Fabien-Chouteau/Wee-Noise-Maker/README.md

The [PGB-1 Firmware is now hosted on a different repo](https://github.com/wee-noise-makers/WNM-PGB1-firmware).
