Fabien-Chouteau/Wee-Noise-Maker/docs/media/pictures/discovery/discovery_rev_A_2.JPG

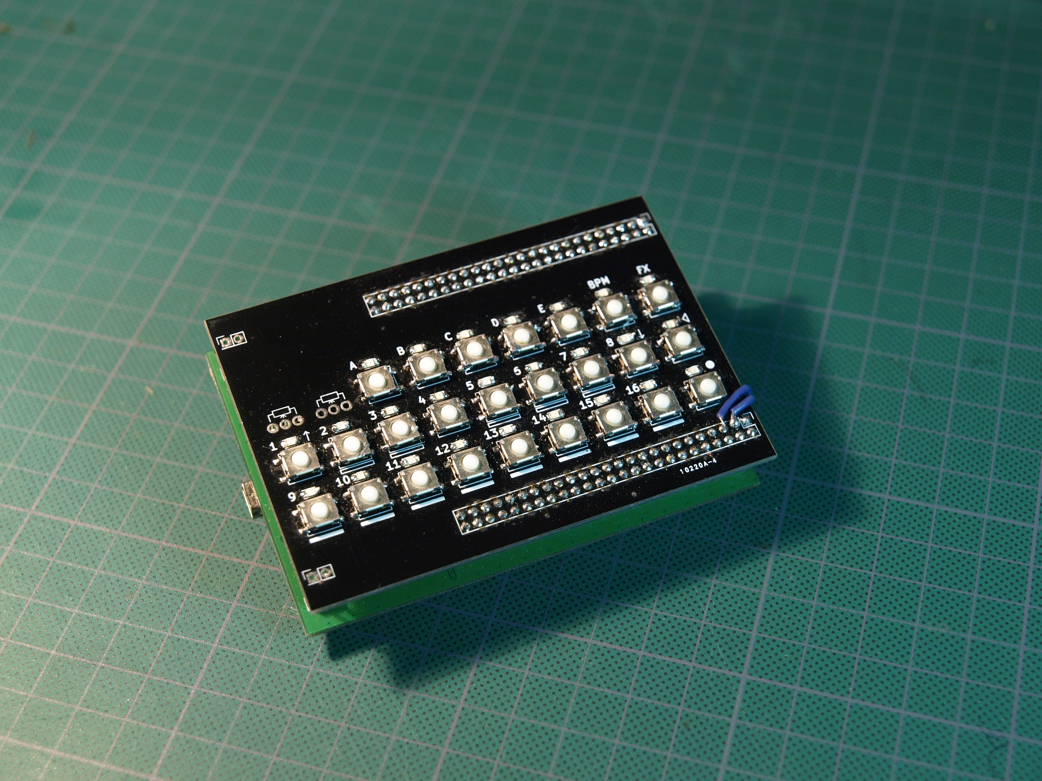
docs/media/pictures/discovery/discovery_rev_A_2.JPG
