Fabien-Chouteau/Wee-Noise-Maker/docs/media/pictures/discovery/discovery_rev_A_3.JPG

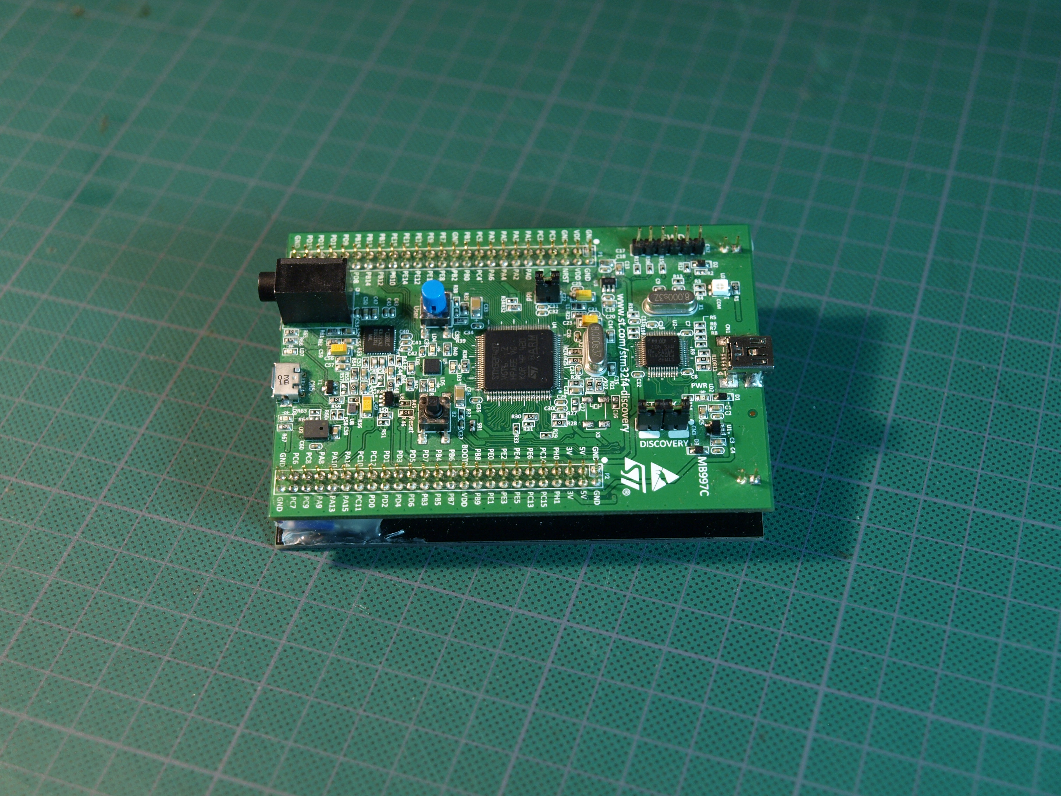
docs/media/pictures/discovery/discovery_rev_A_3.JPG
