Fabien-Chouteau/Wee-Noise-Maker/docs/media/pictures/discovery/discovery_rev_B_BB_1.JPG

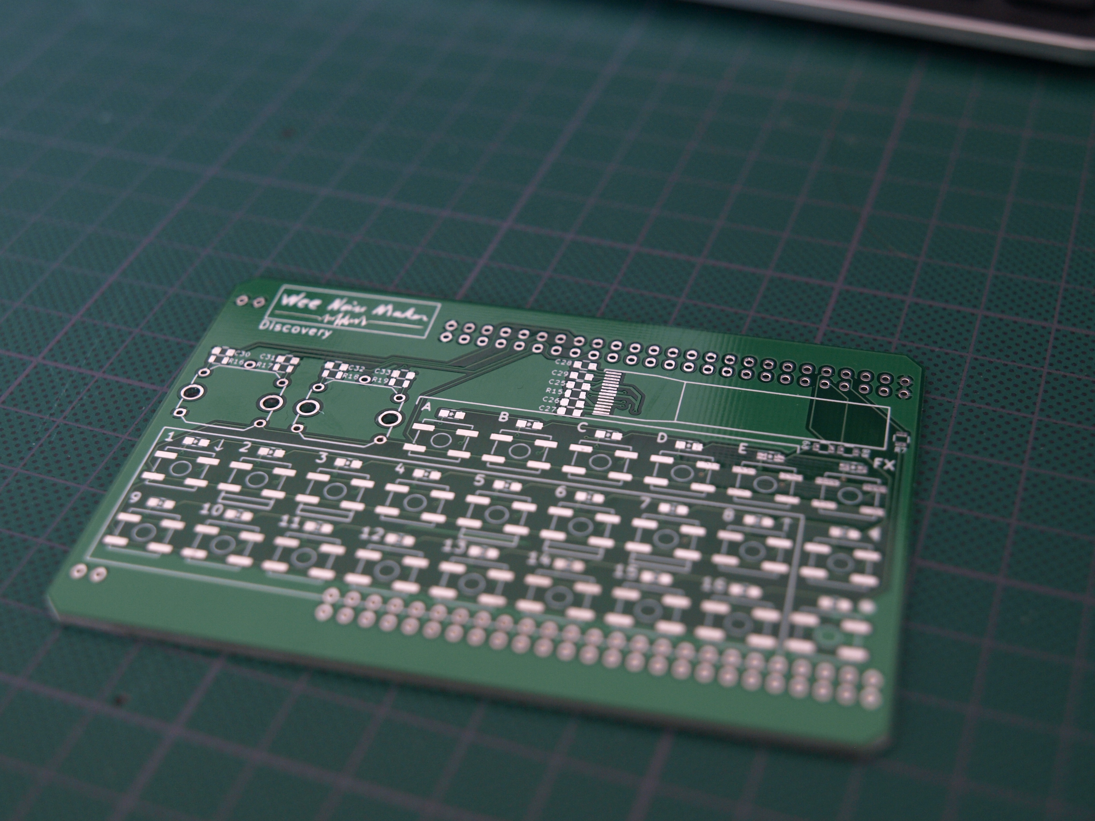
docs/media/pictures/discovery/discovery_rev_B_BB_1.JPG
