Fabien-Chouteau/Wee-Noise-Maker/docs/media/pictures/discovery/discovery_rev_B_BB_3.JPG

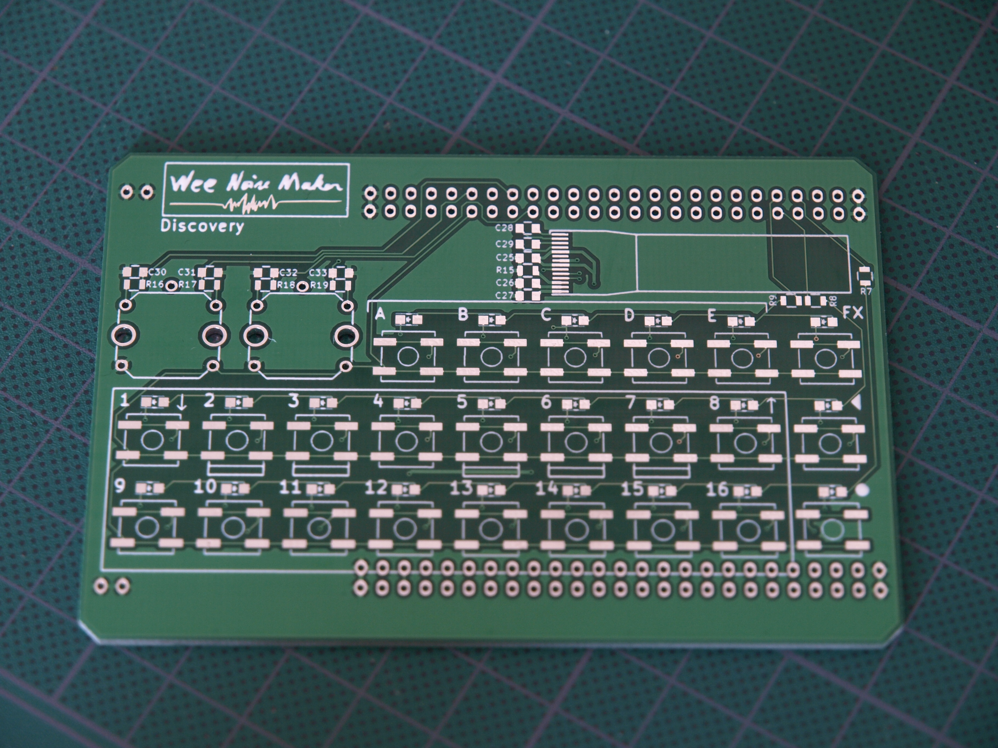
docs/media/pictures/discovery/discovery_rev_B_BB_3.JPG
