Fabien-Chouteau/Wee-Noise-Maker/docs/media/pictures/Mk-I/Mk-I_rev_B_BB_1.JPG

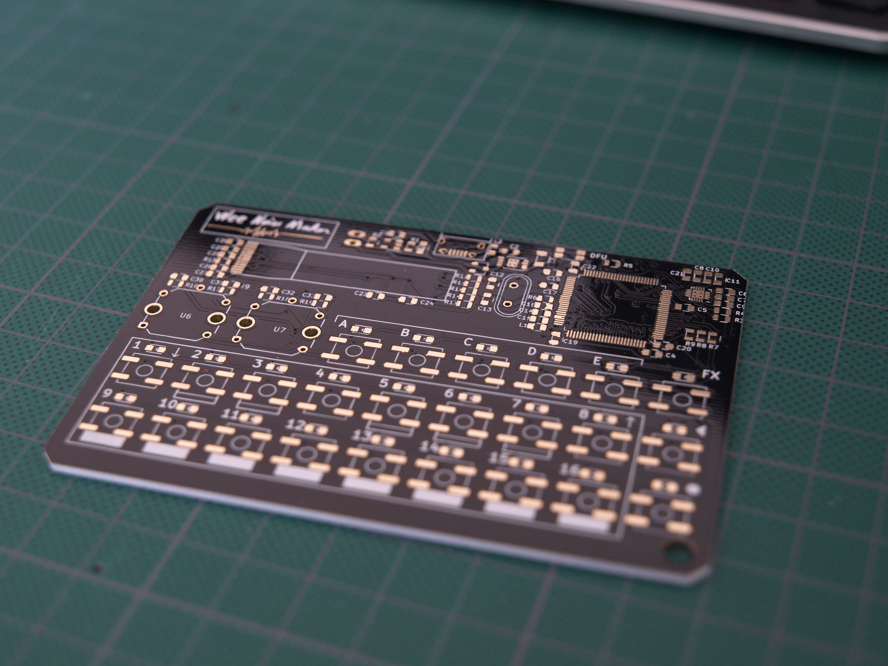
docs/media/pictures/Mk-I/Mk-I_rev_B_BB_1.JPG
