Fabien-Chouteau/Wee-Noise-Maker/docs/media/pictures/Mk-I/Mk-I_rev_B_BB_2.JPG

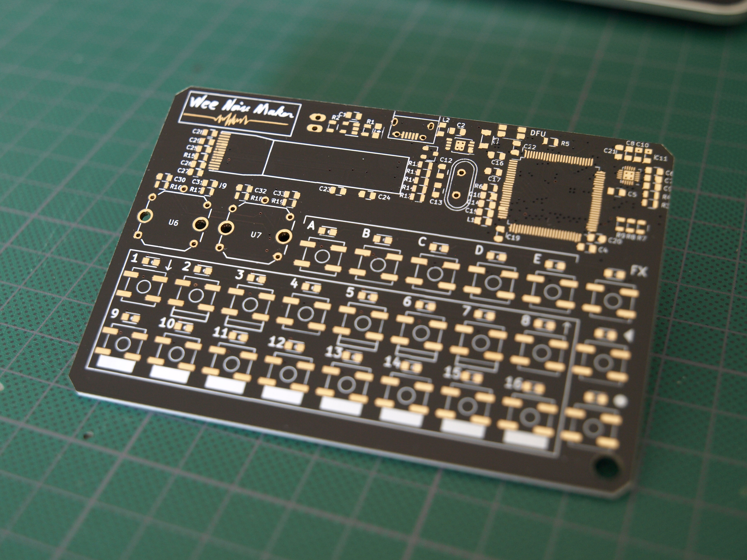
docs/media/pictures/Mk-I/Mk-I_rev_B_BB_2.JPG
