Fabien-Chouteau/Wee-Noise-Maker/docs/media/pictures/Mk-I/Mk-I_rev_C_4.JPG

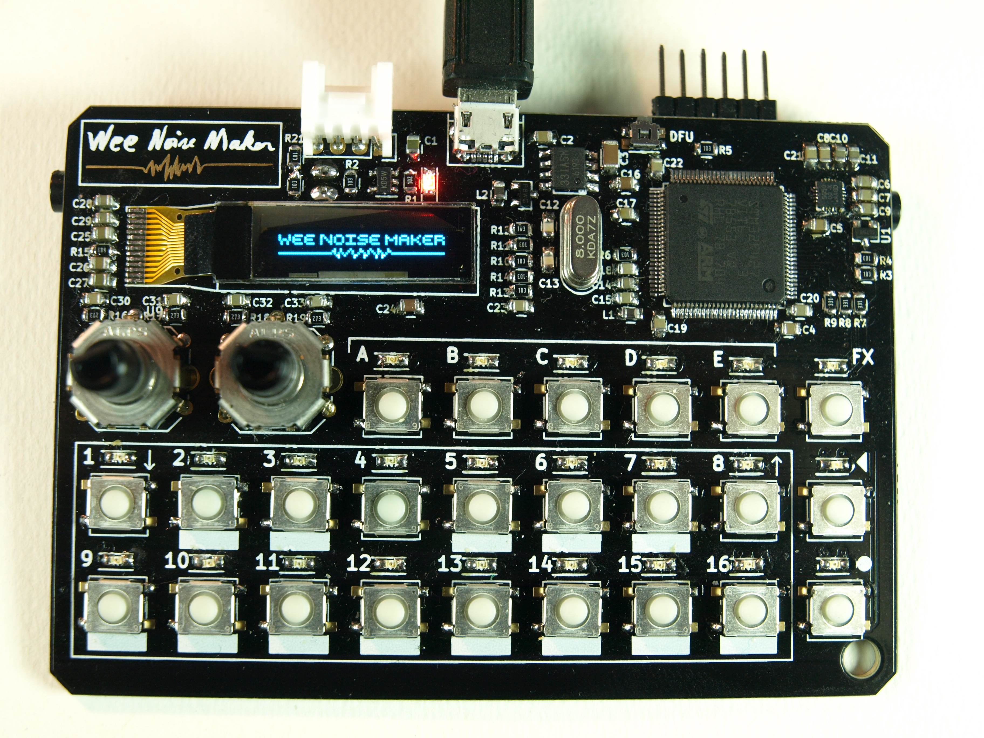
docs/media/pictures/Mk-I/Mk-I_rev_C_4.JPG
