Fabien-Chouteau/Wee-Noise-Maker/docs/media/pictures/Mk-I/Mk-I_rev_C_5.JPG

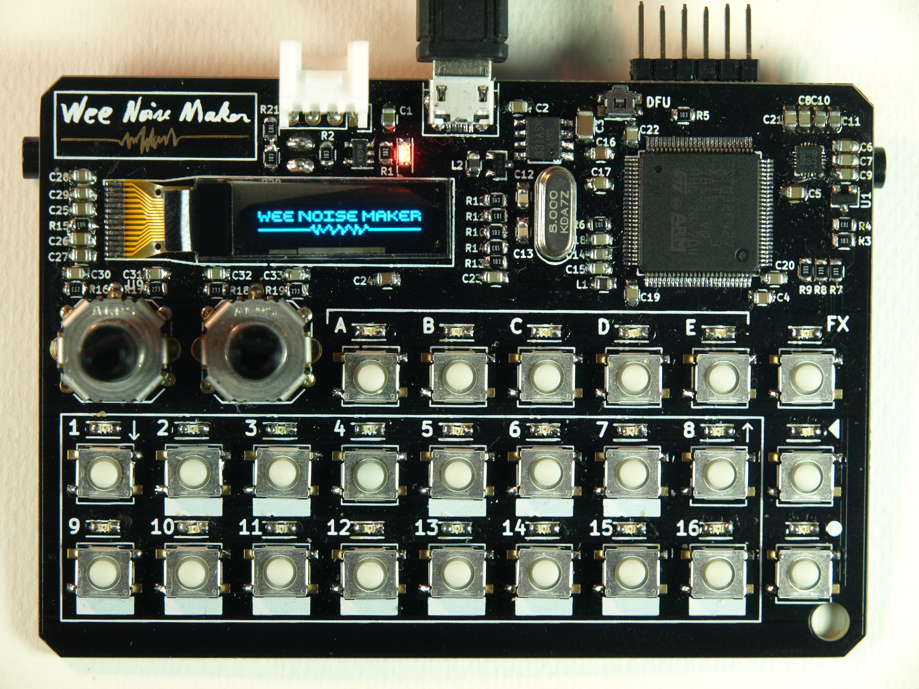
docs/media/pictures/Mk-I/Mk-I_rev_C_5.JPG
