Fabien-Chouteau/Wee-Noise-Maker/hardware/3D_models/for_print/crank.stl

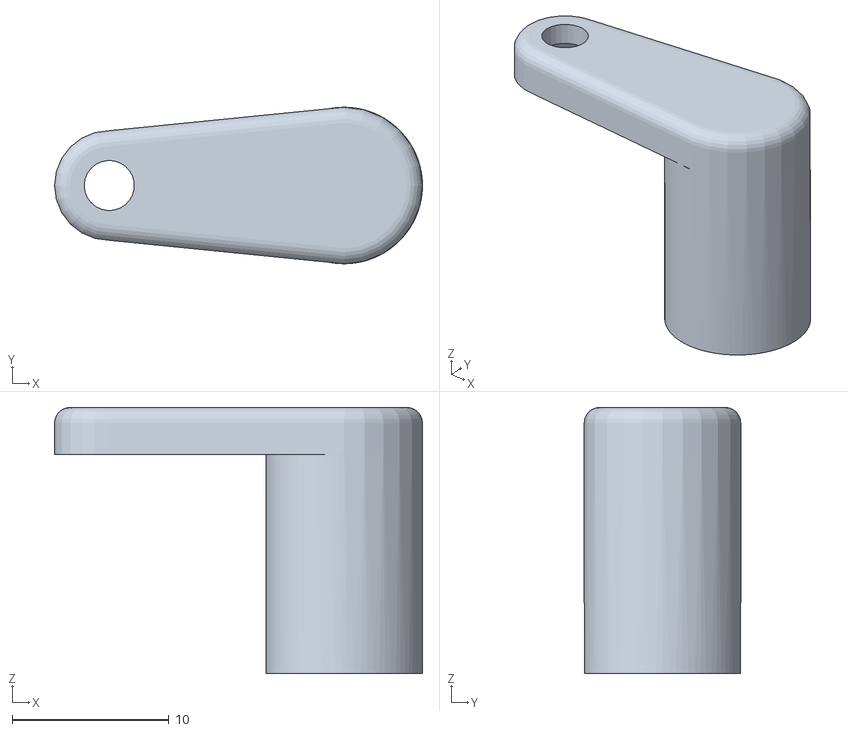
[picture p18: CAD file, 2017-01-17]
hardware/3D_models/for_print/crank.stl
23.5 x 10.0 x 17.0
