Fabien-Chouteau/Wee-Noise-Maker/hardware/3D_models/SJ_352X_SMT.fcstd

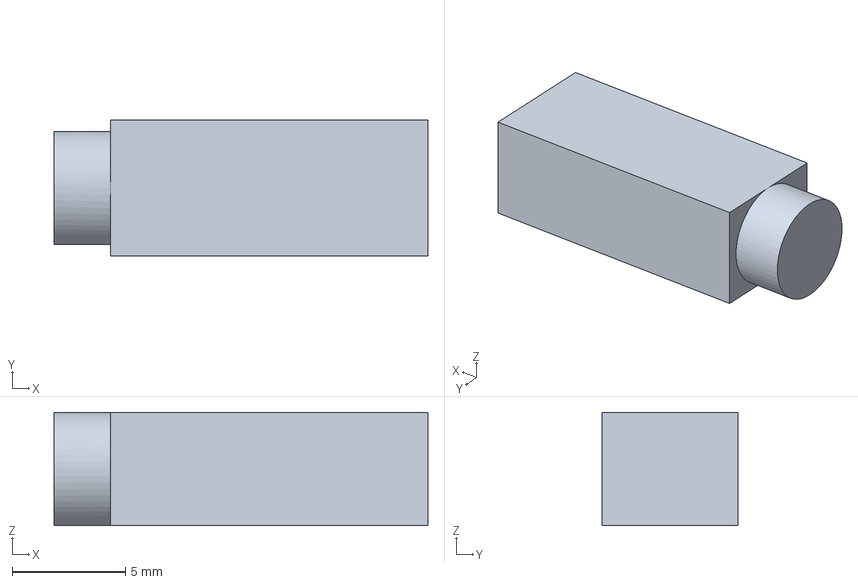
[picture p19: CAD file, 2017-10-22]
hardware/3D_models/SJ_352X_SMT.fcstd
16.5 x 6.00 x 5.00 mm
