Fabien-Chouteau/Wee-Noise-Maker/hardware/3D_models/EC12D_knob.FCStd

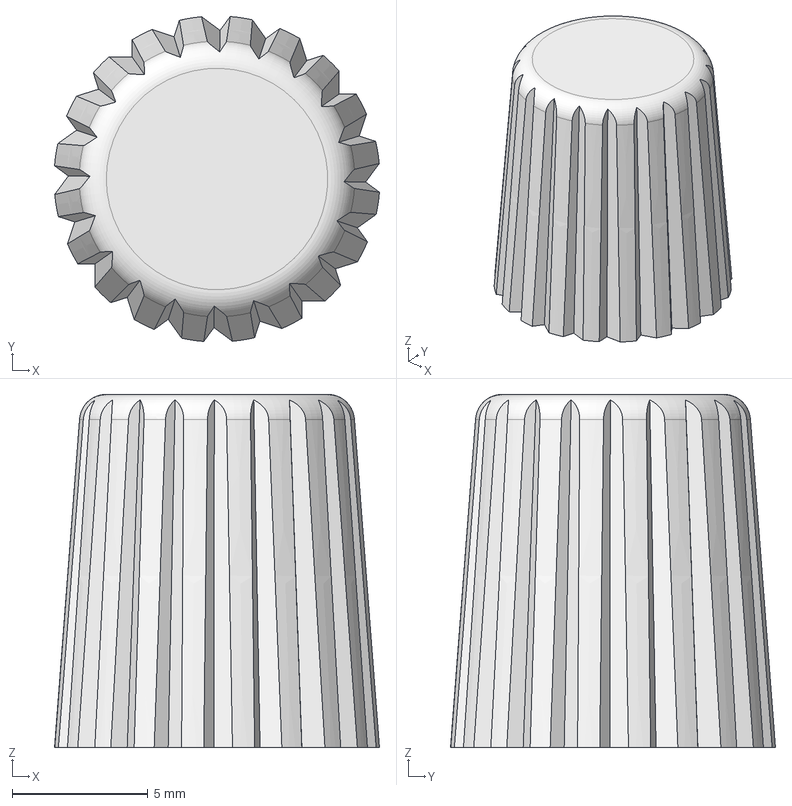
[picture p20: CAD file, 2017-01-17]
hardware/3D_models/EC12D_knob.FCStd
12.0 x 12.0 x 13.0 mm
