Fabien-Chouteau/Wee-Noise-Maker/hardware/3D_models/EC12D_crank.FCStd

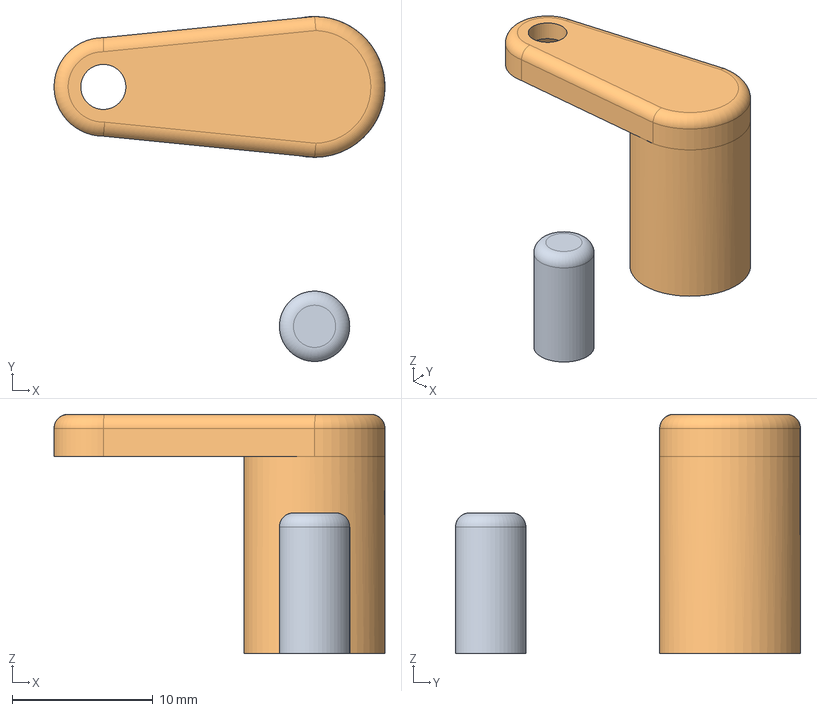
[picture p21: CAD file, 2017-01-17]
hardware/3D_models/EC12D_crank.FCStd
23.5 x 24.5 x 17.0 mm
