Fabien-Chouteau/Wee-Noise-Maker/hardware/3D_models/for_print/crank_knob.stl

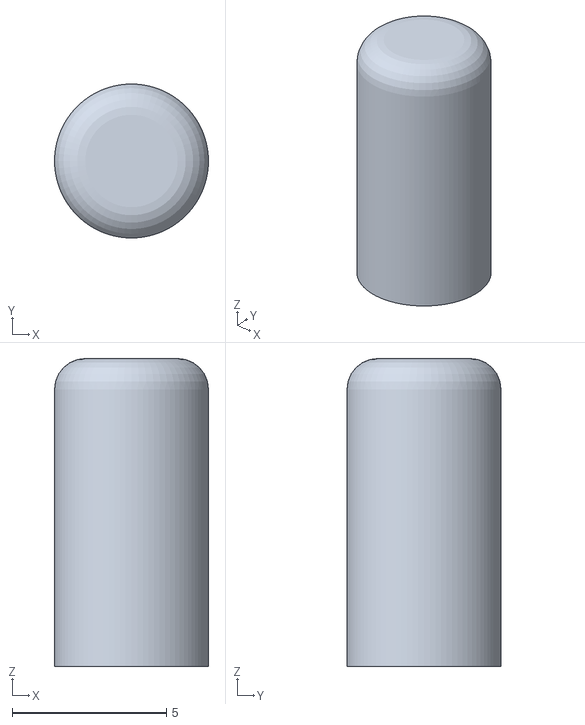
[picture p22: CAD file, 2017-01-17]
hardware/3D_models/for_print/crank_knob.stl
5.00 x 5.00 x 10.0
