Fabien-Chouteau/Wee-Noise-Maker/hardware/3D_models/EC12D.FCStd

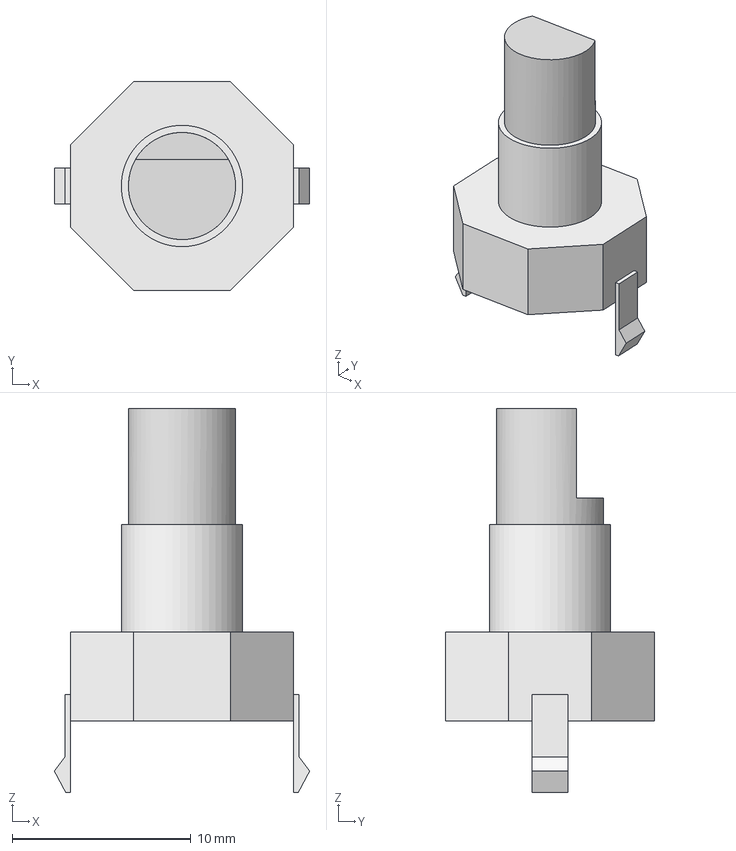
[picture p23: CAD file, 2017-01-05]
hardware/3D_models/EC12D.FCStd
14.3 x 11.7 x 21.5 mm
Mirror of Pocket002
