Fabien-Chouteau/Wee-Noise-Maker/(list of files, cad)

Other CAD files:
hardware/3D_models/for_print/knob.stl
