Fabien-Chouteau/Wee-Noise-Maker/hardware/discovery/Rev_B/wnm_discovery_Rev_B_schematics.pdf

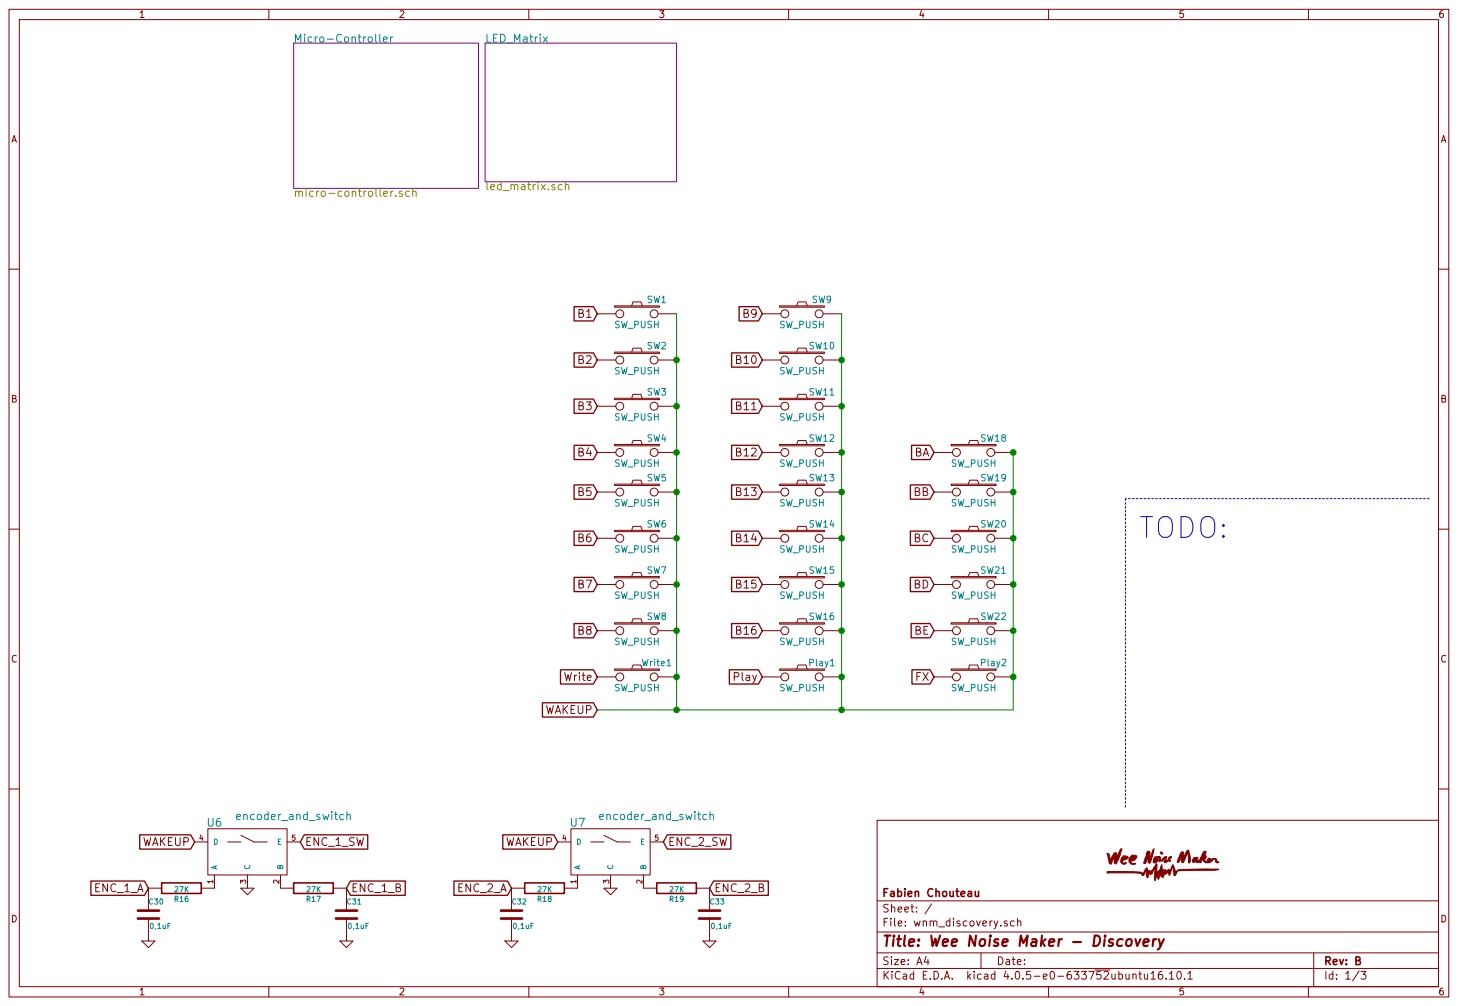
[picture p24: page 1]

File: wnm_discovery.sch Sheet: / Fabien Chouteau

Id: 1/3 Title: Wee Noise Maker - Discovery

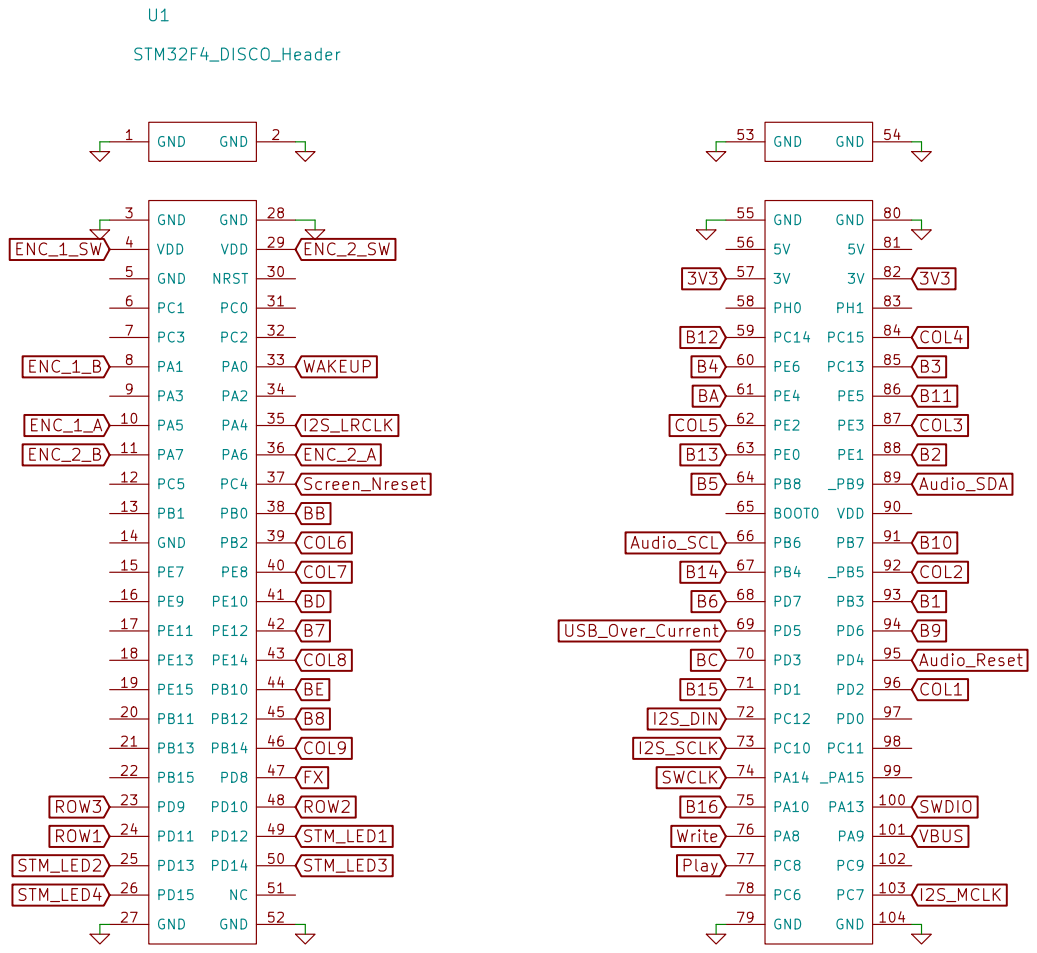
[picture p25: page 2]

File: micro-controller.sch Sheet: /Micro-Controller/ Fabien Chouteau

Id: 2/3 Title: Wee Noise Maker - Discovery

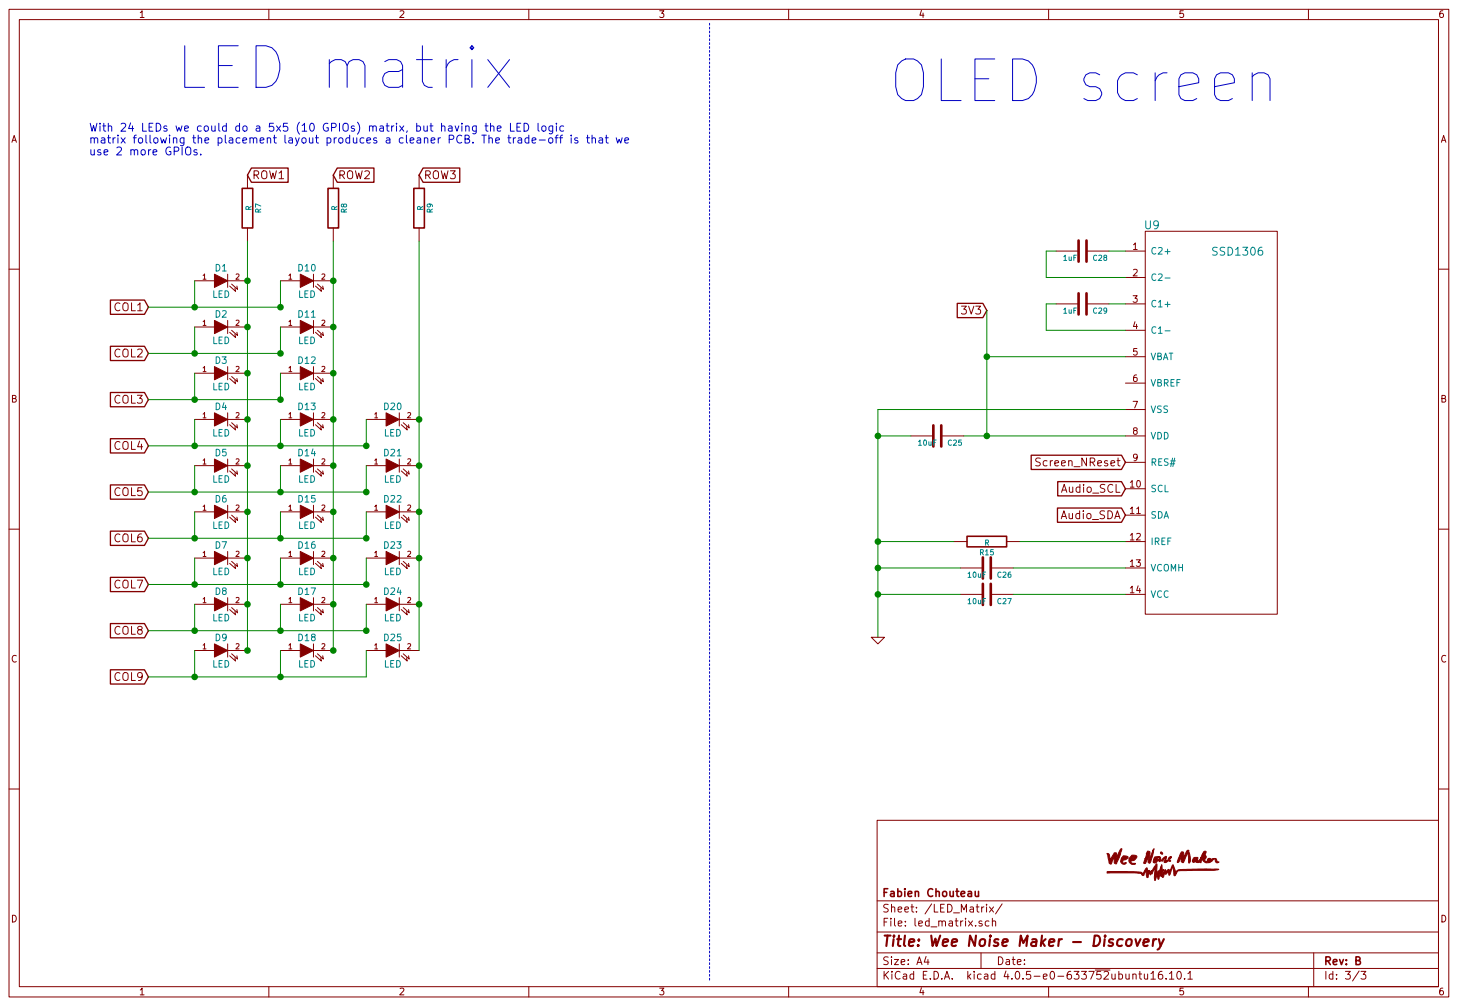
[picture p26: page 3]

With 24 LEDs we could do a 5x5 (10 GPIOs) matrix, but having the LED logic
matrix following the placement layout produces a cleaner PCB. The trade-off is that we

File: led_matrix.sch
Id: 3/3 Title: Wee Noise Maker - Discovery
