Fabien-Chouteau/Wee-Noise-Maker/hardware/Mk-I/Rev_D/wnm_mk_1_rev_D_layout.pdf

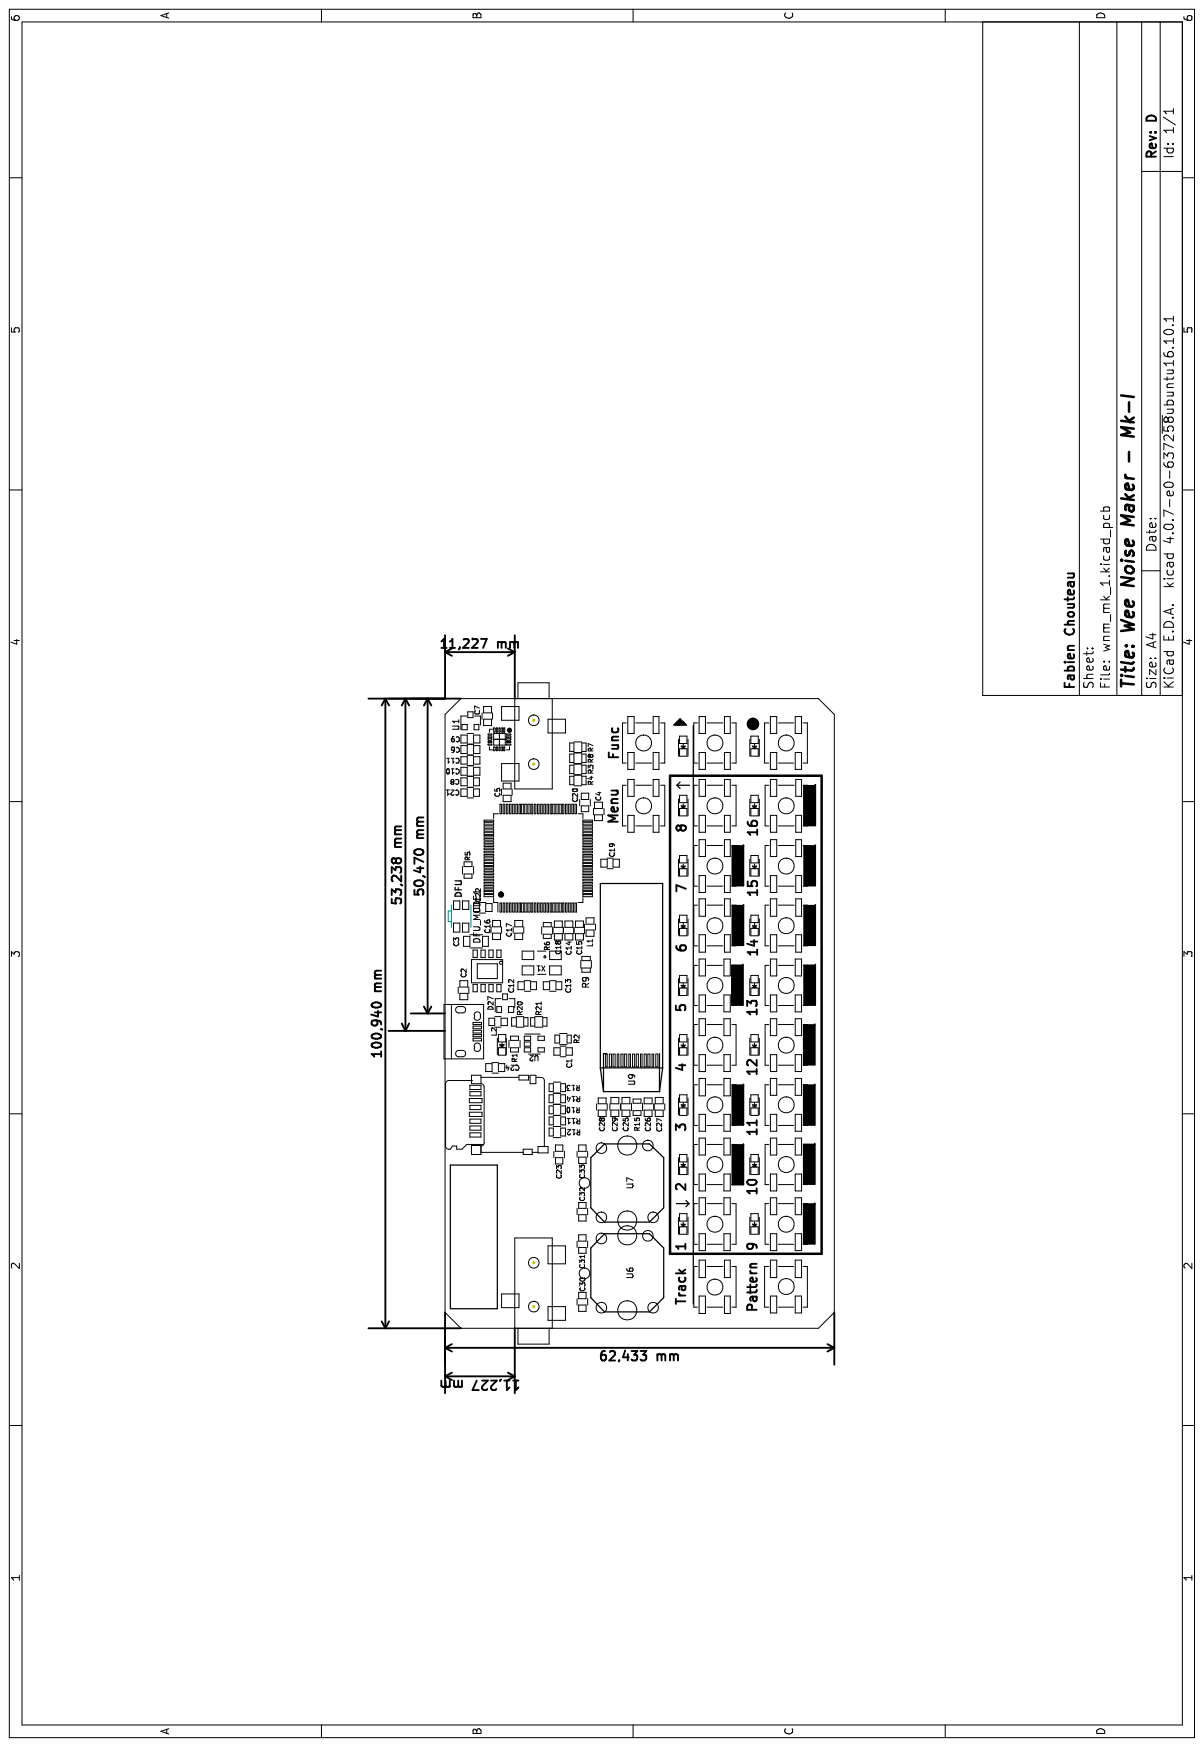
[picture p27: page 1]
