Fabien-Chouteau/Wee-Noise-Maker/hardware/Mk-I/Rev_C/wnm_mk_1_rev_C_schematics.pdf

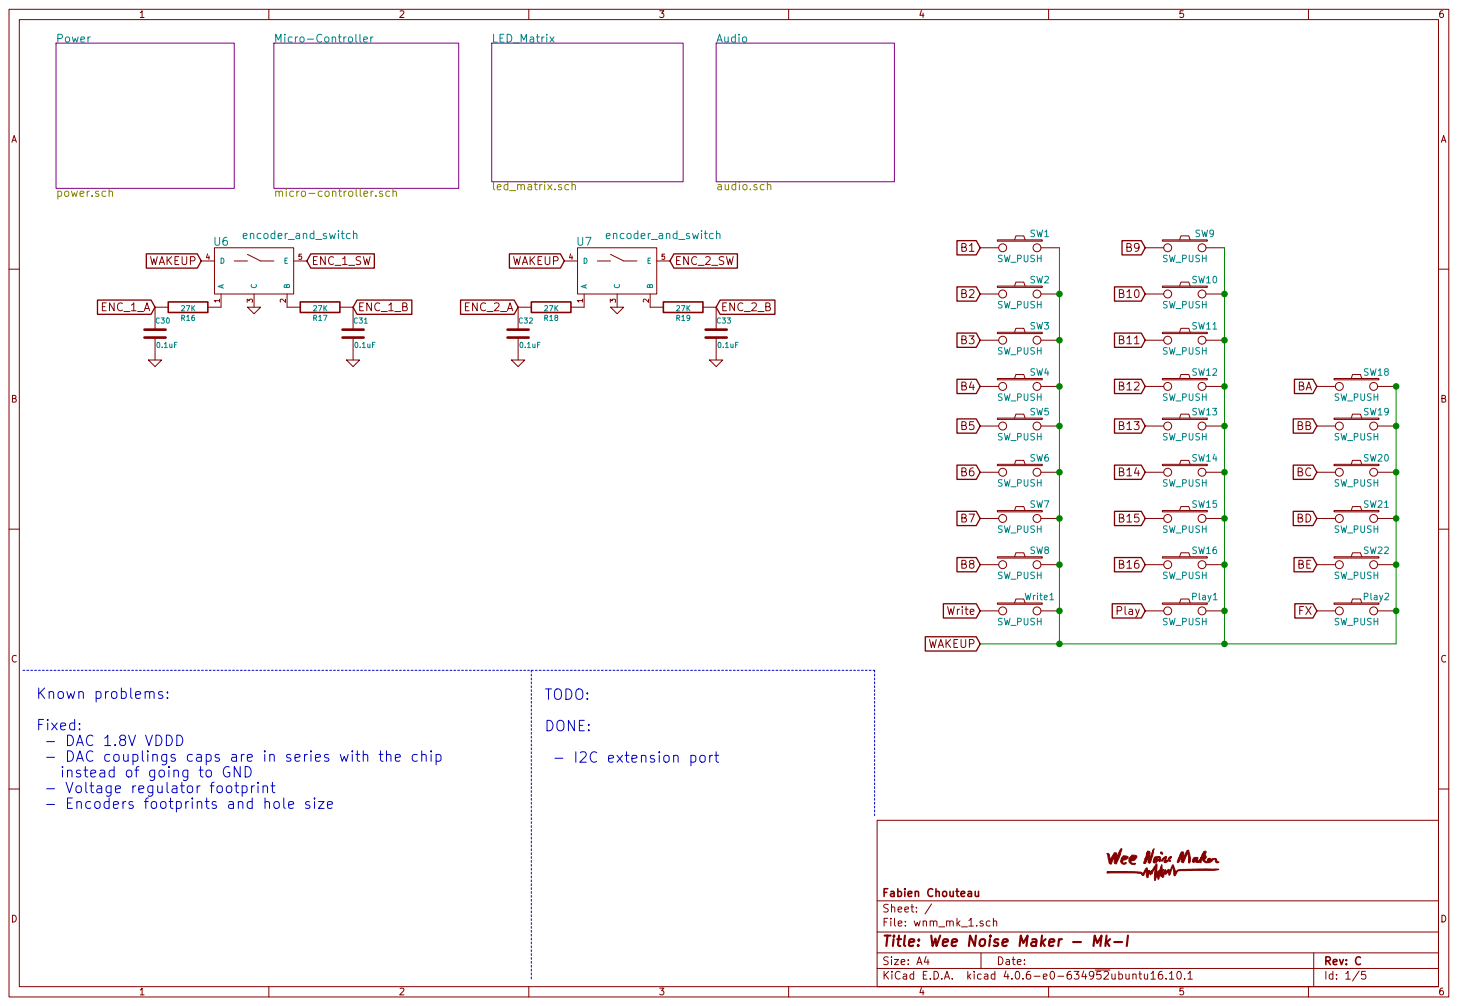
[picture p34: page 1]

Micro-Controller micro-controller.sch

Known problems:
Fixed:
- DAC 1.8V VDDD
- DAC couplings caps are in series with the chip
instead of going to GND
- Voltage regulator footprint
- Encoders footprints and hole size

File: wnm_mk_1.sch Sheet: / Fabien Chouteau

Id: 1/5 Title: Wee Noise Maker - Mk-I

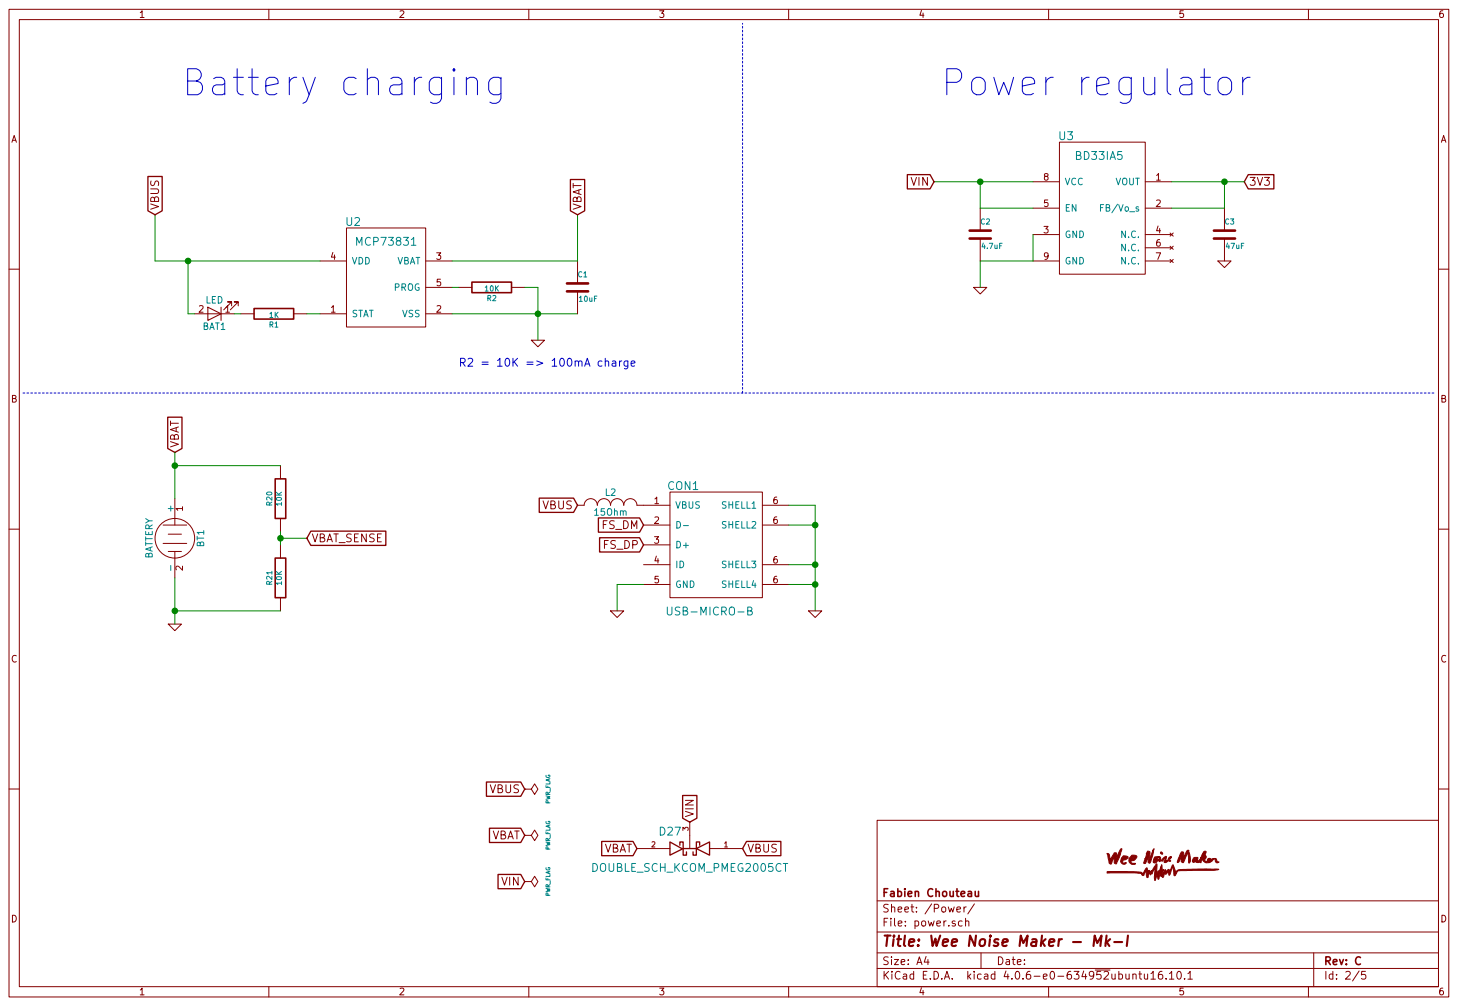
[picture p35: page 2]

File: power.sch Sheet: /Power/ Fabien Chouteau

Id: 2/5 Title: Wee Noise Maker - Mk-I

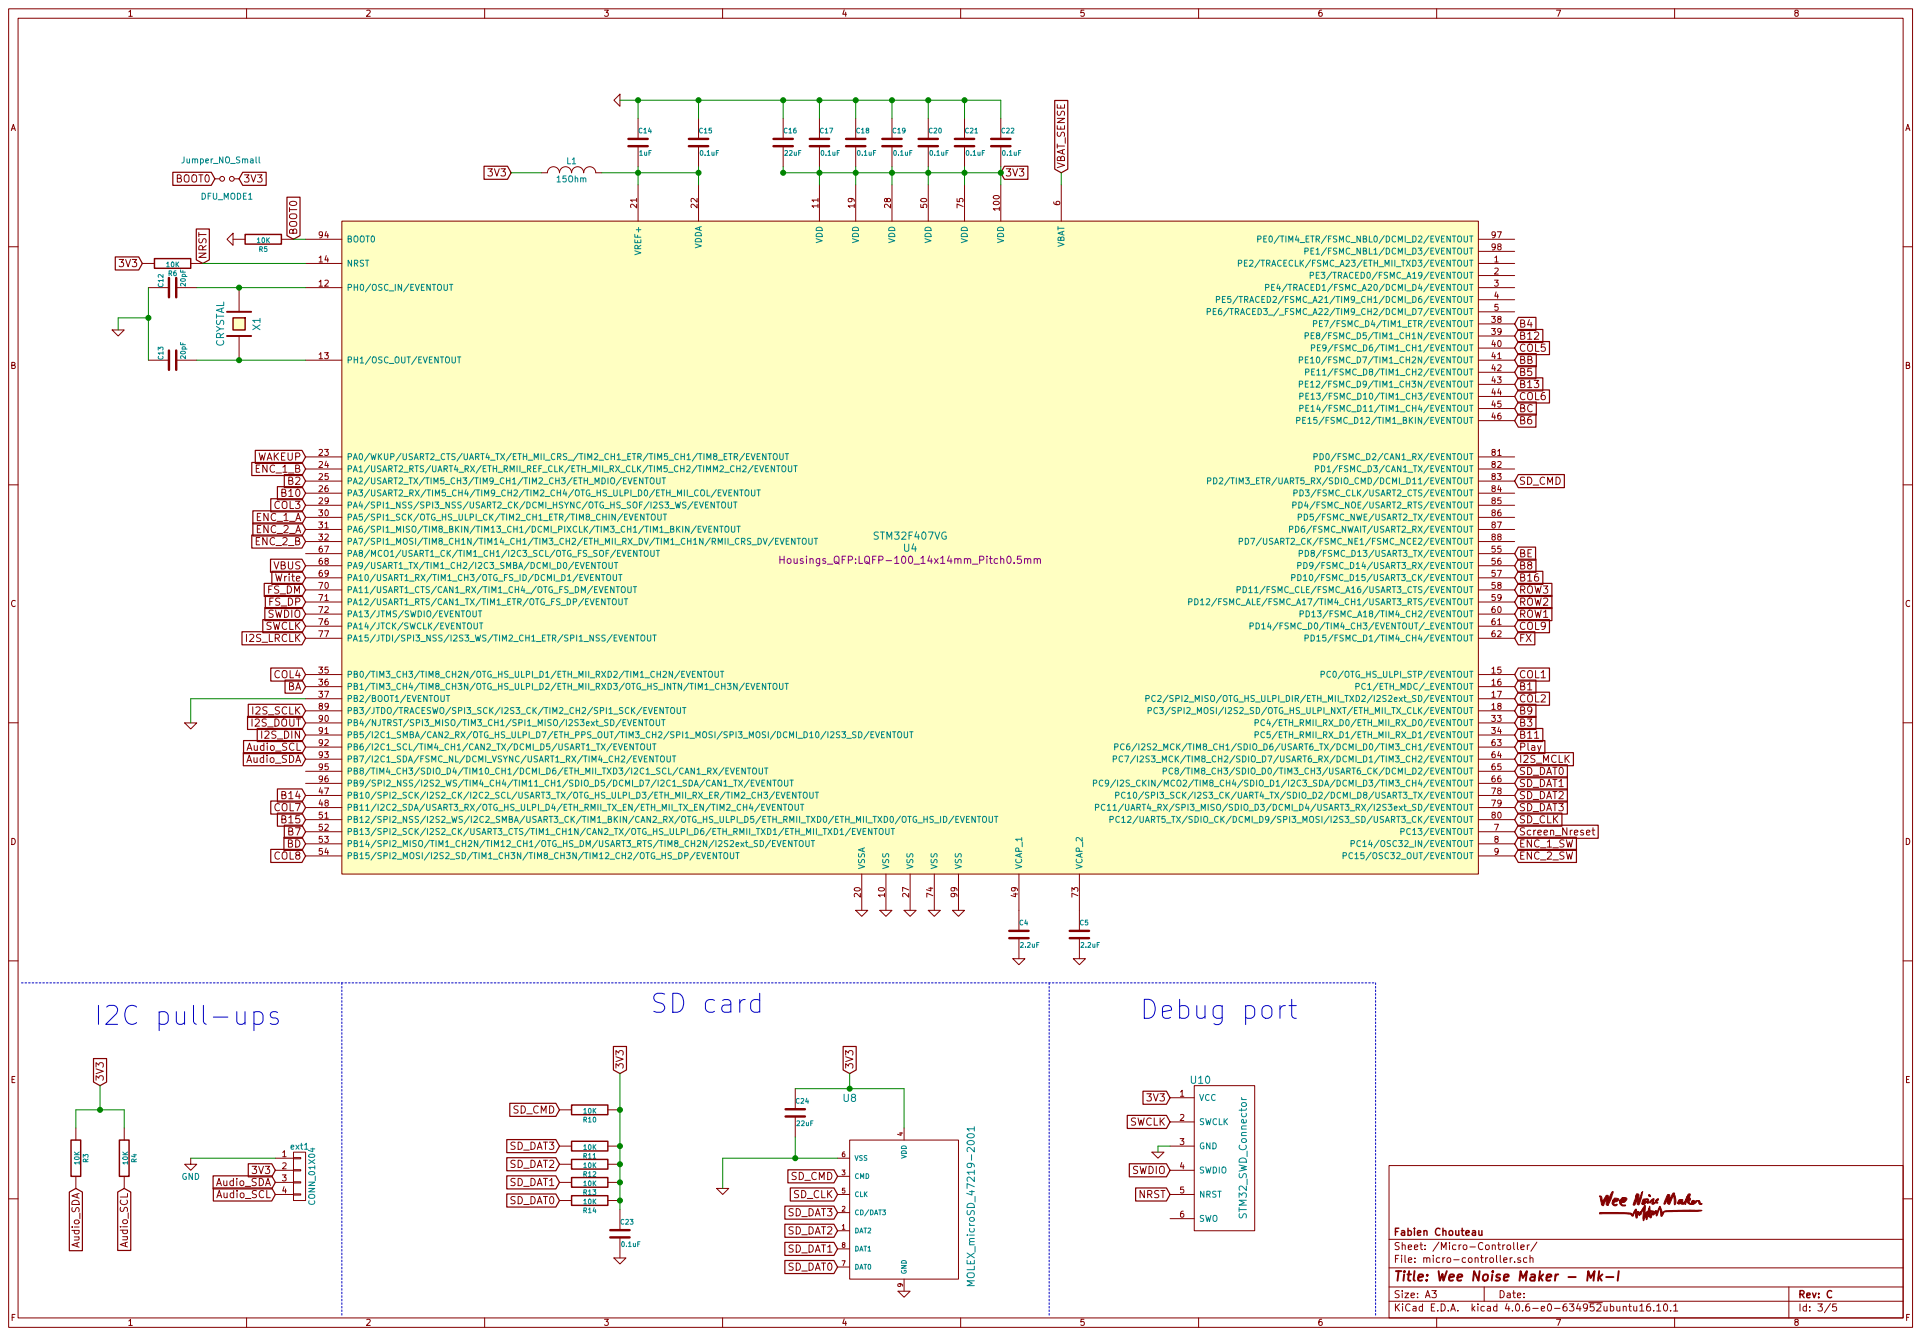
[picture p36: page 3]

6 PC13/EVENTOUT 7 PC14/OSC32_IN/EVENTOUT 8 PC15/OSC32_OUT/EVENTOUT 9 VSS 10 VSSA 20

Id: 3/5 Title: Wee Noise Maker - Mk-I File: micro-controller.sch Sheet: /Micro-Controller/ Fabien Chouteau

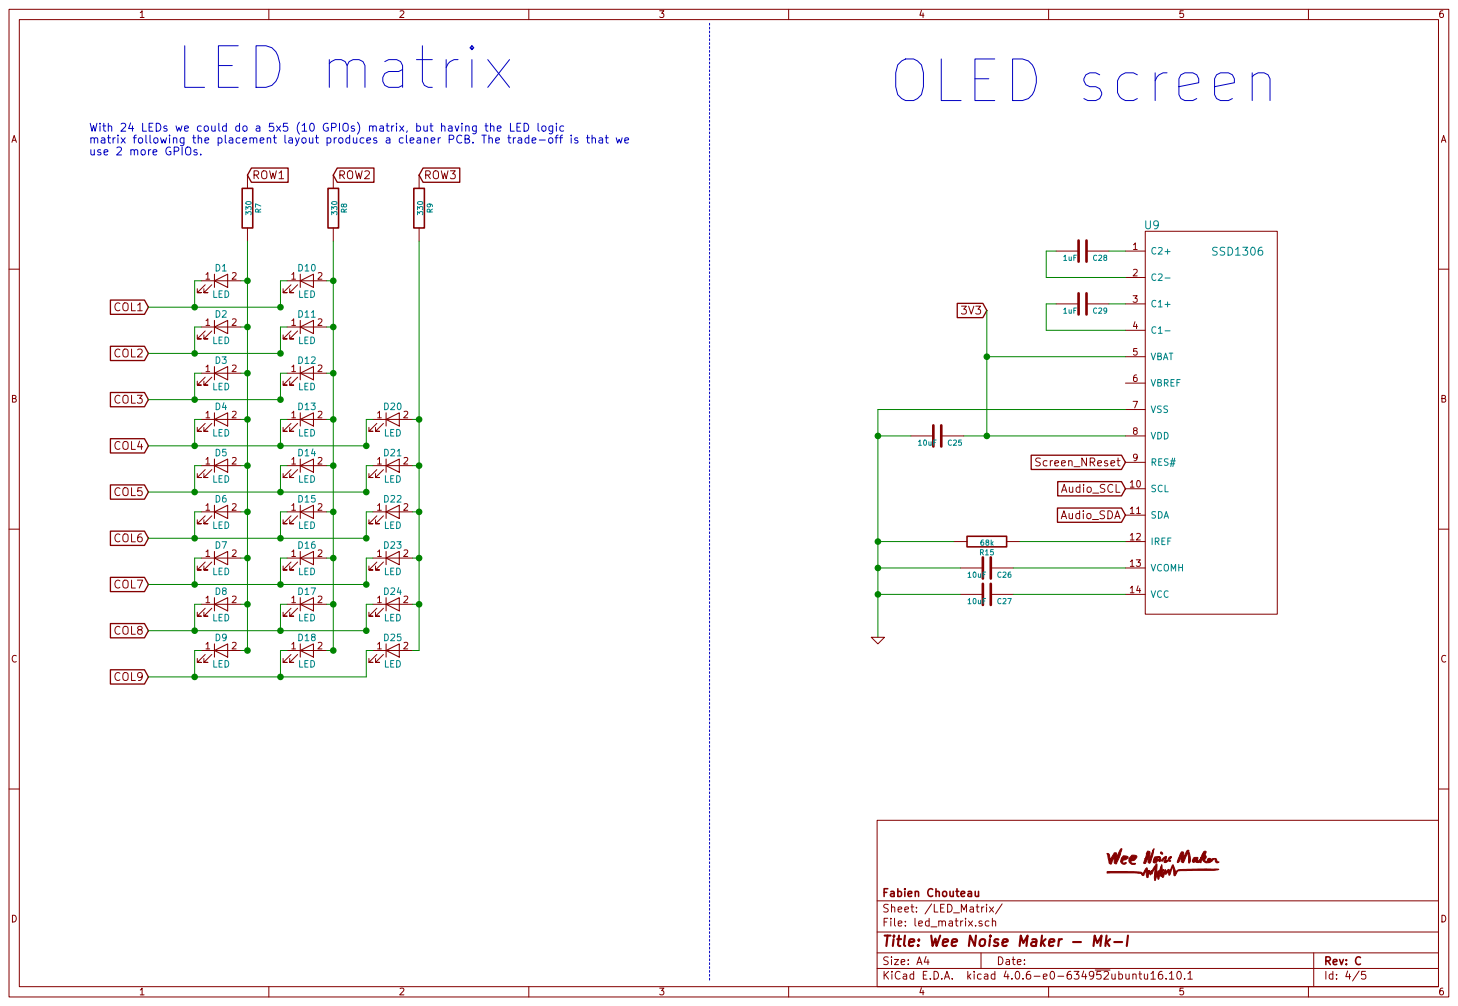
[picture p37: page 4]

With 24 LEDs we could do a 5x5 (10 GPIOs) matrix, but having the LED logic
matrix following the placement layout produces a cleaner PCB. The trade-off is that we

10uF C25 R15 Audio_SDA

File: led_matrix.sch
Id: 4/5 Title: Wee Noise Maker - Mk-I

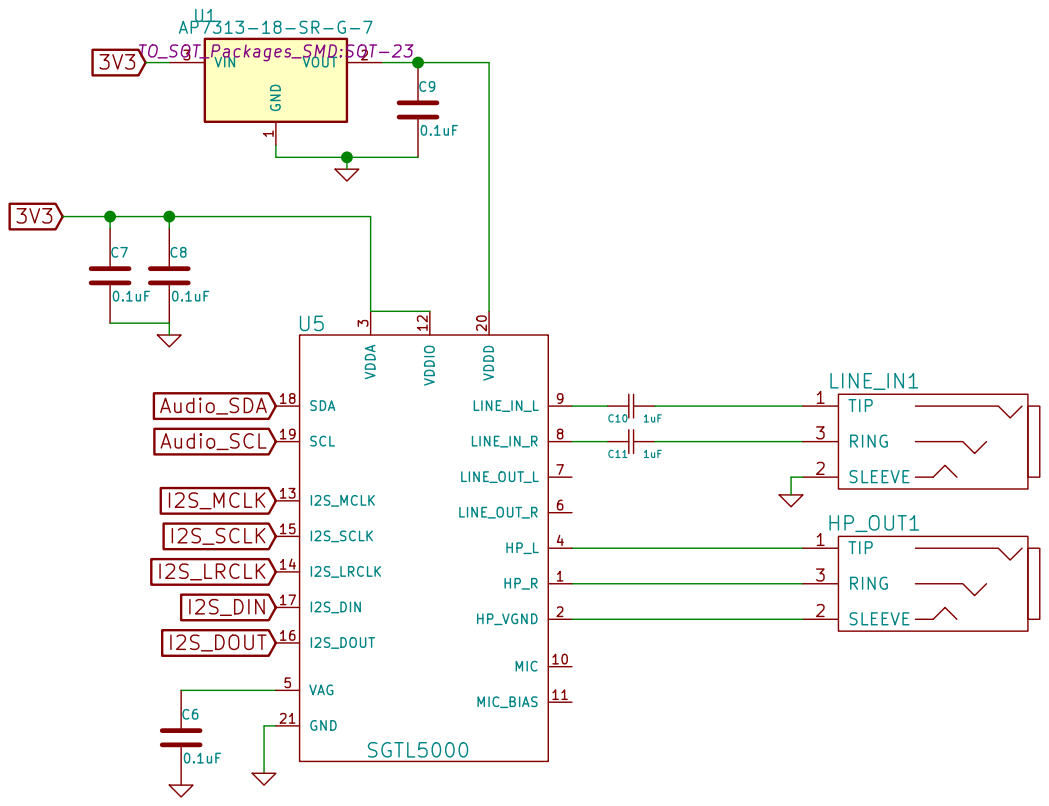
[picture p38: page 5]

1 VOUT 2 VIN 3 U1AP7313-18-SR-G-7 TO_SOT_Packages_SMD:SOT-23 3V3

Id: 5/5 Title: Wee Noise Maker - Mk-I File: audio.sch Sheet: /Audio/ Fabien Chouteau Audio_SDA
Audio_SCL
