Fabien-Chouteau/Wee-Noise-Maker/hardware/Mk-I/Rev_A/wnm_mk_1_rev_A_schematics.pdf

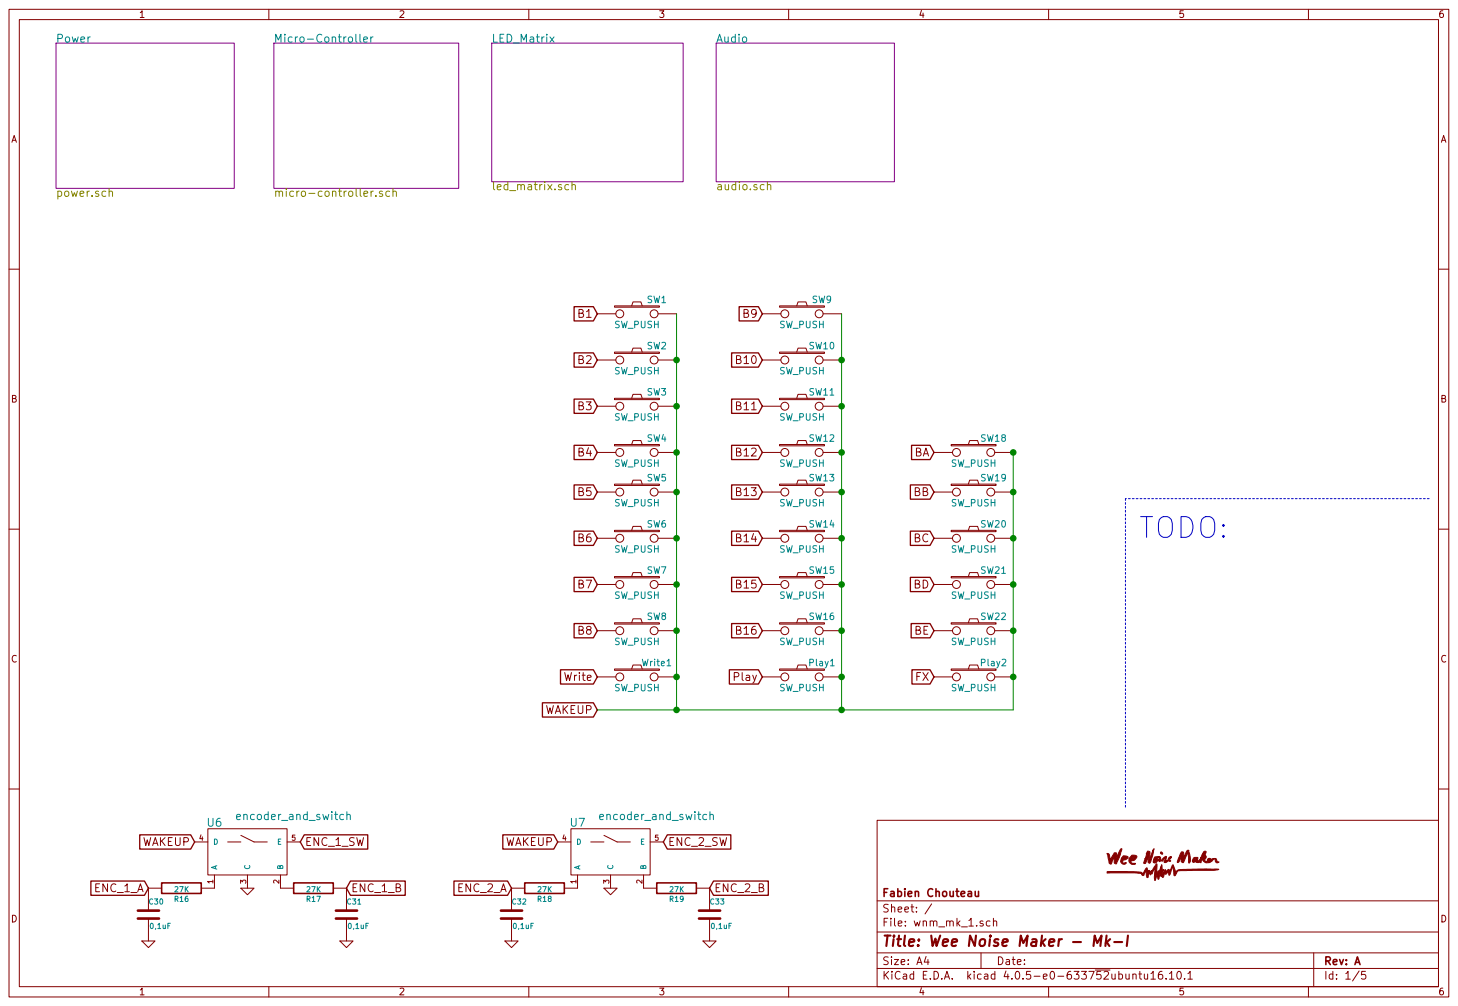
[picture p44: page 1]

Micro-Controller micro-controller.sch

File: wnm_mk_1.sch Sheet: / Fabien Chouteau

Id: 1/5 Title: Wee Noise Maker - Mk-I

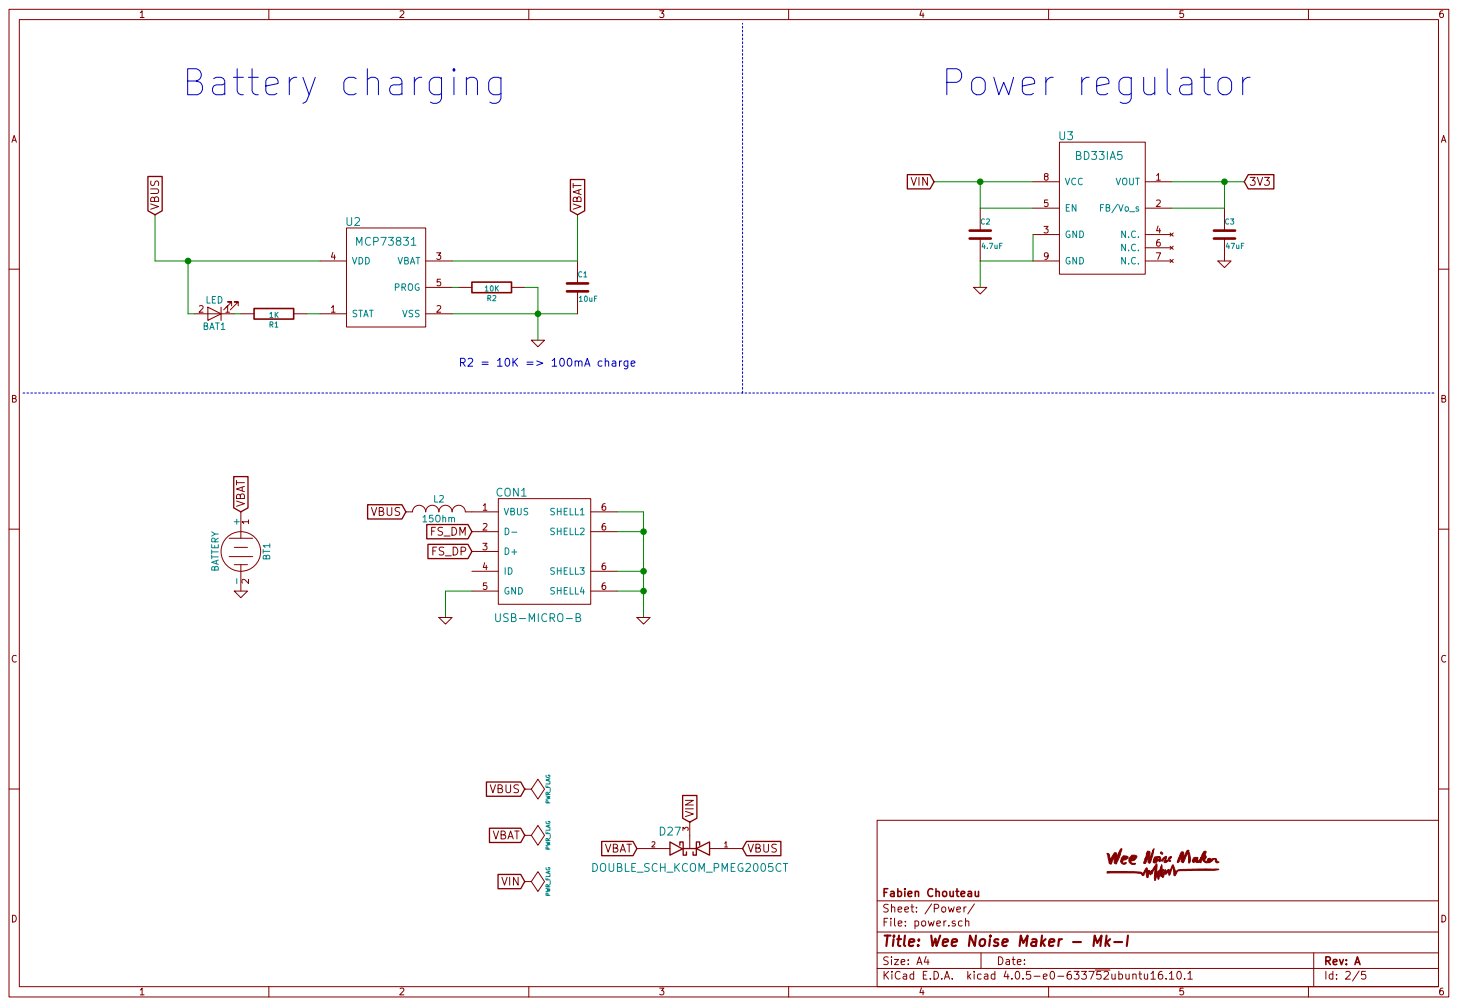
[picture p45: page 2]

File: power.sch Sheet: /Power/ Fabien Chouteau

Id: 2/5 Title: Wee Noise Maker - Mk-I

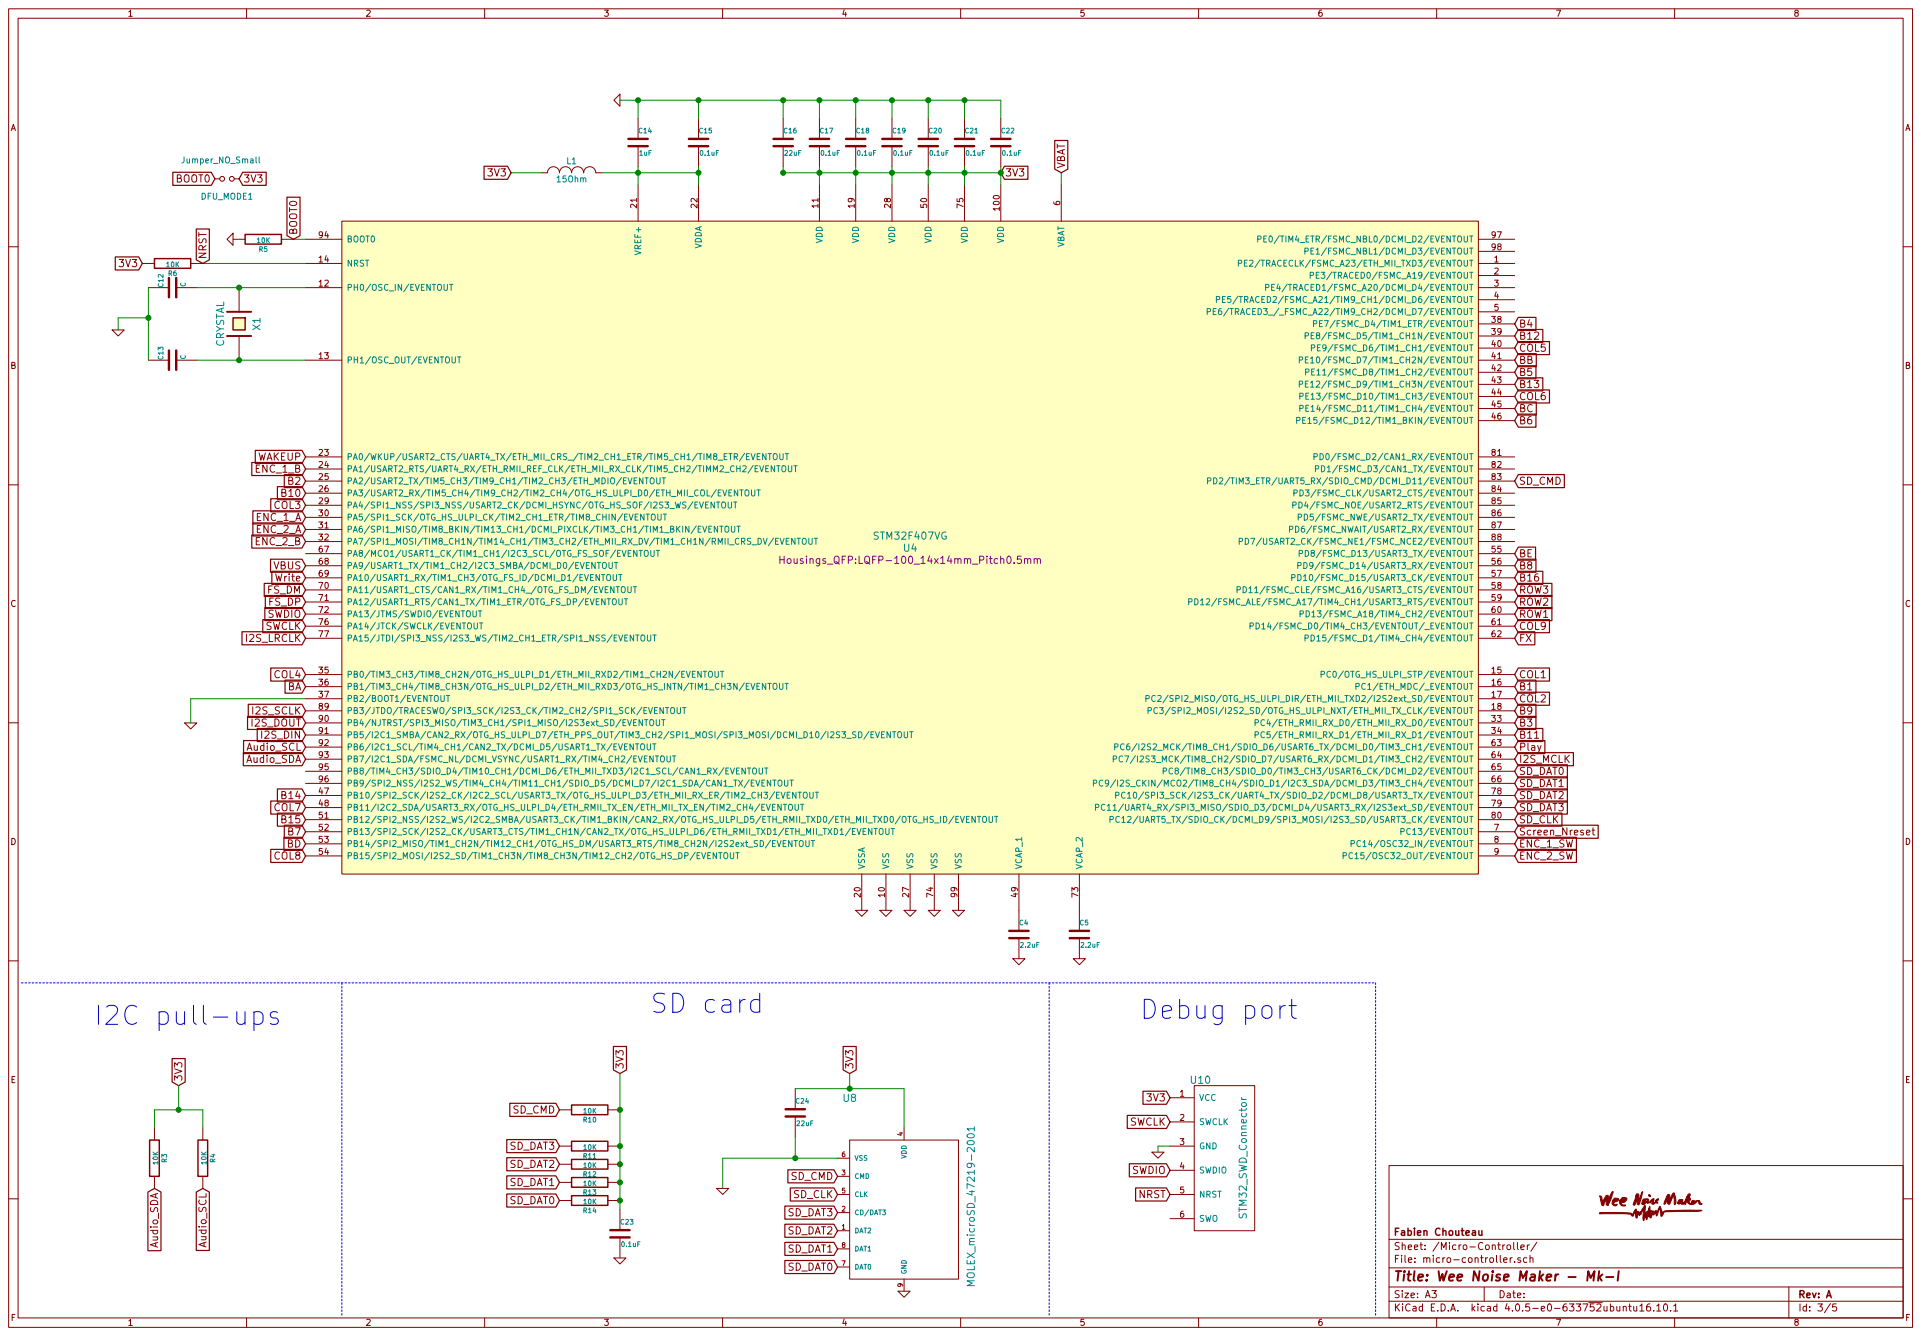
[picture p46: page 3]

6 PC13/EVENTOUT 7 PC14/OSC32_IN/EVENTOUT 8 PC15/OSC32_OUT/EVENTOUT 9 VSS 10 VSSA 20

Id: 3/5 Title: Wee Noise Maker - Mk-I File: micro-controller.sch Sheet: /Micro-Controller/ Fabien Chouteau

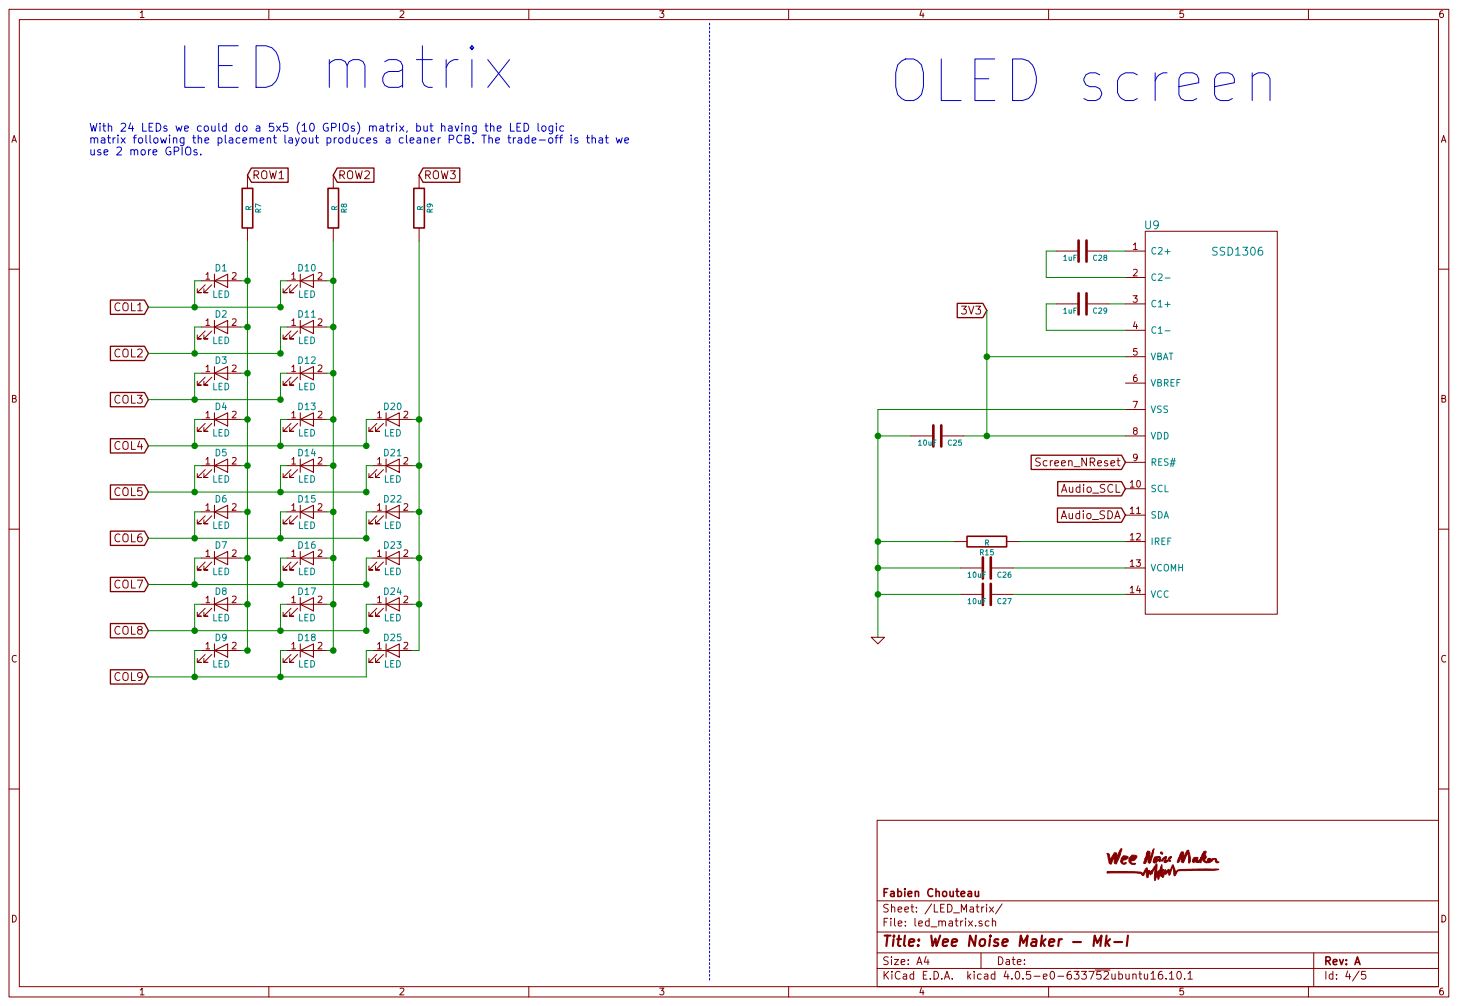
[picture p47: page 4]

With 24 LEDs we could do a 5x5 (10 GPIOs) matrix, but having the LED logic
matrix following the placement layout produces a cleaner PCB. The trade-off is that we

10uF C25 R15 R Audio_SDA

File: led_matrix.sch
Id: 4/5 Title: Wee Noise Maker - Mk-I

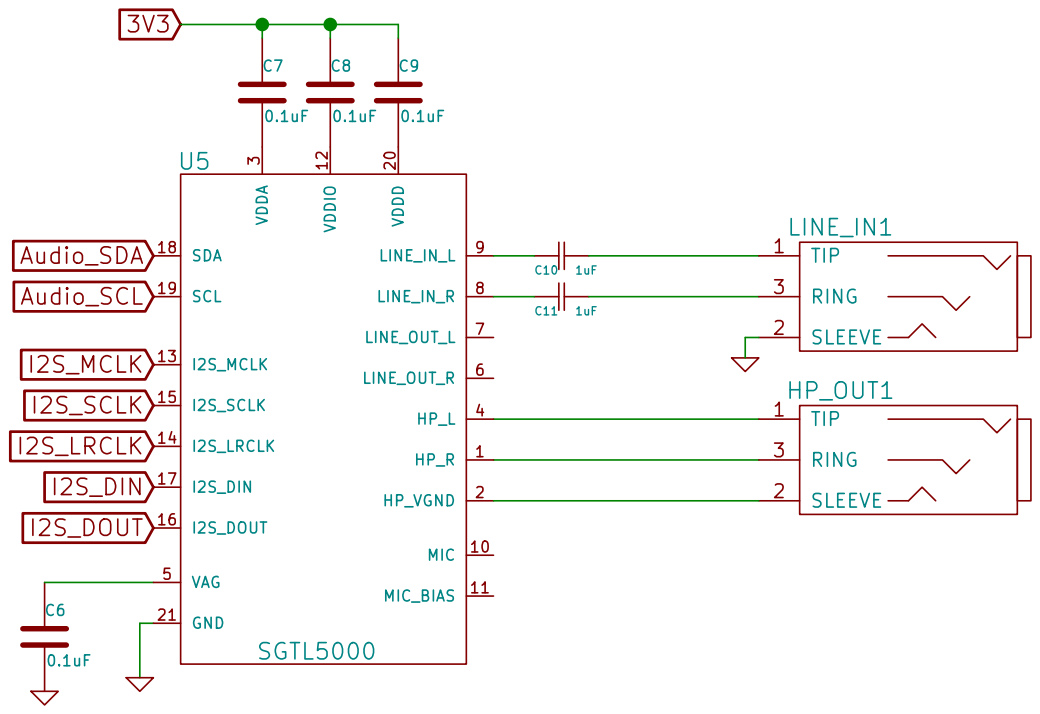
[picture p48: page 5]

Id: 5/5 Title: Wee Noise Maker - Mk-I File: audio.sch Sheet: /Audio/ Fabien Chouteau Audio_SDA
Audio_SCL
