Fabien-Chouteau/Wee-Noise-Maker/hardware/discovery/Rev_A/poss_discovery.pdf

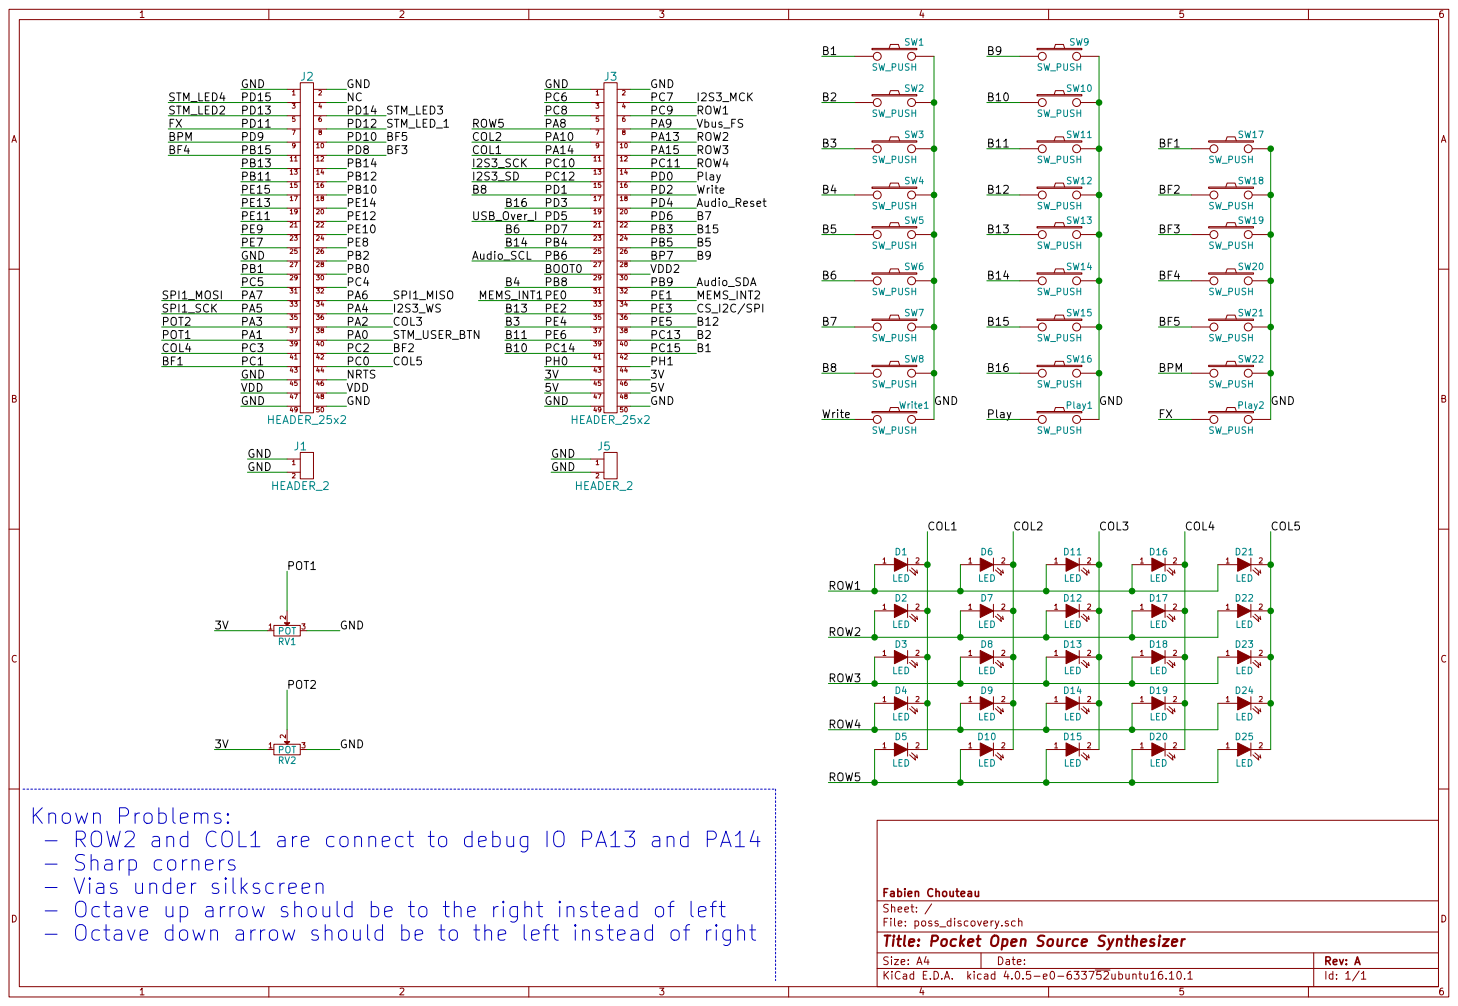
[picture p49: page 1]

Known Problems:
- ROW2 and COL1 are connect to debug IO PA13 and PA14
- Sharp corners
- Vias under silkscreen
- Octave up arrow should be to the right instead of left
- Octave down arrow should be to the left instead of right

File: poss_discovery.sch Sheet: / Fabien Chouteau

Id: 1/1 Title: Pocket Open Source Synthesizer
