Fabien-Chouteau/Wee-Noise-Maker/hardware/Mk-I/wnm_mk_1.kicad_pcb

## KiCad design hardware/Mk-I/wnm_mk_1.kicad_pcb (2017-10-28)

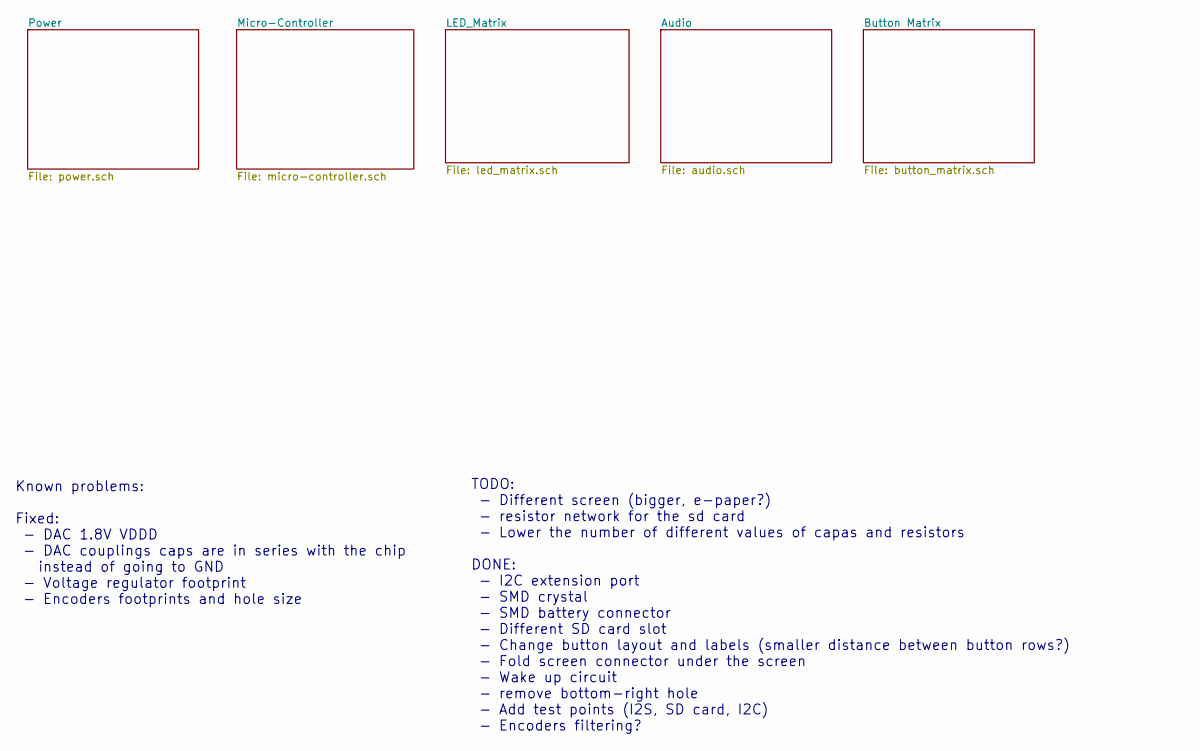
[picture p50: schematic wnm_mk_1.sch, Wee Noise Maker - Mk-I]

Notes on the sheet:
TODO: - Different screen (bigger, e-paper?) - resistor network for the sd card - Lower the number of different values of capas and resistors DONE: - I2C extension port - SMD crystal - SMD battery connector - Different SD card slot - Change button layout and labels (smaller distance between button r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
Known problems: Fixed: - DAC 1.8V VDDD - DAC couplings caps are in series with the chip instead of going to GND - Voltage regulator footprint - Encoders footprints and hole size

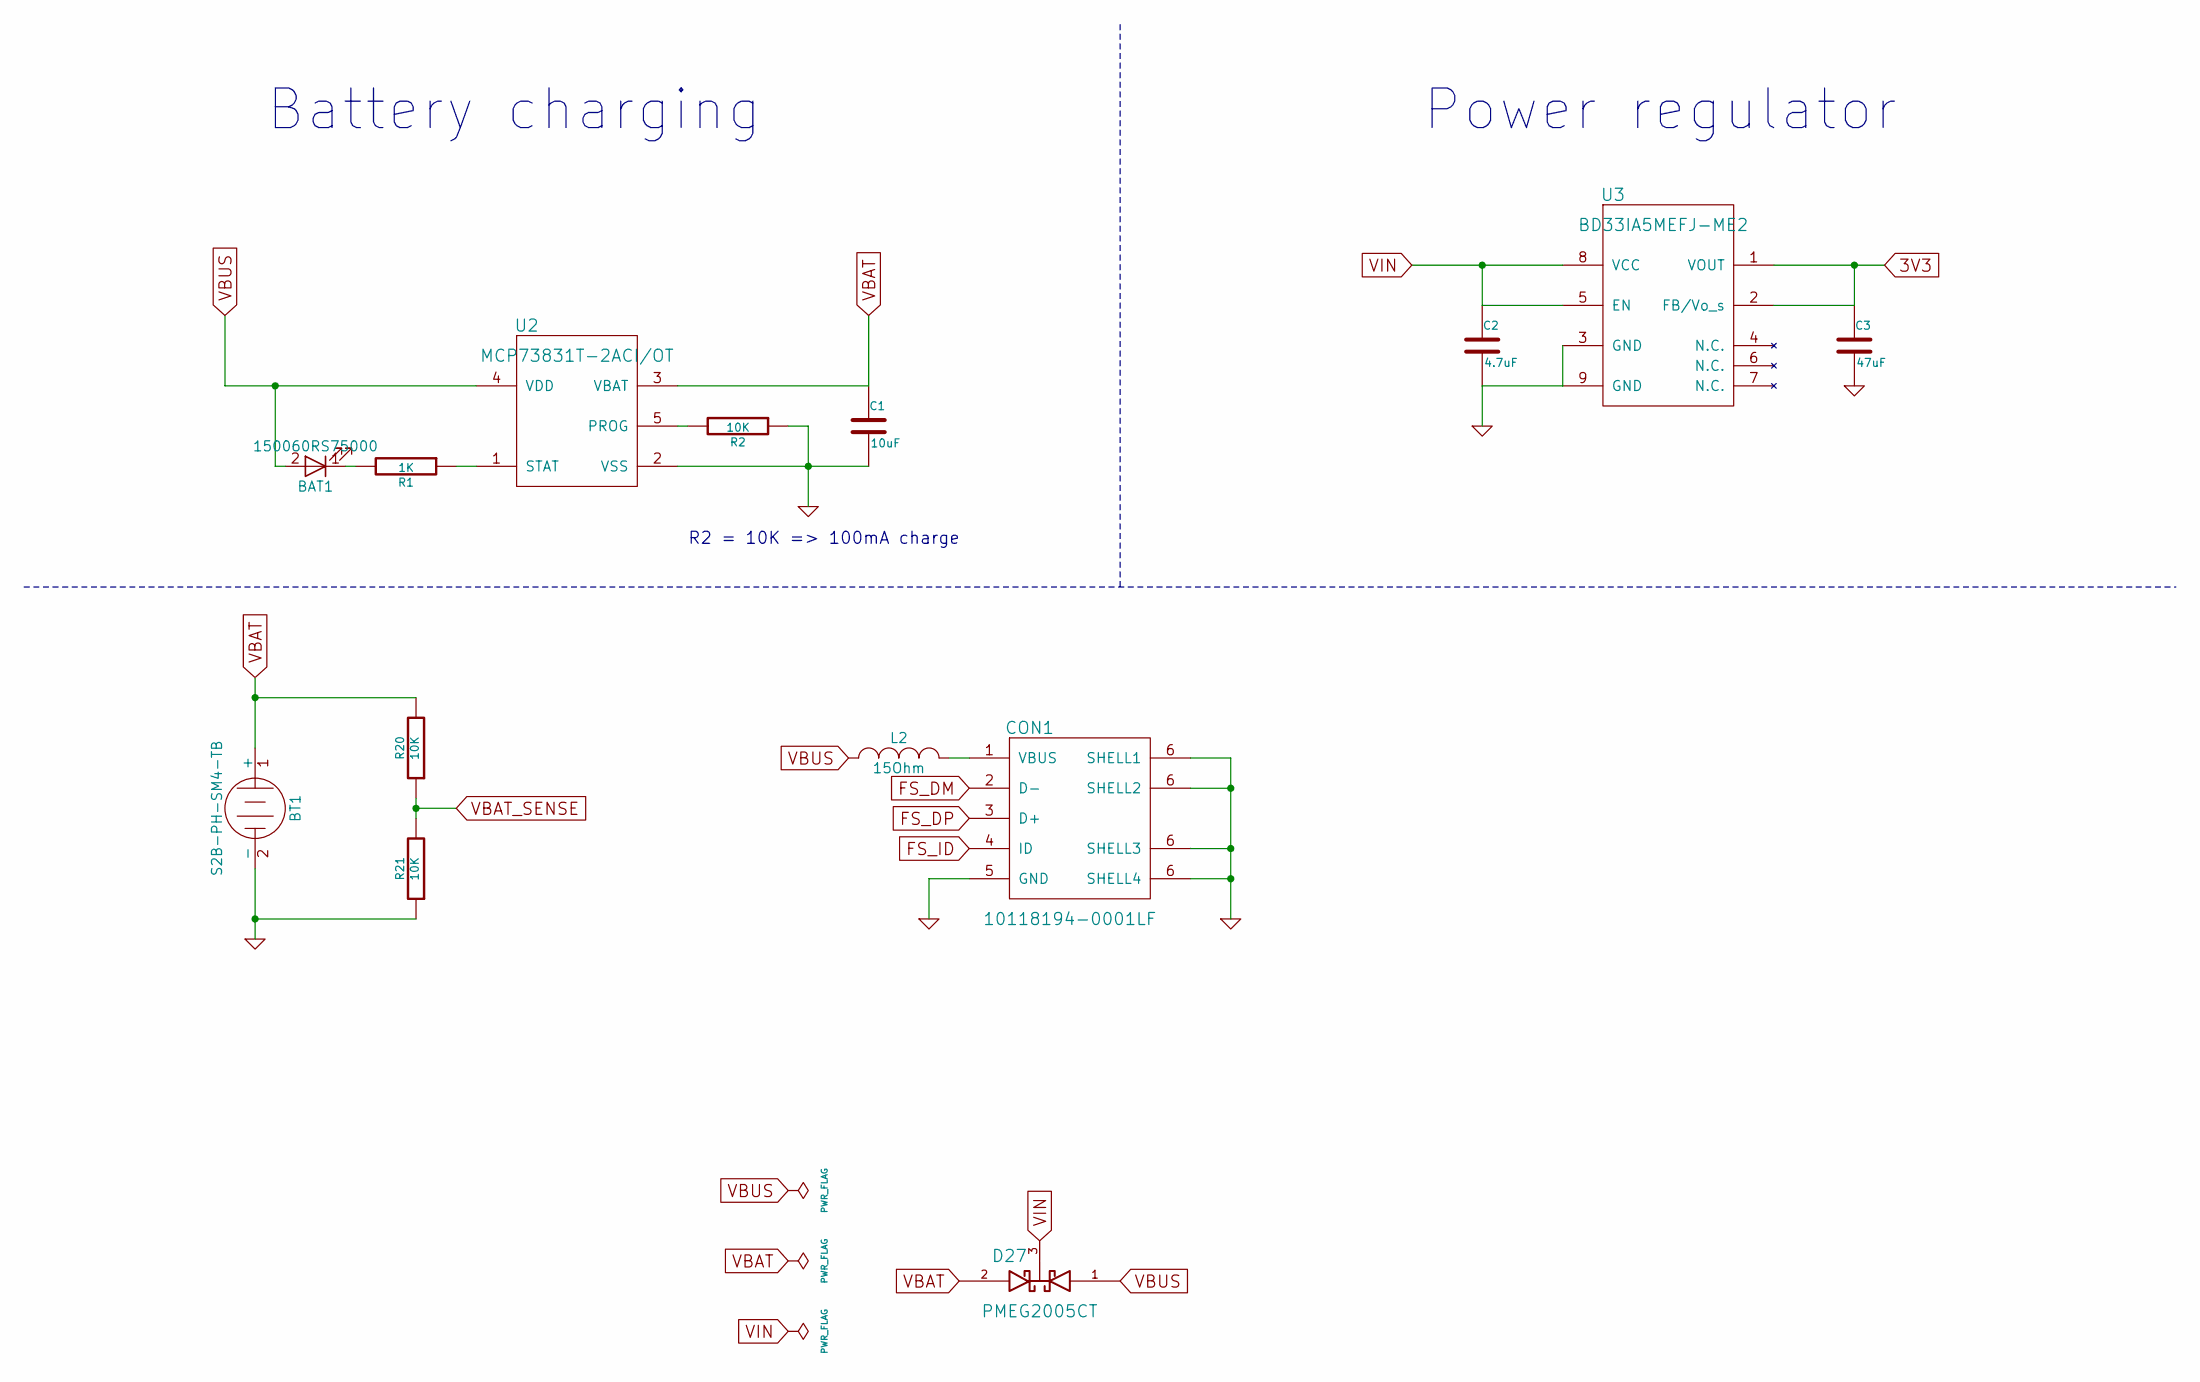
[picture p51: schematic power.sch, Wee Noise Maker - Mk-I]

Parts:
BAT1: 150060RS75000; LED_0805
BT1: S2B-PH-SM4-TB; JST_PH_S2B-PH-SM4-TB_02x2.00mm_Angled
C1: 10uF; C_0805
C2: 4.7uF; C_0805
C3: 47uF; C_1206
CON1: 10118194-0001LF; USB_Micro-B
D27: PMEG2005CT; SOT-23
L2: 15Ohm; C_0805
R1: 1K; R_0805
R2, R20, R21: 10K; R_0805
U2: MCP73831T-2ACI/OT; SOT-23-5
U3: BD33IA5MEFJ-ME2; HTSOP-J8

Connections:
3V3: C3.1, U3.1 (VOUT), U3.2 (FB/Vo_s); also elsewhere on the board
FS_DM: CON1.2 (D-); also elsewhere on the board
FS_DP: CON1.3 (D+); also elsewhere on the board
FS_ID: CON1.4 (ID); also elsewhere on the board
GND: BT1.2 (-), C1.2, C2.2, C3.2, CON1.5 (GND), CON1.6 (SHELL1), R2.1, R21.1, U2.2 (VSS), U3.3 (GND), U3.9 (GND); also elsewhere on the board
unnamed: BAT1.1 (K), R1.2
unnamed: CON1.1 (VBUS), L2.2
unnamed: R1.1, U2.1 (STAT)
unnamed: R2.2, U2.5 (PROG)
VBAT: BT1.1 (+), C1.1, D27.2 (anode), R20.2, U2.3 (VBAT)
VBAT_SENSE: R20.1, R21.2; also elsewhere on the board
VBUS: BAT1.2 (A), D27.1 (Anode), L2.1, U2.4 (VDD); also elsewhere on the board
VIN: C2.1, D27.3 (cathode), U3.5 (EN), U3.8 (VCC)

Notes on the sheet:
Battery charging
Power regulator
R2 = 10K => 100mA charge

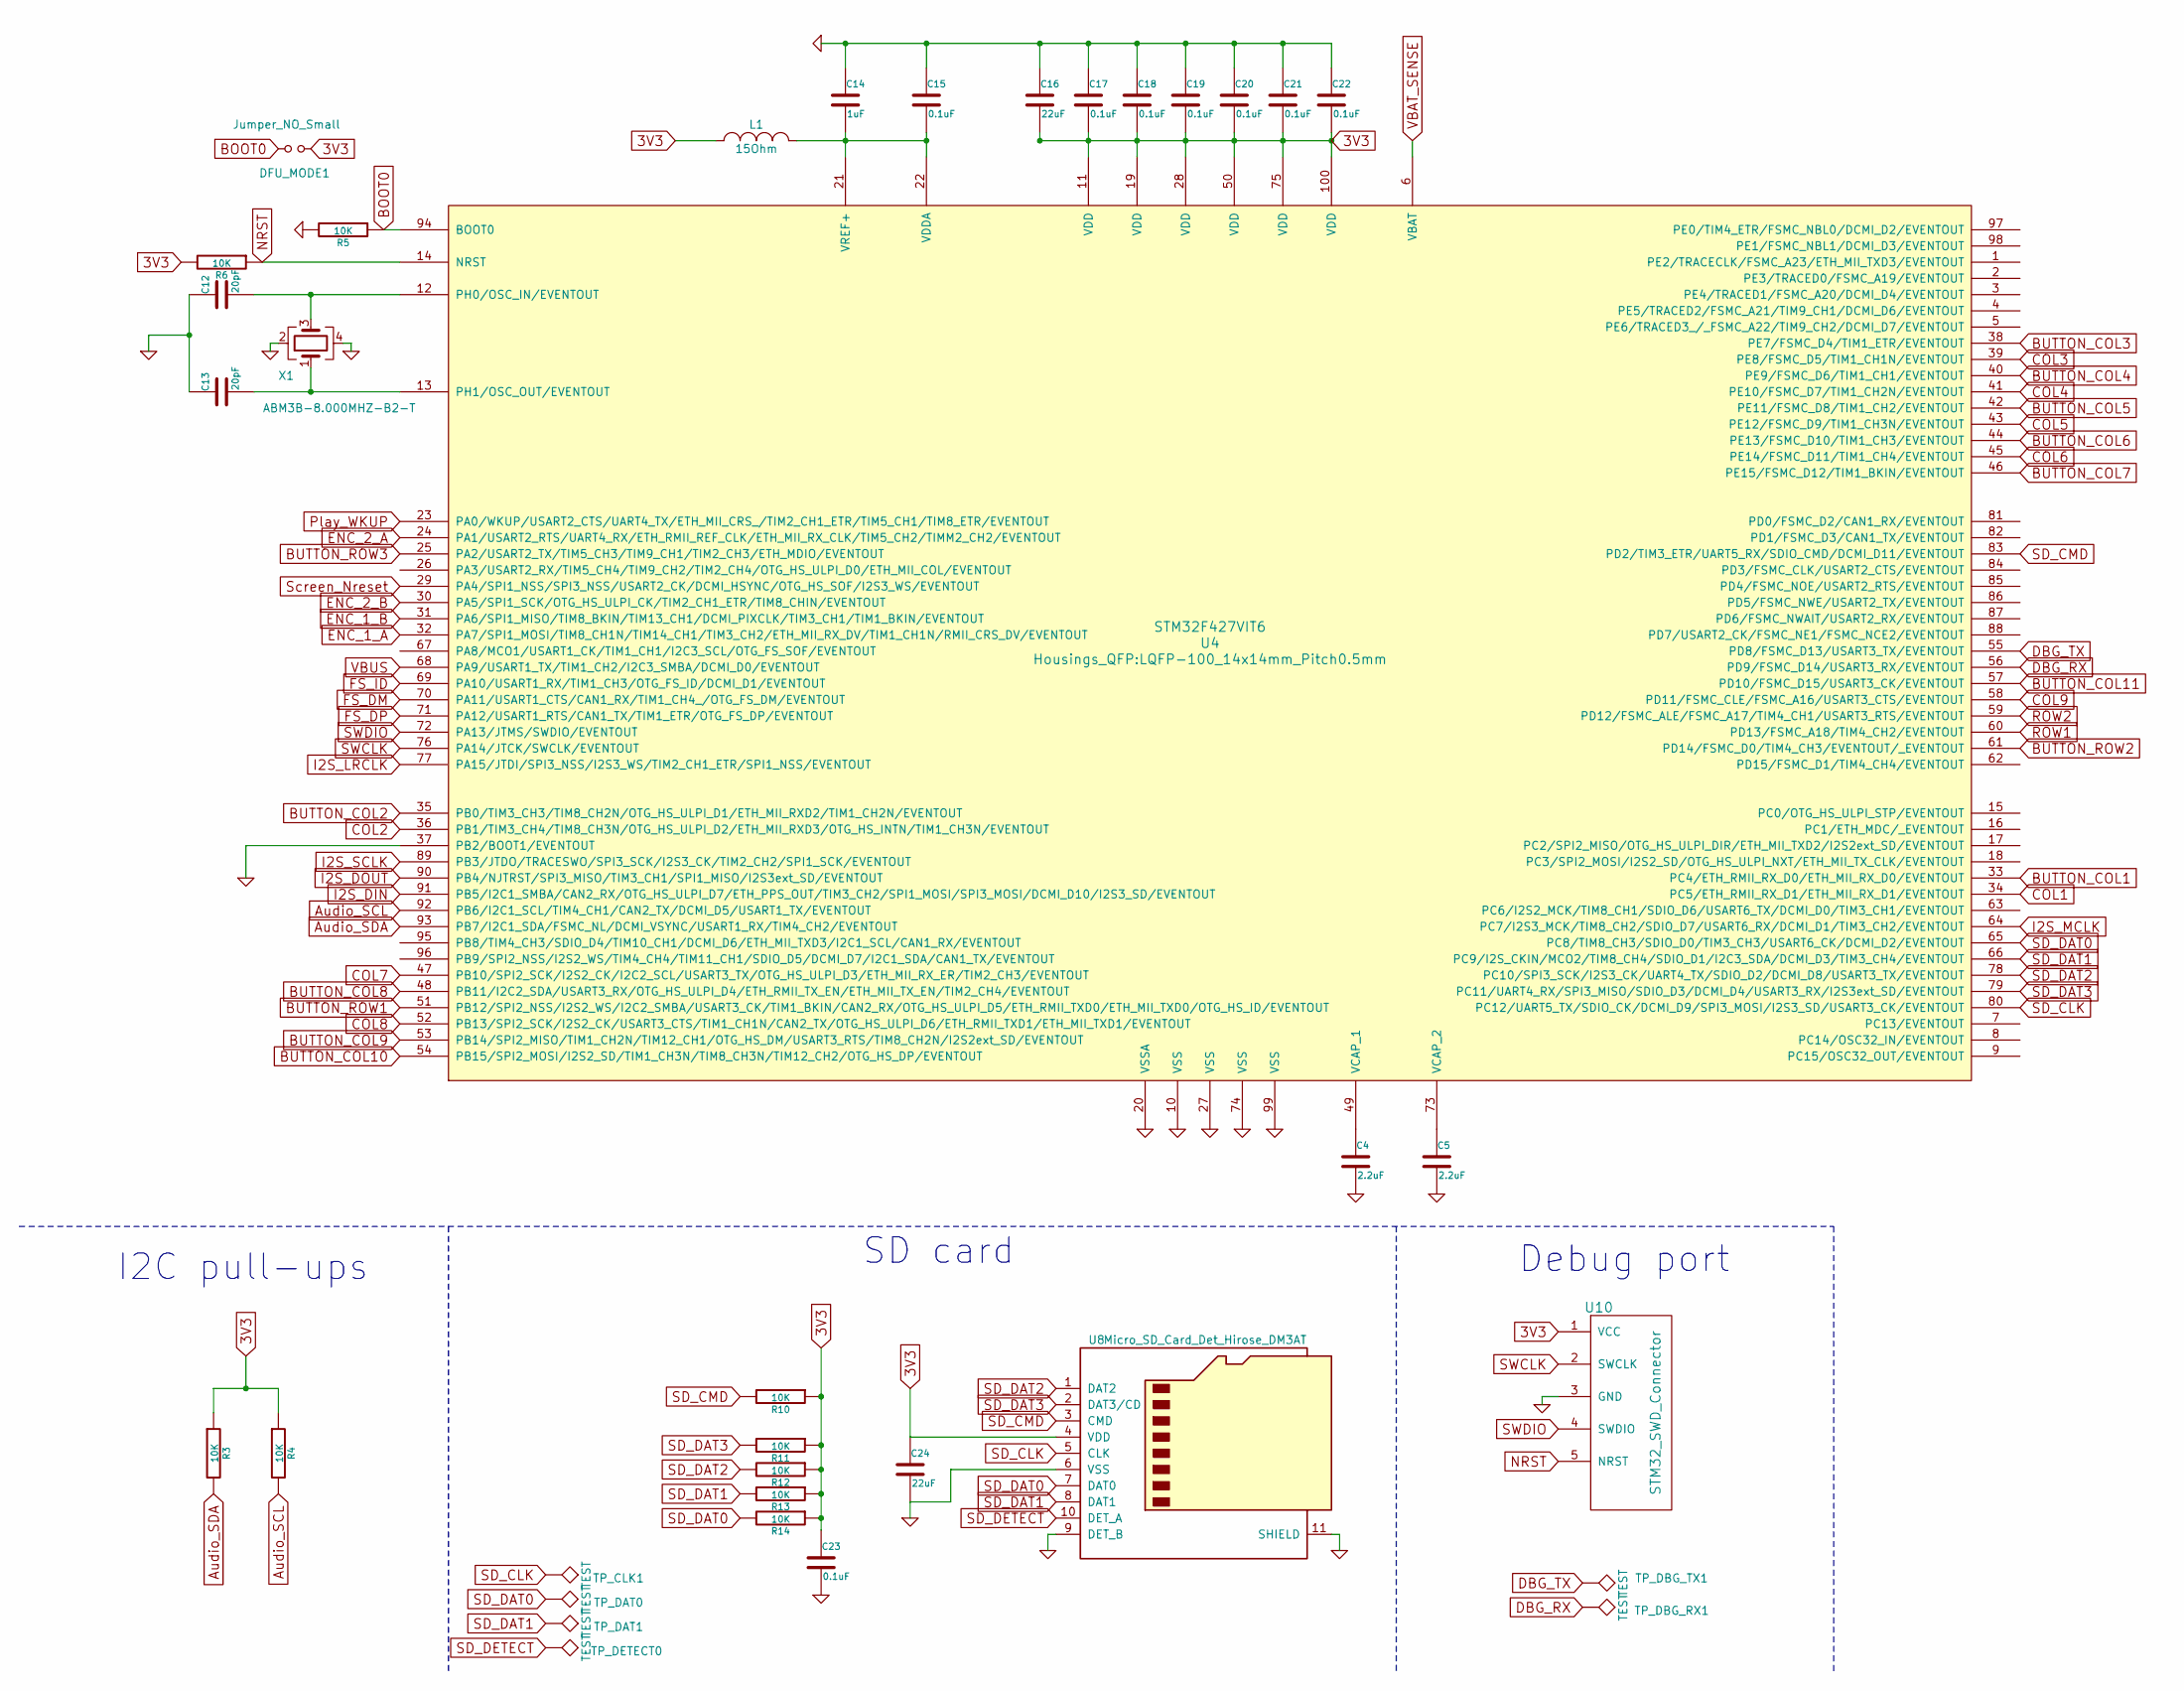
[picture p52: schematic micro-controller.sch, Wee Noise Maker - Mk-I]

Parts:
C4, C5: 2.2uF; C_0805
C12, C13: 20pF; C_0805
C14: 1uF; C_0805
C15, C17, C18, C19, C20, C21, C22, C23: 0.1uF; C_0805
C16, C24: 22uF; C_0805
DFU_MODE1: Jumper_NO_Small; SW_SPST_EVQP7A
L1: 15Ohm; C_0805
R3, R4, R5, R6, R10, R11, R12, R13, R14: 10K; R_0805
TP_CLK1: TEST; Measurement_Point_Round-SMD-Pad_Small
TP_DAT0, TP_DAT1: TEST; Measurement_Point_Round-SMD-Pad_Small
TP_DBG_RX1: TEST; Measurement_Point_Round-SMD-Pad_Small
TP_DBG_TX1: TEST; Measurement_Point_Round-SMD-Pad_Small
TP_DETECT0: TEST; Measurement_Point_Round-SMD-Pad_Small
U4: STM32F427VIT6; LQFP-100_14x14mm_Pitch0.5mm
U8: Micro_SD_Card_Det_Hirose_DM3AT; DM3D
U10: STM32_SWD_Connector; STM32_SWD_Connector_SMD
X1: ABM3B-8.000MHZ-B2-T; Crystal_SMD_0603_4Pads

Connections:
3V3: C16.2, C17.2, C18.2, C19.2, C20.2, C21.2, C22.2, C23.1, C24.1, DFU_MODE1.1, L1.1, R3.1, R4.1, R6.2, R10.1, R11.1, R12.1, R13.1, R14.1, U4.11 (VDD), U4.19 (VDD), U4.28 (VDD), U4.50 (VDD), U4.75 (VDD), U4.100 (VDD), U8.4 (VDD), U10.1 (VCC); also elsewhere on the board
Audio_SCL: R4.2, U4.92 (PB6/I2C1_SCL/TIM4_CH1/CAN2_TX/DCMI_D5/U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); also elsewhere on the board
Audio_SDA: R3.2, U4.93 (PB7/I2C1_SDA/FSMC_NL/DCMI_VSYNC/USART1_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); also elsewhere on the board
BOOT0: DFU_MODE1.2, R5.1, U4.94 (BOOT0)
BUTTON_COL1: U4.33 (PC4/ETH_RMII_RX_D0/ETH_MII_RX_D0/EVENTO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); also elsewhere on the board
BUTTON_COL2: U4.35 (PB0/TIM3_CH3/TIM8_CH2N/OTG_HS_ULPI_D1/E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); also elsewhere on the board
BUTTON_COL3: U4.38 (PE7/FSMC_D4/TIM1_ETR/EVENTOUT); also elsewhere on the board
BUTTON_COL4: U4.40 (PE9/FSMC_D6/TIM1_CH1/EVENTOUT); also elsewhere on the board
BUTTON_COL5: U4.42 (PE11/FSMC_D8/TIM1_CH2/EVENTOUT); also elsewhere on the board
BUTTON_COL6: U4.44 (PE13/FSMC_D10/TIM1_CH3/EVENTOUT); also elsewhere on the board
BUTTON_COL7: U4.46 (PE15/FSMC_D12/TIM1_BKIN/EVENTOUT); also elsewhere on the board
BUTTON_COL8: U4.48 (PB11/I2C2_SDA/USART3_RX/OTG_HS_ULPI_D4/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); also elsewhere on the board
BUTTON_COL9: U4.53 (PB14/SPI2_MISO/TIM1_CH2N/TIM12_CH1/OTG_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); also elsewhere on the board
BUTTON_COL10: U4.54 (PB15/SPI2_MOSI/I2S2_SD/TIM1_CH3N/TIM8_C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); also elsewhere on the board
BUTTON_COL11: U4.57 (PD10/FSMC_D15/USART3_CK/EVENTOUT); also elsewhere on the board
BUTTON_ROW1: U4.51 (PB12/SPI2_NSS/I2S2_WS/I2C2_SMBA/USART3_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); also elsewhere on the board
BUTTON_ROW2: U4.61 (PD14/FSMC_D0/TIM4_CH3/EVENTOUT/_EVENTOUT); also elsewhere on the board
BUTTON_ROW3: U4.25 (PA2/USART2_TX/TIM5_CH3/TIM9_CH1/TIM2_CH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); also elsewhere on the board
COL1: U4.34 (PC5/ETH_RMII_RX_D1/ETH_MII_RX_D1/EVENTO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); also elsewhere on the board
COL2: U4.36 (PB1/TIM3_CH4/TIM8_CH3N/OTG_HS_ULPI_D2/E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); also elsewhere on the board
COL3: U4.39 (PE8/FSMC_D5/TIM1_CH1N/EVENTOUT); also elsewhere on the board
COL4: U4.41 (PE10/FSMC_D7/TIM1_CH2N/EVENTOUT); also elsewhere on the board
COL5: U4.43 (PE12/FSMC_D9/TIM1_CH3N/EVENTOUT); also elsewhere on the board
COL6: U4.45 (PE14/FSMC_D11/TIM1_CH4/EVENTOUT); also elsewhere on the board
COL7: U4.47 (PB10/SPI2_SCK/I2S2_CK/I2C2_SCL/USART3_T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); also elsewhere on the board
COL8: U4.52 (PB13/SPI2_SCK/I2S2_CK/USART3_CTS/TIM1_C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); also elsewhere on the board
COL9: U4.58 (PD11/FSMC_CLE/FSMC_A16/USART3_CTS/EVENT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); also elsewhere on the board
DBG_RX: TP_DBG_RX1.1, U4.56 (PD9/FSMC_D14/USART3_RX/EVENTOUT)
DBG_TX: TP_DBG_TX1.1, U4.55 (PD8/FSMC_D13/USART3_TX/EVENTOUT)
ENC_1_A: U4.32 (PA7/SPI1_MOSI/TIM8_CH1N/TIM14_CH1/TIM3_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); also elsewhere on the board
ENC_1_B: U4.31 (PA6/SPI1_MISO/TIM8_BKIN/TIM13_CH1/DCMI_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); also elsewhere on the board
ENC_2_A: U4.24 (PA1/USART2_RTS/UART4_RX/ETH_RMII_REF_CL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); also elsewhere on the board
ENC_2_B: U4.30 (PA5/SPI1_SCK/OTG_HS_ULPI_CK/TIM2_CH1_ET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); also elsewhere on the board
FS_DM: U4.70 (PA11/USART1_CTS/CAN1_RX/TIM1_CH4_/OTG_F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); also elsewhere on the board
FS_DP: U4.71 (PA12/USART1_RTS/CAN1_TX/TIM1_ETR/OTG_FS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); also elsewhere on the board
FS_ID: U4.69 (PA10/USART1_RX/TIM1_CH3/OTG_FS_ID/DCMI_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); also elsewhere on the board
GND: C4.2, C5.2, C12.1, C13.1, C14.1, C15.1, C16.1, C17.1, C18.1, C19.1, C20.1, C21.1, C22.1, C23.2, C24.2, R5.2, U4.10 (VSS), U4.20 (VSSA), U4.27 (VSS), U4.37 (PB2/BOOT1/EVENTOUT), U4.74 (VSS), U4.99 (VSS), U8.6 (VSS), U8.9 (DET_B), U8.11 (SHIELD), U10.3 (GND), X1.2, X1.4; also elsewhere on the board
I2S_DIN: U4.91 (PB5/I2C1_SMBA/CAN2_RX/OTG_HS_ULPI_D7/ET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); also elsewhere on the board
I2S_DOUT: U4.90 (PB4/NJTRST/SPI3_MISO/TIM3_CH1/SPI1_MISO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); also elsewhere on the board
I2S_LRCLK: U4.77 (PA15/JTDI/SPI3_NSS/I2S3_WS/TIM2_CH1_ETR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); also elsewhere on the board
I2S_MCLK: U4.64 (PC7/I2S3_MCK/TIM8_CH2/SDIO_D7/USART6_RX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); also elsewhere on the board
I2S_SCLK: U4.89 (PB3/JTDO/TRACESWO/SPI3_SCK/I2S3_CK/TIM2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); also elsewhere on the board
NRST: R6.1, U4.14 (NRST), U10.5 (NRST)
unnamed: C4.1, U4.49 (VCAP_1)
unnamed: C5.1, U4.73 (VCAP_2)
unnamed: C12.2, U4.12 (PH0/OSC_IN/EVENTOUT), X1.3
unnamed: C13.2, U4.13 (PH1/OSC_OUT/EVENTOUT), X1.1
unnamed: C14.2, C15.2, L1.2, U4.21 (VREF+), U4.22 (VDDA)
Play_WKUP: U4.23 (PA0/WKUP/USART2_CTS/UART4_TX/ETH_MII_CR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); also elsewhere on the board
ROW1: U4.60 (PD13/FSMC_A18/TIM4_CH2/EVENTOUT); also elsewhere on the board
ROW2: U4.59 (PD12/FSMC_ALE/FSMC_A17/TIM4_CH1/USART3_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); also elsewhere on the board
SD_CLK: TP_CLK1.1, U4.80 (PC12/UART5_TX/SDIO_CK/DCMI_D9/SPI3_MOSI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), U8.5 (CLK)
SD_CMD: R10.2, U4.83 (PD2/TIM3_ETR/UART5_RX/SDIO_CMD/DCMI_D11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), U8.3 (CMD); also elsewhere on the board
SD_DAT0: R14.2, TP_DAT0.1, U4.65 (PC8/TIM8_CH3/SDIO_D0/TIM3_CH3/USART6_CK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), U8.7 (DAT0)
SD_DAT1: R13.2, TP_DAT1.1, U4.66 (PC9/I2S_CKIN/MCO2/TIM8_CH4/SDIO_D1/I2C3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), U8.8 (DAT1)
SD_DAT2: R12.2, U4.78 (PC10/SPI3_SCK/I2S3_CK/UART4_TX/SDIO_D2/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), U8.1 (DAT2); also elsewhere on the board
SD_DAT3: R11.2, U4.79 (PC11/UART4_RX/SPI3_MISO/SDIO_D3/DCMI_D4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), U8.2 (DAT3/CD); also elsewhere on the board
SD_DETECT: TP_DETECT0.1, U8.10 (DET_A)
SWCLK: U4.76 (PA14/JTCK/SWCLK/EVENTOUT), U10.2 (SWCLK)
SWDIO: U4.72 (PA13/JTMS/SWDIO/EVENTOUT), U10.4 (SWDIO)
Screen_Nreset: U4.29 (PA4/SPI1_NSS/SPI3_NSS/USART2_CK/DCMI_HS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); also elsewhere on the board
VBAT_SENSE: U4.6 (VBAT); also elsewhere on the board
VBUS: U4.68 (PA9/USART1_TX/TIM1_CH2/I2C3_SMBA/DCMI_D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); also elsewhere on the board

Notes on the sheet:
I2C pull-ups
SD card
Debug port

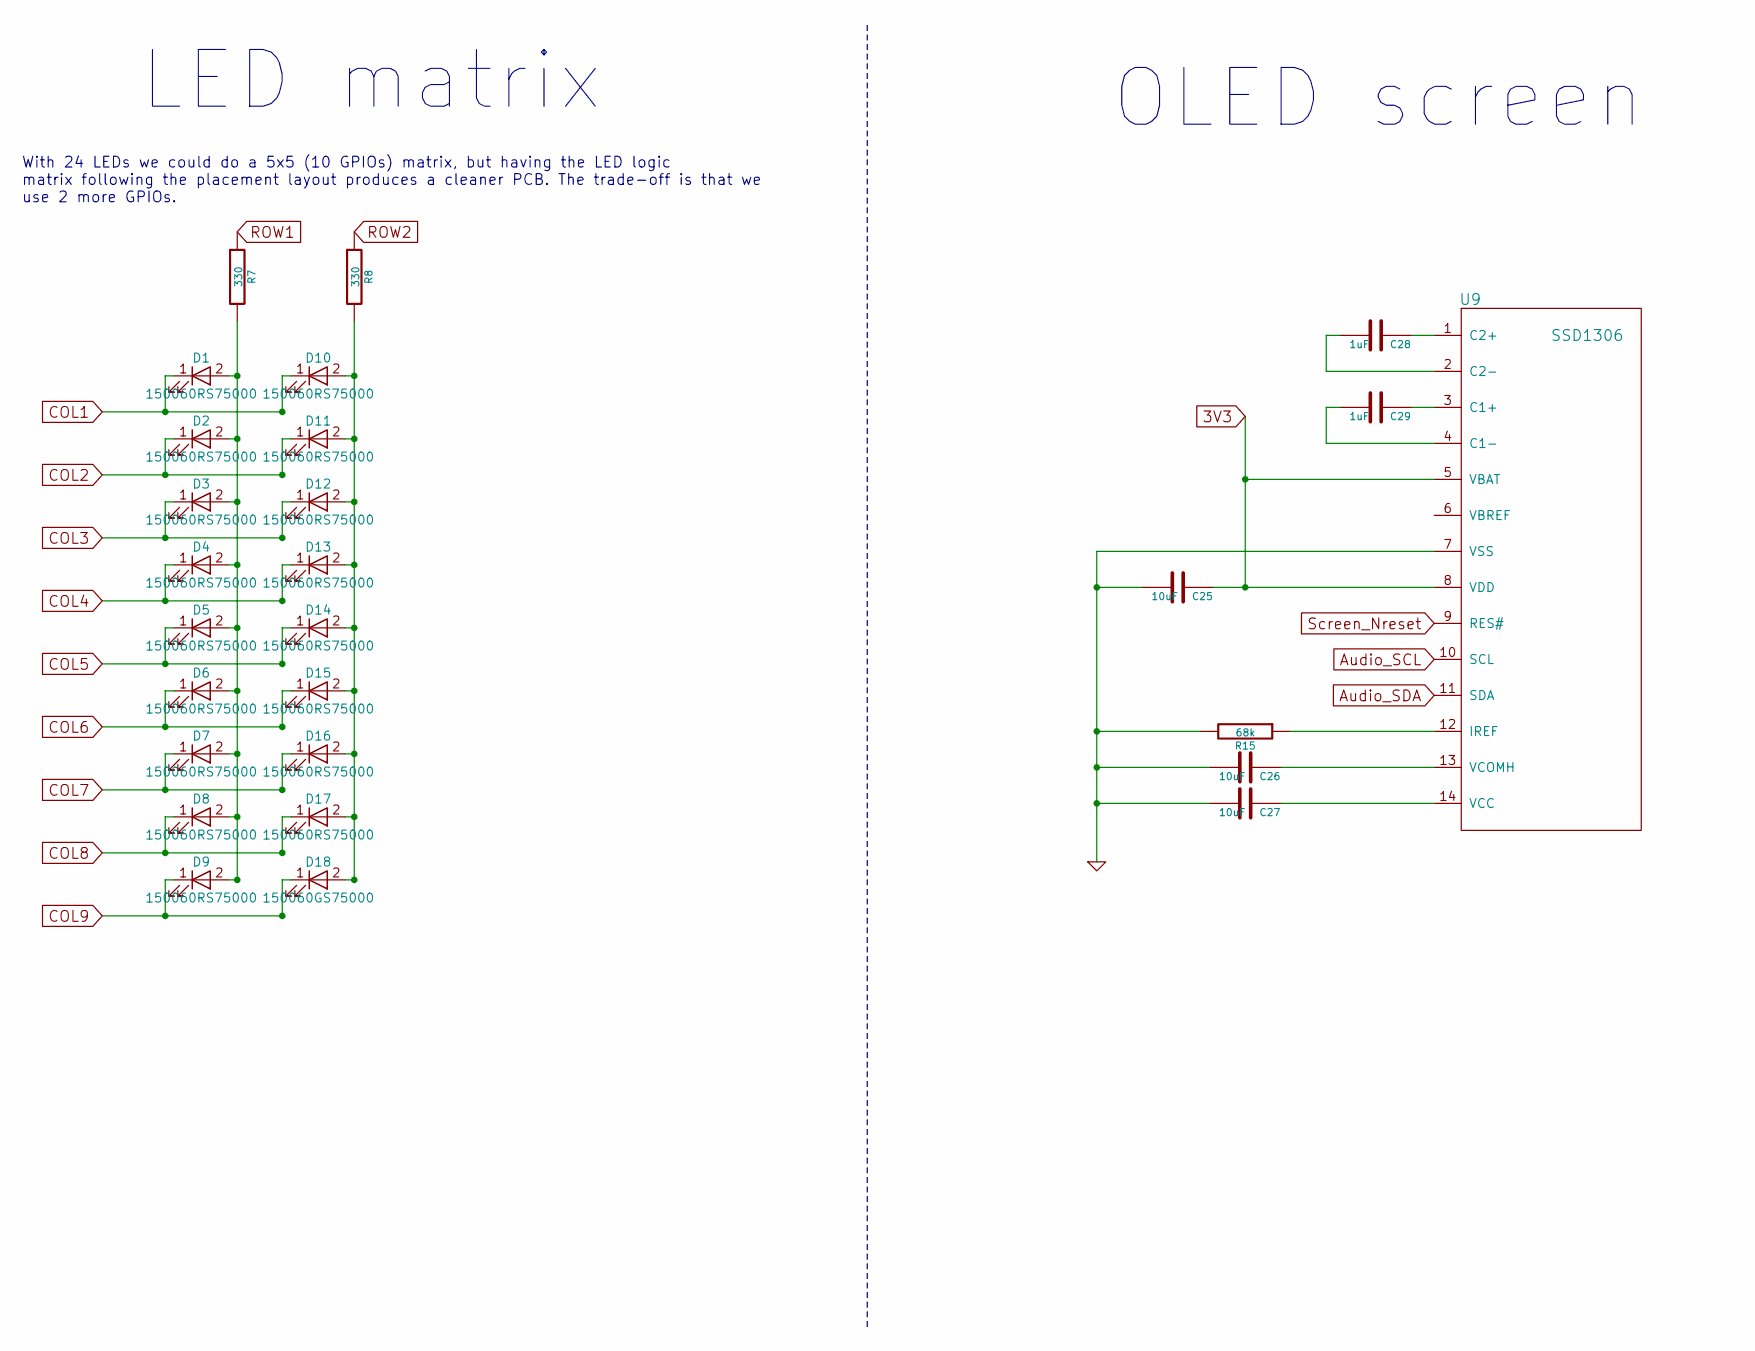
[picture p53: schematic led_matrix.sch, Wee Noise Maker - Mk-I]

Parts:
C25, C26, C27: 10uF; C_0805
C28, C29: 1uF; C_0805
D1, D2, D3, D4, D5, D6, D7, D8, D9, D10, D11, D12, D13, D14, D15, D16, D17: 150060RS75000; LED_0805
D18: 150060GS75000; LED_0805
R7, R8: 330; R_0805
R15: 68k; R_0805
U9: SSD1306; MIDAS_MCOT096016AV_OLED

Connections:
3V3: C25.1, U9.5 (VBAT), U9.8 (VDD); also elsewhere on the board
Audio_SCL: U9.10 (SCL); also elsewhere on the board
Audio_SDA: U9.11 (SDA); also elsewhere on the board
COL1: D1.1 (K), D10.1 (K); also elsewhere on the board
COL2: D2.1 (K), D11.1 (K); also elsewhere on the board
COL3: D3.1 (K), D12.1 (K); also elsewhere on the board
COL4: D4.1 (K), D13.1 (K); also elsewhere on the board
COL5: D5.1 (K), D14.1 (K); also elsewhere on the board
COL6: D6.1 (K), D15.1 (K); also elsewhere on the board
COL7: D7.1 (K), D16.1 (K); also elsewhere on the board
COL8: D8.1 (K), D17.1 (K); also elsewhere on the board
COL9: D9.1 (K), D18.1 (K); also elsewhere on the board
GND: C25.2, C26.2, C27.2, R15.2, U9.7 (VSS); also elsewhere on the board
unnamed: C26.1, U9.13 (VCOMH)
unnamed: C27.1, U9.14 (VCC)
unnamed: C28.1, U9.1 (C2+)
unnamed: C28.2, U9.2 (C2-)
unnamed: C29.1, U9.3 (C1+)
unnamed: C29.2, U9.4 (C1-)
unnamed: D1.2 (A), D2.2 (A), D3.2 (A), D4.2 (A), D5.2 (A), D6.2 (A), D7.2 (A), D8.2 (A), D9.2 (A), R7.2
unnamed: D10.2 (A), D11.2 (A), D12.2 (A), D13.2 (A), D14.2 (A), D15.2 (A), D16.2 (A), D17.2 (A), D18.2 (A), R8.2
unnamed: R15.1, U9.12 (IREF)
ROW1: R7.1; also elsewhere on the board
ROW2: R8.1; also elsewhere on the board
Screen_Nreset: U9.9 (RES#); also elsewhere on the board

Notes on the sheet:
With 24 LEDs we could do a 5x5 (10 GPIOs) matrix, but having the LED logic matrix following the placement layout produces a cleaner PCB. The trade-off is that we use 2 more GPIOs.
LED matrix
OLED screen

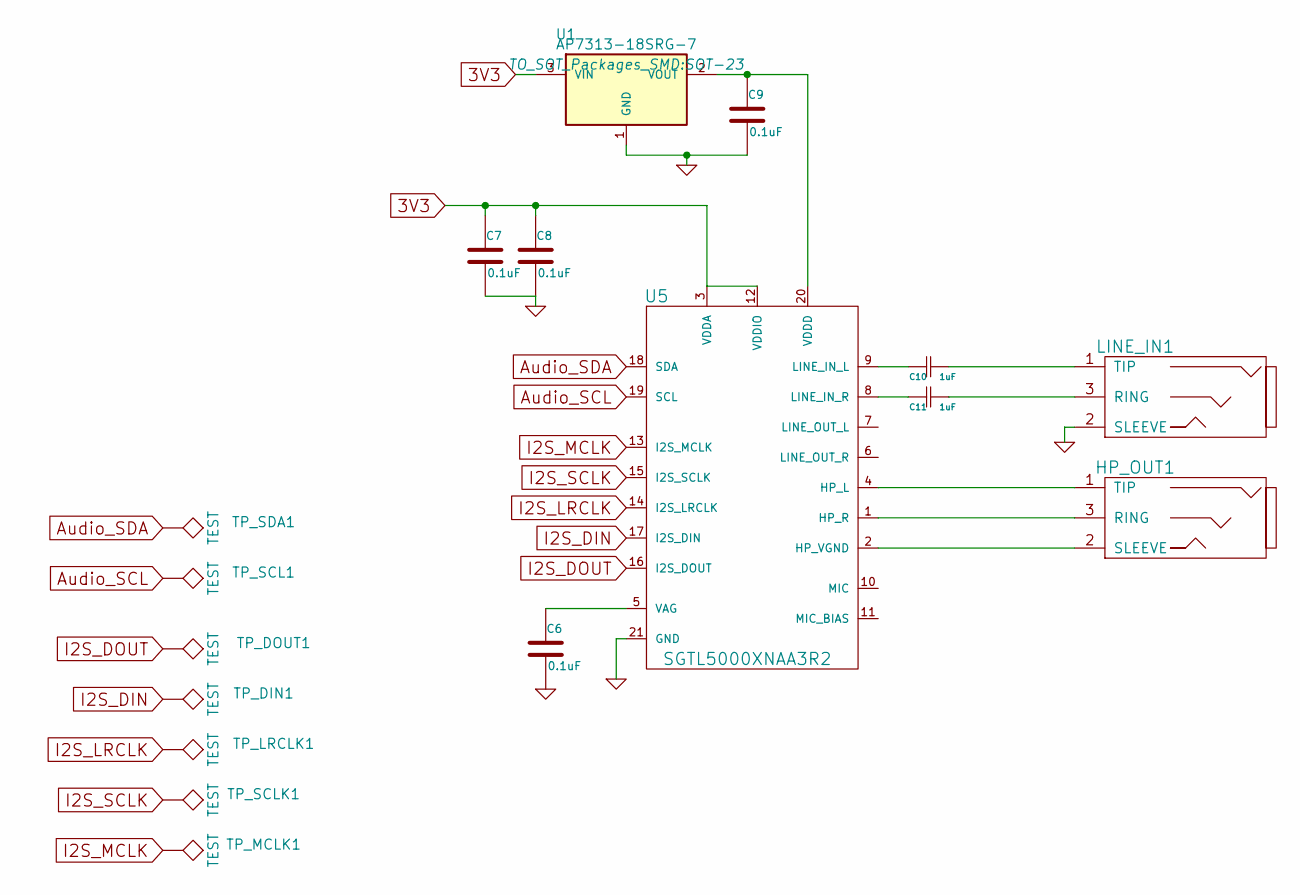
[picture p54: schematic audio.sch, Wee Noise Maker - Mk-I]

Parts:
C6, C7, C8, C9: 0.1uF; C_0805
C10, C11: 1uF; C_0805
HP_OUT1: SJ-3523-SMT
LINE_IN1: SJ-3523-SMT
TP_DIN1: TEST; Measurement_Point_Round-SMD-Pad_Small
TP_DOUT1: TEST; Measurement_Point_Round-SMD-Pad_Small
TP_LRCLK1: TEST; Measurement_Point_Round-SMD-Pad_Small
TP_MCLK1: TEST; Measurement_Point_Round-SMD-Pad_Small
TP_SCL1: TEST; Measurement_Point_Round-SMD-Pad_Small
TP_SCLK1: TEST; Measurement_Point_Round-SMD-Pad_Small
TP_SDA1: TEST; Measurement_Point_Round-SMD-Pad_Small
U1: AP7313-18SRG-7; SOT-23
U5: SGTL5000XNAA3R2; UQFN-20-1EP_3x3mm_Pitch0.4mm

Connections:
3V3: C7.1, C8.1, U1.3 (VIN), U5.3 (VDDA), U5.12 (VDDIO); also elsewhere on the board
Audio_SCL: TP_SCL1.1, U5.19 (SCL); also elsewhere on the board
Audio_SDA: TP_SDA1.1, U5.18 (SDA); also elsewhere on the board
GND: C6.2, C7.2, C8.2, C9.2, LINE_IN1.2 (SLEEVE), U1.1 (GND), U5.21 (GND); also elsewhere on the board
I2S_DIN: TP_DIN1.1, U5.17 (I2S_DIN); also elsewhere on the board
I2S_DOUT: TP_DOUT1.1, U5.16 (I2S_DOUT); also elsewhere on the board
I2S_LRCLK: TP_LRCLK1.1, U5.14 (I2S_LRCLK); also elsewhere on the board
I2S_MCLK: TP_MCLK1.1, U5.13 (I2S_MCLK); also elsewhere on the board
I2S_SCLK: TP_SCLK1.1, U5.15 (I2S_SCLK); also elsewhere on the board
unnamed: C6.1, U5.5 (VAG)
unnamed: C9.1, U1.2 (VOUT), U5.20 (VDDD)
unnamed: C10.1, LINE_IN1.1 (TIP)
unnamed: C10.2, U5.9 (LINE_IN_L)
unnamed: C11.1, LINE_IN1.3 (RING)
unnamed: C11.2, U5.8 (LINE_IN_R)
unnamed: HP_OUT1.1 (TIP), U5.4 (HP_L)
unnamed: HP_OUT1.2 (SLEEVE), U5.2 (HP_VGND)
unnamed: HP_OUT1.3 (RING), U5.1 (HP_R)

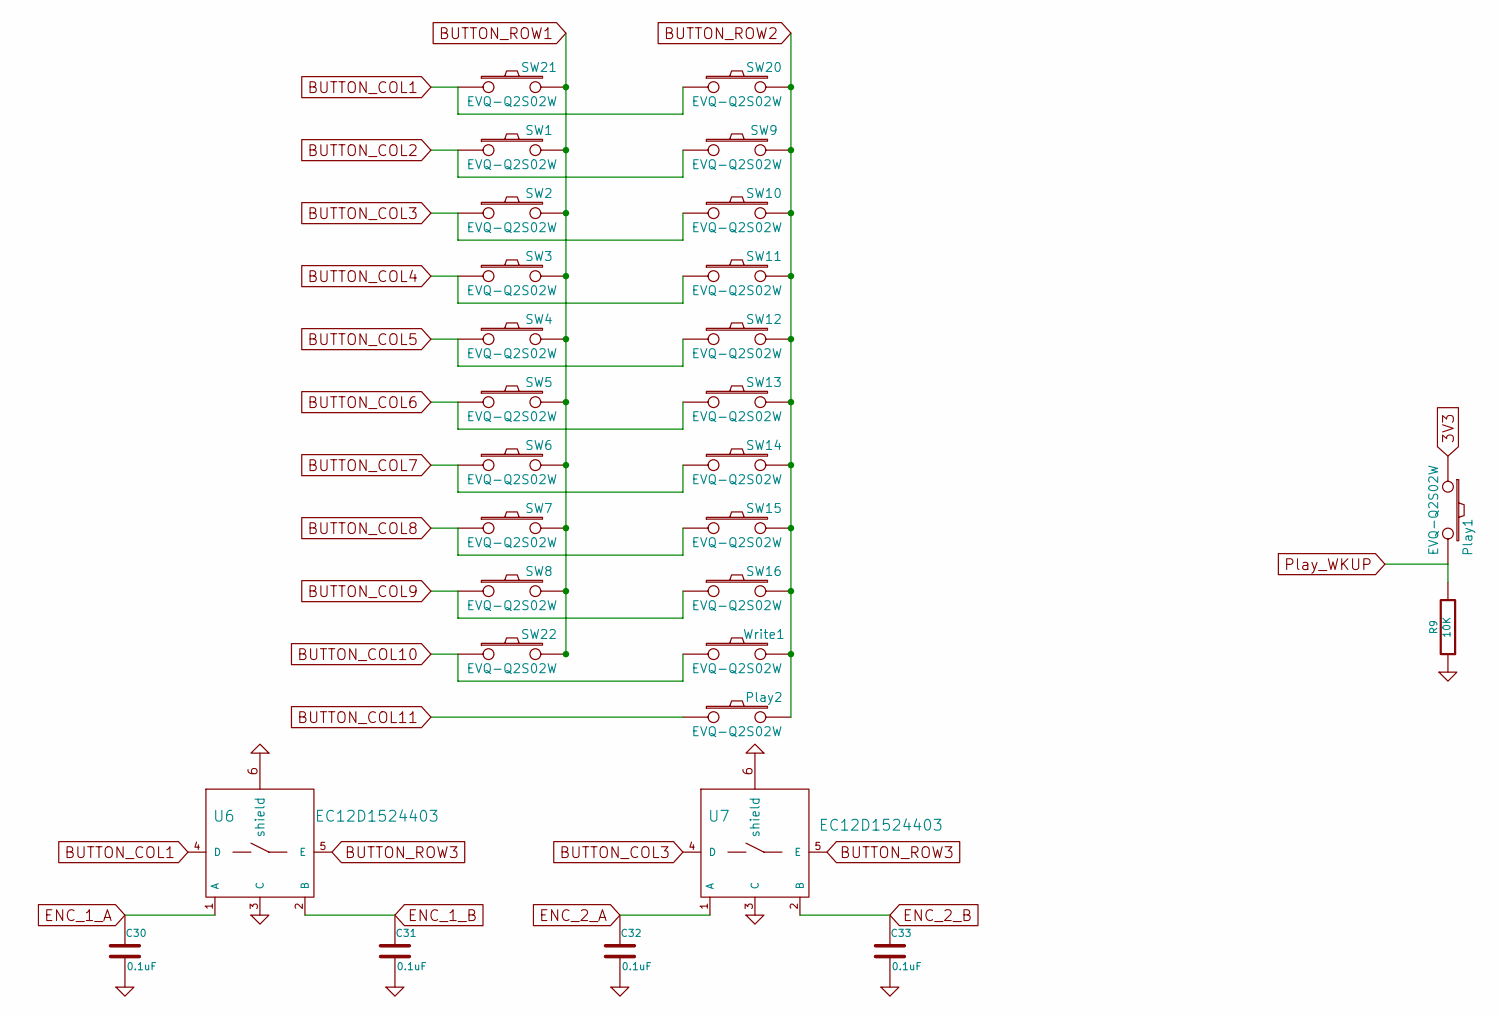
[picture p55: schematic button_matrix.sch]

Parts:
C30, C31, C32, C33: 0.1uF; C_0805
Play1, Play2: EVQ-Q2S02W; SW_SPST_B3SL-1002P
R9: 10K; R_0805
SW1, SW2, SW3, SW4, SW5, SW6, SW7, SW8, SW9, SW10, SW11, SW12, SW13, SW14, SW15, SW16, SW20, SW21, SW22: EVQ-Q2S02W; SW_SPST_B3SL-1002P
U6, U7: EC12D1524403; encoder_EC12D
Write1: EVQ-Q2S02W; SW_SPST_B3SL-1002P

Connections:
3V3: Play1.1; also elsewhere on the board
BUTTON_COL1: SW20.1, SW21.1, U6.4 (D); also elsewhere on the board
BUTTON_COL2: SW1.1, SW9.1; also elsewhere on the board
BUTTON_COL3: SW2.1, SW10.1, U7.4 (D); also elsewhere on the board
BUTTON_COL4: SW3.1, SW11.1; also elsewhere on the board
BUTTON_COL5: SW4.1, SW12.1; also elsewhere on the board
BUTTON_COL6: SW5.1, SW13.1; also elsewhere on the board
BUTTON_COL7: SW6.1, SW14.1; also elsewhere on the board
BUTTON_COL8: SW7.1, SW15.1; also elsewhere on the board
BUTTON_COL9: SW8.1, SW16.1; also elsewhere on the board
BUTTON_COL10: SW22.1, Write1.1; also elsewhere on the board
BUTTON_COL11: Play2.1; also elsewhere on the board
BUTTON_ROW1: SW1.2, SW2.2, SW3.2, SW4.2, SW5.2, SW6.2, SW7.2, SW8.2, SW21.2, SW22.2; also elsewhere on the board
BUTTON_ROW2: Play2.2, SW9.2, SW10.2, SW11.2, SW12.2, SW13.2, SW14.2, SW15.2, SW16.2, SW20.2, Write1.2; also elsewhere on the board
BUTTON_ROW3: U6.5 (E), U7.5 (E); also elsewhere on the board
ENC_1_A: C30.1, U6.1 (A); also elsewhere on the board
ENC_1_B: C31.1, U6.2 (B); also elsewhere on the board
ENC_2_A: C32.1, U7.1 (A); also elsewhere on the board
ENC_2_B: C33.1, U7.2 (B); also elsewhere on the board
GND: C30.2, C31.2, C32.2, C33.2, R9.1, U6.3 (C), U6.6 (shield), U7.3 (C), U7.6 (shield); also elsewhere on the board
Play_WKUP: Play1.2, R9.2; also elsewhere on the board

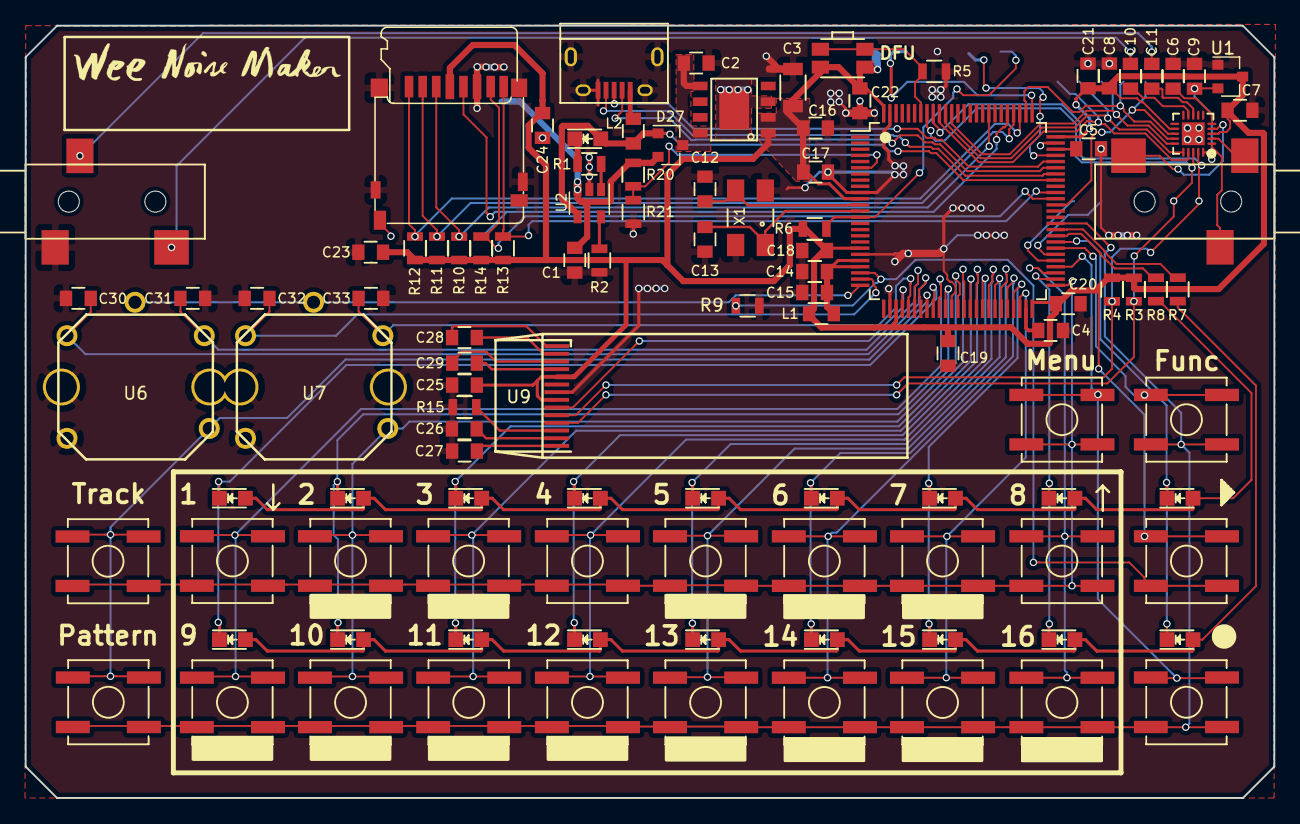
[picture p56: board wnm_mk_1.kicad_pcb from above]

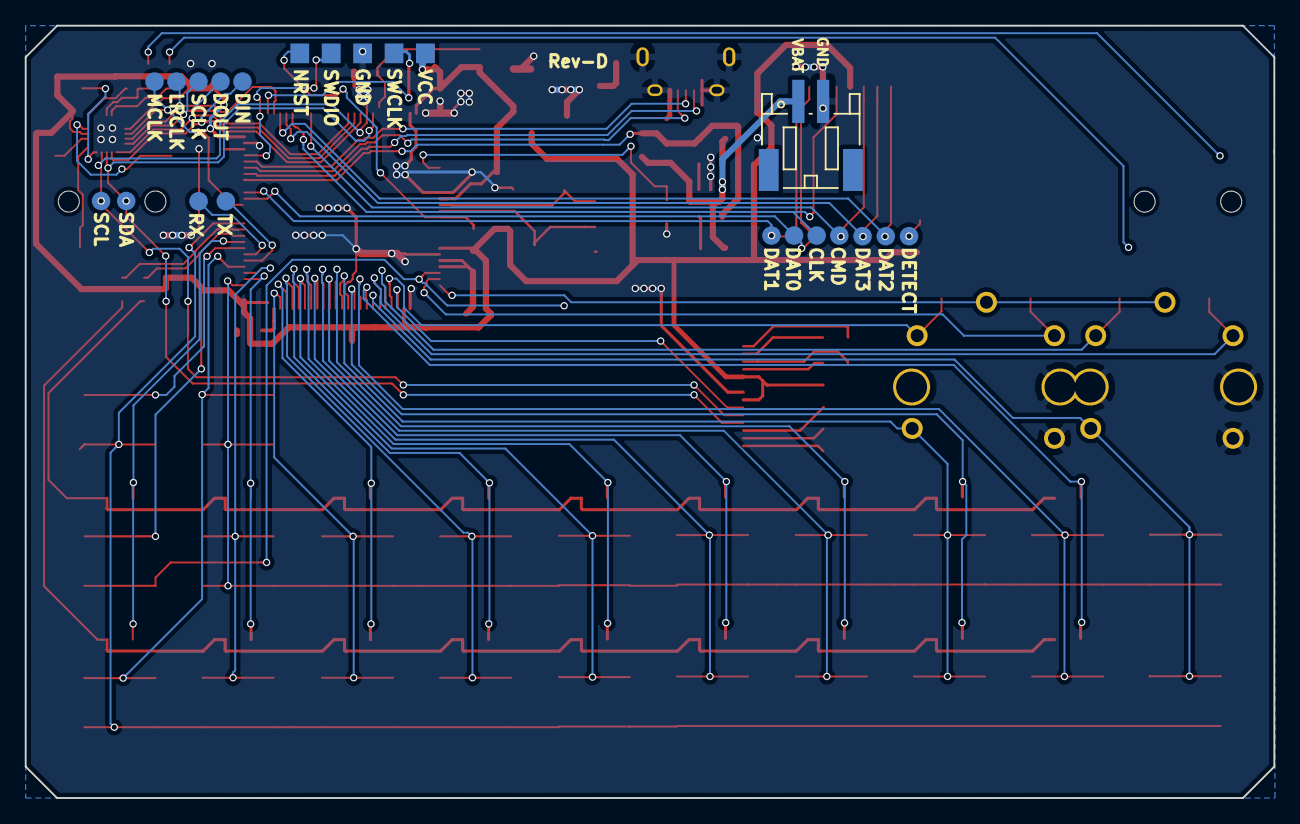
[picture p57: board wnm_mk_1.kicad_pcb from below]

Board: 2 copper layers, 100.9 x 62.4 mm, 126 parts (18 on the bottom side), 87 nets.

Other parts of the board:
TP_CMD1: TEST; Measurement_Point_Round-SMD-Pad_Small
TP_DAT2, TP_DAT3: TEST; Measurement_Point_Round-SMD-Pad_Small

Their connections:
SD_CMD: TP_CMD1.1; also elsewhere on the board
SD_DAT2: TP_DAT2.1; also elsewhere on the board
SD_DAT3: TP_DAT3.1; also elsewhere on the board
