Fabien-Chouteau/Wee-Noise-Maker/hardware/discovery/wnm_discovery.kicad_pcb

## KiCad design hardware/discovery/wnm_discovery.kicad_pcb (2017-01-15)

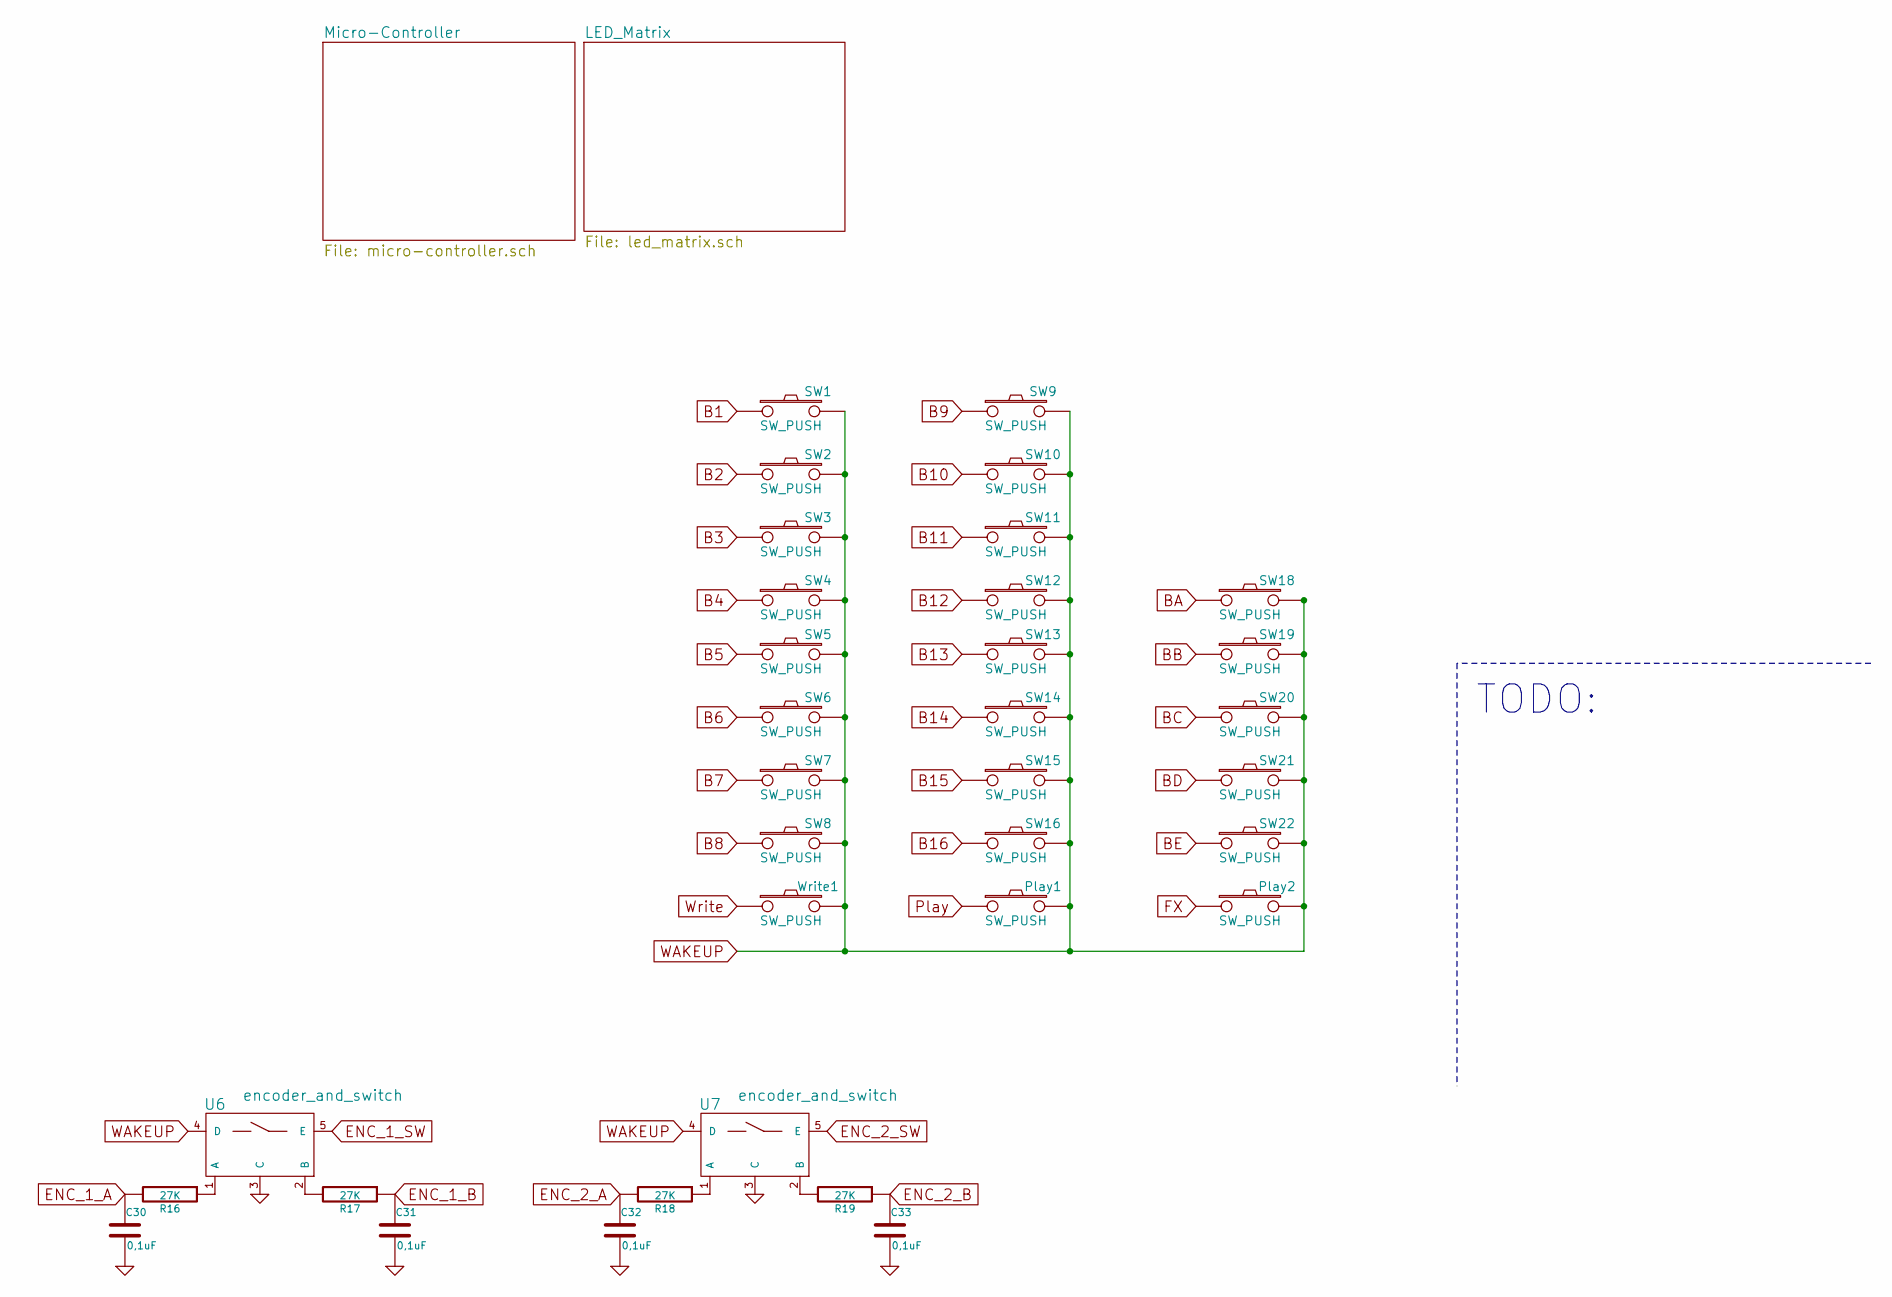
[picture p58: schematic wnm_discovery.sch, Wee Noise Maker - Discovery]

Parts:
C30, C31, C32, C33: 0,1uF; C_0805
Play1, Play2: SW_PUSH; SW_SPST_B3SL-1002P
R16, R17, R18, R19: 27K; R_0805
SW1, SW2, SW3, SW4, SW5, SW6, SW7, SW8, SW9, SW10, SW11, SW12, SW13, SW14, SW15, SW16, SW18, SW19, SW20, SW21, SW22: SW_PUSH; SW_SPST_B3SL-1002P
U6, U7: encoder_and_switch; encoder_EC12D
Write1: SW_PUSH; SW_SPST_B3SL-1002P

Connections:
B1: SW1.1; also elsewhere on the board
B2: SW2.1; also elsewhere on the board
B3: SW3.1; also elsewhere on the board
B4: SW4.1; also elsewhere on the board
B5: SW5.1; also elsewhere on the board
B6: SW6.1; also elsewhere on the board
B7: SW7.1; also elsewhere on the board
B8: SW8.1; also elsewhere on the board
B9: SW9.1; also elsewhere on the board
B10: SW10.1; also elsewhere on the board
B11: SW11.1; also elsewhere on the board
B12: SW12.1; also elsewhere on the board
B13: SW13.1; also elsewhere on the board
B14: SW14.1; also elsewhere on the board
B15: SW15.1; also elsewhere on the board
B16: SW16.1; also elsewhere on the board
BA: SW18.1; also elsewhere on the board
BB: SW19.1; also elsewhere on the board
BC: SW20.1; also elsewhere on the board
BD: SW21.1; also elsewhere on the board
BE: SW22.1; also elsewhere on the board
ENC_1_A: C30.1, R16.2; also elsewhere on the board
ENC_1_B: C31.1, R17.1; also elsewhere on the board
ENC_1_SW: U6.5 (E); also elsewhere on the board
ENC_2_A: C32.1, R18.2; also elsewhere on the board
ENC_2_B: C33.1, R19.1; also elsewhere on the board
ENC_2_SW: U7.5 (E); also elsewhere on the board
FX: Play2.1; also elsewhere on the board
GND: C30.2, C31.2, C32.2, C33.2, U6.3 (C), U7.3 (C); also elsewhere on the board
unnamed: R16.1, U6.1 (A)
unnamed: R17.2, U6.2 (B)
unnamed: R18.1, U7.1 (A)
unnamed: R19.2, U7.2 (B)
Play: Play1.1; also elsewhere on the board
WAKEUP: Play1.2, Play2.2, SW1.2, SW2.2, SW3.2, SW4.2, SW5.2, SW6.2, SW7.2, SW8.2, SW9.2, SW10.2, SW11.2, SW12.2, SW13.2, SW14.2, SW15.2, SW16.2, SW18.2, SW19.2, SW20.2, SW21.2, SW22.2, U6.4 (D), U7.4 (D), Write1.2; also elsewhere on the board
Write: Write1.1; also elsewhere on the board

Notes on the sheet:
TODO:

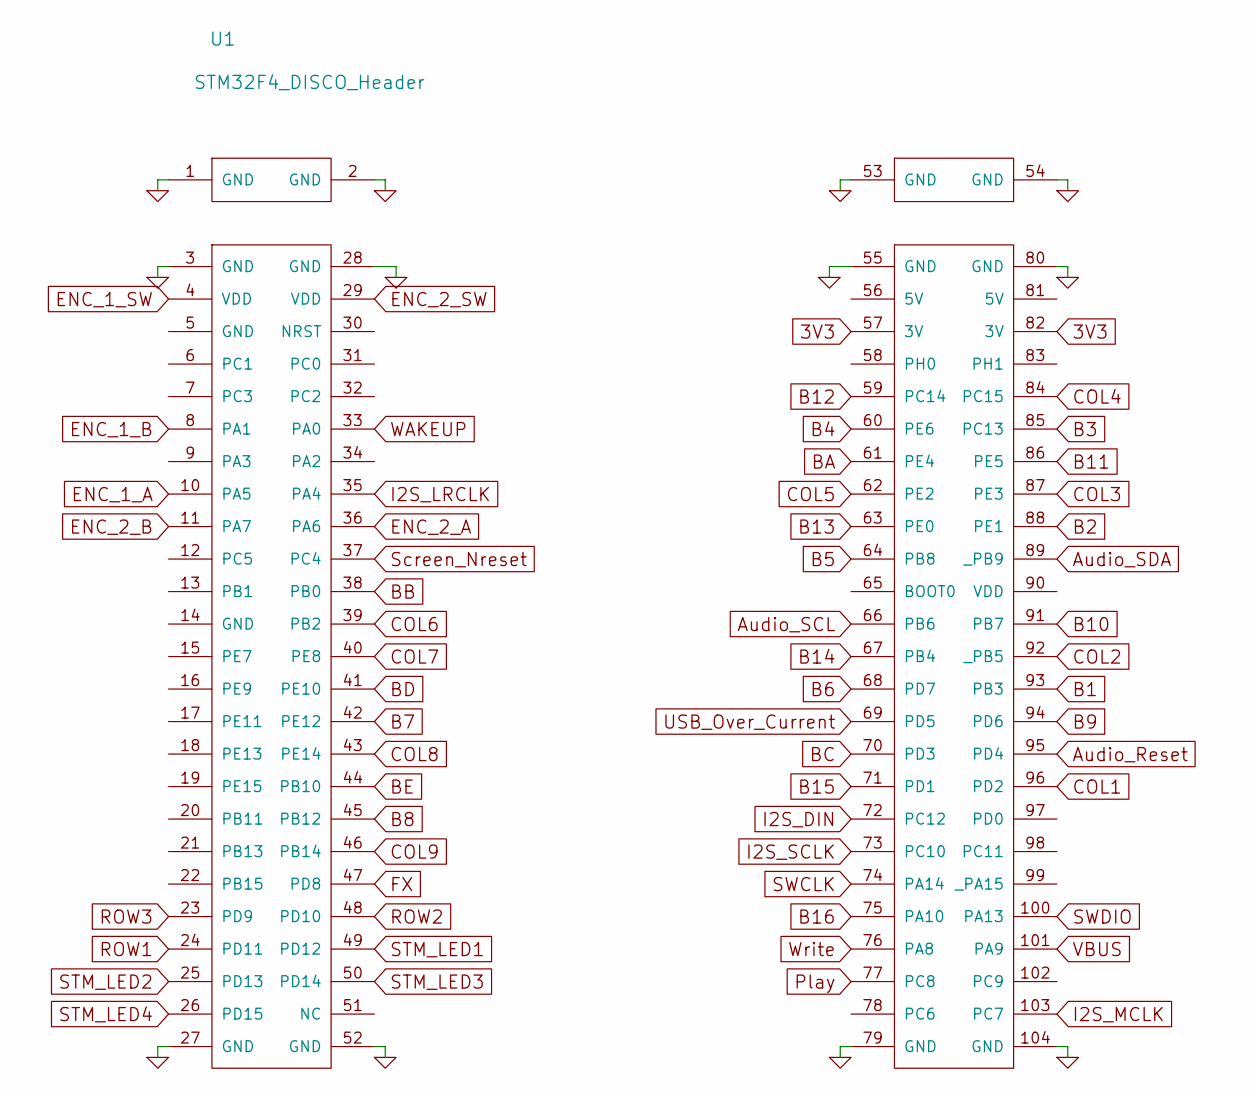
[picture p59: schematic micro-controller.sch, Wee Noise Maker - Discovery]

Parts:
U1: STM32F4_DISCO_Header; STM32F4-DISCO-HEADERS-TH

Connections:
3V3: U1.57 (3V), U1.82 (3V); also elsewhere on the board
Audio_Reset: U1.95 (PD4)
Audio_SCL: U1.66 (PB6); also elsewhere on the board
Audio_SDA: U1.89 (_PB9); also elsewhere on the board
B1: U1.93 (PB3); also elsewhere on the board
B2: U1.88 (PE1); also elsewhere on the board
B3: U1.85 (PC13); also elsewhere on the board
B4: U1.60 (PE6); also elsewhere on the board
B5: U1.64 (PB8); also elsewhere on the board
B6: U1.68 (PD7); also elsewhere on the board
B7: U1.42 (PE12); also elsewhere on the board
B8: U1.45 (PB12); also elsewhere on the board
B9: U1.94 (PD6); also elsewhere on the board
B10: U1.91 (PB7); also elsewhere on the board
B11: U1.86 (PE5); also elsewhere on the board
B12: U1.59 (PC14); also elsewhere on the board
B13: U1.63 (PE0); also elsewhere on the board
B14: U1.67 (PB4); also elsewhere on the board
B15: U1.71 (PD1); also elsewhere on the board
B16: U1.75 (PA10); also elsewhere on the board
BA: U1.61 (PE4); also elsewhere on the board
BB: U1.38 (PB0); also elsewhere on the board
BC: U1.70 (PD3); also elsewhere on the board
BD: U1.41 (PE10); also elsewhere on the board
BE: U1.44 (PB10); also elsewhere on the board
COL1: U1.96 (PD2); also elsewhere on the board
COL2: U1.92 (_PB5); also elsewhere on the board
COL3: U1.87 (PE3); also elsewhere on the board
COL4: U1.84 (PC15); also elsewhere on the board
COL5: U1.62 (PE2); also elsewhere on the board
COL6: U1.39 (PB2); also elsewhere on the board
COL7: U1.40 (PE8); also elsewhere on the board
COL8: U1.43 (PE14); also elsewhere on the board
COL9: U1.46 (PB14); also elsewhere on the board
ENC_1_A: U1.10 (PA5); also elsewhere on the board
ENC_1_B: U1.8 (PA1); also elsewhere on the board
ENC_1_SW: U1.4 (VDD); also elsewhere on the board
ENC_2_A: U1.36 (PA6); also elsewhere on the board
ENC_2_B: U1.11 (PA7); also elsewhere on the board
ENC_2_SW: U1.29 (VDD); also elsewhere on the board
FX: U1.47 (PD8); also elsewhere on the board
GND: U1.1 (GND), U1.2 (GND), U1.3 (GND), U1.27 (GND), U1.28 (GND), U1.52 (GND), U1.53 (GND), U1.54 (GND), U1.55 (GND), U1.79 (GND), U1.80 (GND), U1.104 (GND); also elsewhere on the board
I2S_DIN: U1.72 (PC12)
I2S_LRCLK: U1.35 (PA4)
I2S_MCLK: U1.103 (PC7)
I2S_SCLK: U1.73 (PC10)
Play: U1.77 (PC8); also elsewhere on the board
ROW1: U1.24 (PD11); also elsewhere on the board
ROW2: U1.48 (PD10); also elsewhere on the board
ROW3: U1.23 (PD9); also elsewhere on the board
STM_LED1: U1.49 (PD12)
STM_LED2: U1.25 (PD13)
STM_LED3: U1.50 (PD14)
STM_LED4: U1.26 (PD15)
SWCLK: U1.74 (PA14)
SWDIO: U1.100 (PA13)
Screen_NReset: U1.37 (PC4); also elsewhere on the board
USB_Over_Current: U1.69 (PD5)
VBUS: U1.101 (PA9)
WAKEUP: U1.33 (PA0); also elsewhere on the board
Write: U1.76 (PA8); also elsewhere on the board

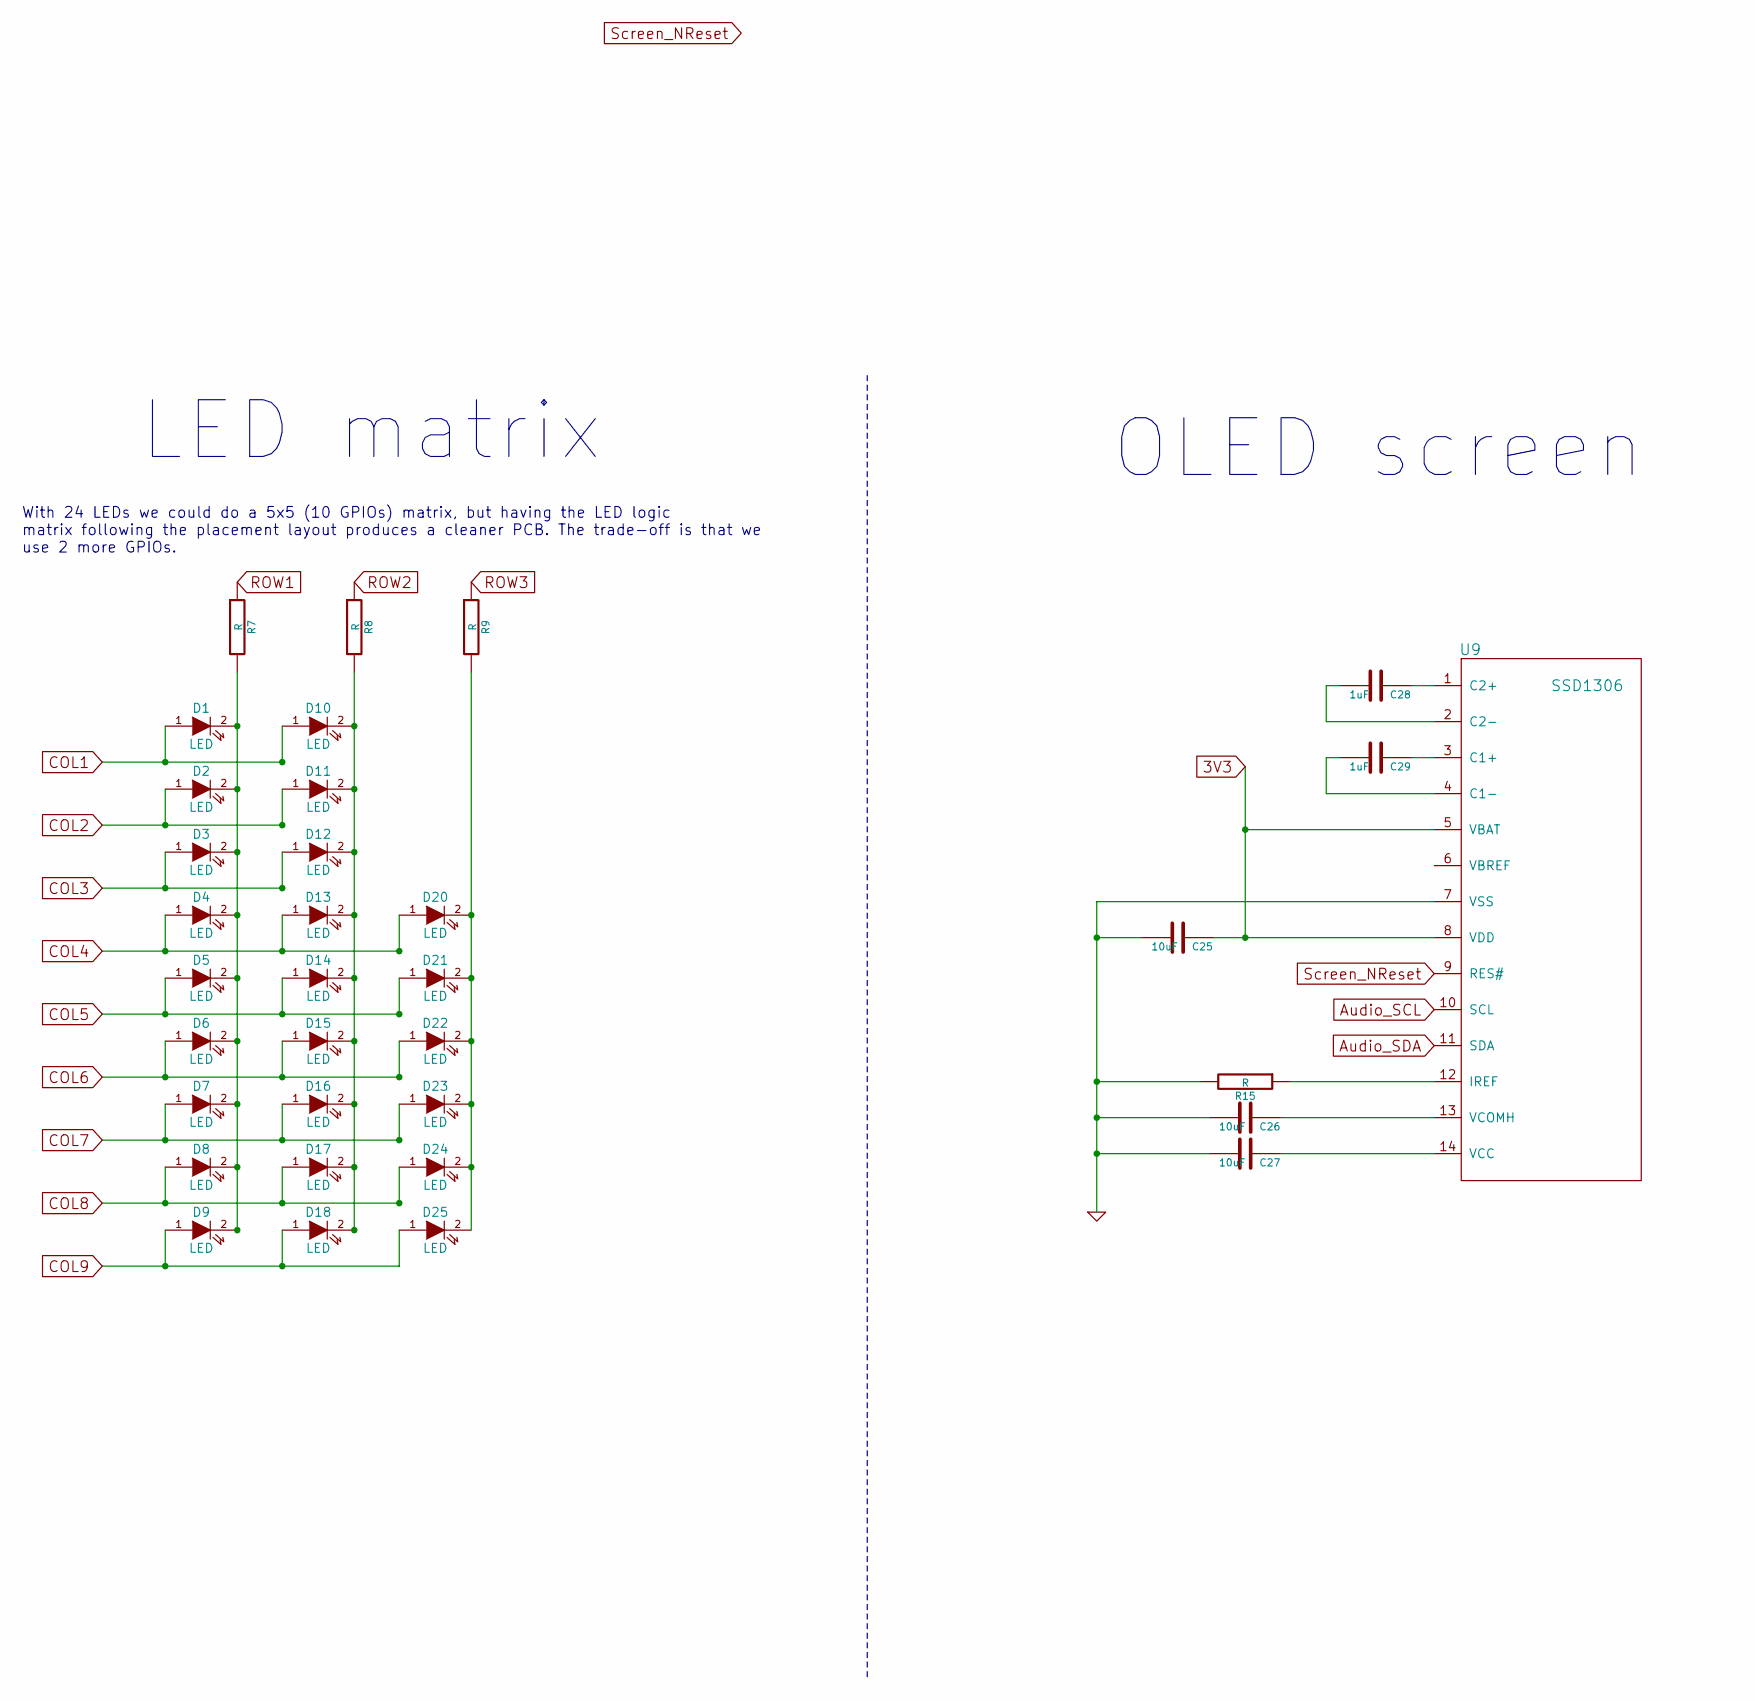
[picture p60: schematic led_matrix.sch, Wee Noise Maker - Discovery]

Parts:
C25, C26, C27: 10uF; C_0805
C28, C29: 1uF; C_0805
D1, D2, D3, D4, D5, D6, D7, D8, D9, D10, D11, D12, D13, D14, D15, D16, D17, D18, D20, D21, D22, D23, D24, D25: LED; LED_0805
R7, R8, R9, R15: R; R_0805
U9: SSD1306; MIDAS_MCOT096016AV_OLED

Connections:
3V3: C25.1, U9.5 (VBAT), U9.8 (VDD); also elsewhere on the board
Audio_SCL: U9.10 (SCL); also elsewhere on the board
Audio_SDA: U9.11 (SDA); also elsewhere on the board
COL1: D1.1 (A), D10.1 (A); also elsewhere on the board
COL2: D2.1 (A), D11.1 (A); also elsewhere on the board
COL3: D3.1 (A), D12.1 (A); also elsewhere on the board
COL4: D4.1 (A), D13.1 (A), D20.1 (A); also elsewhere on the board
COL5: D5.1 (A), D14.1 (A), D21.1 (A); also elsewhere on the board
COL6: D6.1 (A), D15.1 (A), D22.1 (A); also elsewhere on the board
COL7: D7.1 (A), D16.1 (A), D23.1 (A); also elsewhere on the board
COL8: D8.1 (A), D17.1 (A), D24.1 (A); also elsewhere on the board
COL9: D9.1 (A), D18.1 (A), D25.1 (A); also elsewhere on the board
GND: C25.2, C26.2, C27.2, R15.2, U9.7 (VSS); also elsewhere on the board
unnamed: C26.1, U9.13 (VCOMH)
unnamed: C27.1, U9.14 (VCC)
unnamed: C28.1, U9.1 (C2+)
unnamed: C28.2, U9.2 (C2-)
unnamed: C29.1, U9.3 (C1+)
unnamed: C29.2, U9.4 (C1-)
unnamed: D1.2 (K), D2.2 (K), D3.2 (K), D4.2 (K), D5.2 (K), D6.2 (K), D7.2 (K), D8.2 (K), D9.2 (K), R7.2
unnamed: D10.2 (K), D11.2 (K), D12.2 (K), D13.2 (K), D14.2 (K), D15.2 (K), D16.2 (K), D17.2 (K), D18.2 (K), R8.2
unnamed: D20.2 (K), D21.2 (K), D22.2 (K), D23.2 (K), D24.2 (K), D25.2 (K), R9.2
unnamed: R15.1, U9.12 (IREF)
ROW1: R7.1; also elsewhere on the board
ROW2: R8.1; also elsewhere on the board
ROW3: R9.1; also elsewhere on the board
Screen_NReset: U9.9 (RES#); also elsewhere on the board

Notes on the sheet:
With 24 LEDs we could do a 5x5 (10 GPIOs) matrix, but having the LED logic matrix following the placement layout produces a cleaner PCB. The trade-off is that we use 2 more GPIOs.
LED matrix
OLED screen

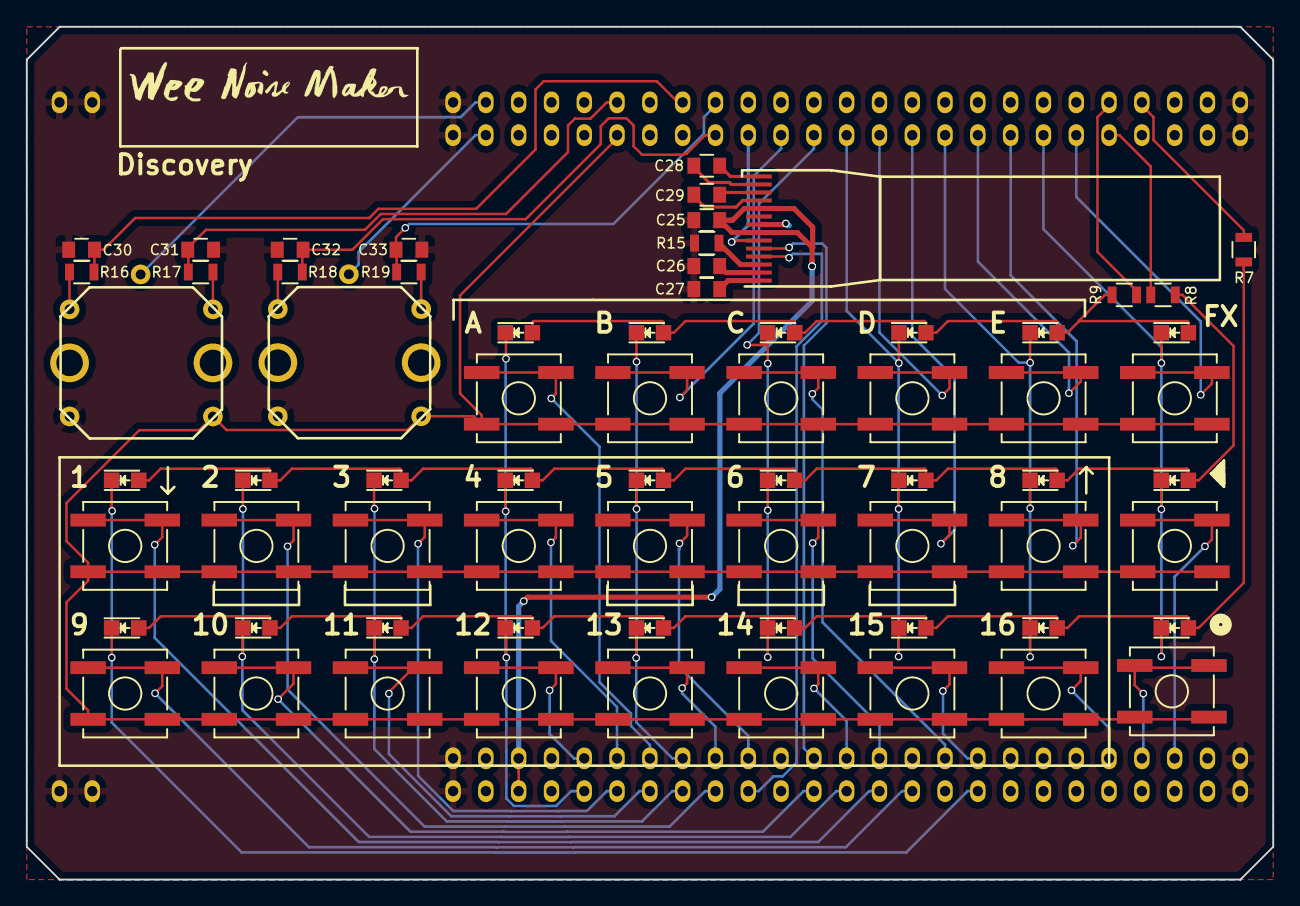
[picture p61: board wnm_discovery.kicad_pcb from above]

Board: 2 copper layers, 96.5 x 66.0 mm, 69 parts (1 on the bottom side), 62 nets.
