Fabien-Chouteau/Wee-Noise-Maker/hardware/discovery/Rev_A/poss_discovery.kicad_pcb

## KiCad design hardware/discovery/Rev_A/poss_discovery.kicad_pcb (2016-12-11, an earlier design)

Schematic: poss_discovery.sch

Parts:
D1, D2, D3, D4, D5, D6, D7, D8, D9, D10, D11, D12, D13, D14, D15, D16, D17, D18, D19, D20, D21, D22, D23, D24, D25: LED; LED_0805
J1, J5: HEADER_2; Pin_Header_Straight_2x01
J2, J3: HEADER_25x2; Pin_Header_Straight_2x25
Play1, Play2: SW_PUSH; SW_SPST_B3SL-1002P
RV1, RV2: POT; Potentiometer_WirePads_Small
SW1, SW2, SW3, SW4, SW5, SW6, SW7, SW8, SW9, SW10, SW11, SW12, SW13, SW14, SW15, SW16, SW17, SW18, SW19, SW20, SW21, SW22: SW_PUSH; SW_SPST_B3SL-1002P
Write1: SW_PUSH; SW_SPST_B3SL-1002P

Connections:
/3V: J3.45, J3.46, RV1.1, RV2.1
/5V: J3.47, J3.48
/Audio_Reset: J3.20
/Audio_SCL: J3.27
/Audio_SDA: J3.32
/B1: J3.42, SW1.1
/B2: J3.40, SW2.1
/B3: J3.37, SW3.1
/B4: J3.31, SW4.1
/B5: J3.26, SW5.1
/B6: J3.23, SW6.1
/B7: J3.22, SW7.1
/B8: J3.17, SW8.1
/B9: J3.28, SW9.1
/B10: J3.41, SW10.1
/B11: J3.39, SW11.1
/B12: J3.38, SW12.1
/B13: J3.35, SW13.1
/B14: J3.25, SW14.1
/B15: J3.24, SW15.1
/B16: J3.19, SW16.1
/BF1: J2.43, SW17.1
/BF2: J2.42, SW18.1
/BF3: J2.12, SW19.1
/BF4: J2.11, SW20.1
/BF5: J2.10, SW21.1
/BOOT0: J3.29
/BPM: J2.9, SW22.1
/COL1: D1.2, D2.2, D3.2, D4.2, D5.2, J3.11
/COL2: D6.2, D7.2, D8.2, D9.2, D10.2, J3.9
/COL3: D11.2, D12.2, D13.2, D14.2, D15.2, J2.38
/COL4: D16.2, D17.2, D18.2, D19.2, D20.2, J2.41
/COL5: D21.2, D22.2, D23.2, D24.2, D25.2, J2.44
/CS_I2C/SPI: J3.36
/FX: J2.7, Play2.1
/GND: J1.1, J1.2, J2.1, J2.2, J2.27, J2.45, J2.49, J2.50, J3.1, J3.2, J3.49, J3.50, J5.1, J5.2, Play1.2, Play2.2, RV1.3, RV2.3, SW1.2, SW2.2, SW3.2, SW4.2, SW5.2, SW6.2, SW7.2, SW8.2, SW9.2, SW10.2, SW11.2, SW12.2, SW13.2, SW14.2, SW15.2, SW16.2, SW17.2, SW18.2, SW19.2, SW20.2, SW21.2, SW22.2, Write1.2
/I2S3_MCK: J3.4
/I2S3_SCK: J3.13
/I2S3_SD: J3.15
/I2S3_WS: J2.36
/MEMS_INT1: J3.33
/MEMS_INT2: J3.34
/NC: J2.4
/NRTS: J2.46
/PA0: J2.40
/PA1: J2.39, RV1.2
/PA3: J2.37, RV2.2
/PA5: J2.35
/PA6: J2.34
/PA7: J2.33
/PA8: D5.1, D10.1, D15.1, D20.1, D25.1, J3.7
/PA9: J3.8
/PA13: D2.1, D7.1, D12.1, D17.1, D22.1, J3.10
/PA15: D3.1, D8.1, D13.1, D18.1, D23.1, J3.12
/PB0: J2.30
/PB1: J2.29
/PB2: J2.28
/PB10: J2.18
/PB11: J2.15
/PB12: J2.16
/PB13: J2.13
/PB14: J2.14
/PC4: J2.32
/PC5: J2.31
/PC6: J3.3
/PC8: J3.5
/PC9: D1.1, D6.1, D11.1, D16.1, D21.1, J3.6
/PC11: D4.1, D9.1, D14.1, D19.1, D24.1, J3.14
/PD0: J3.16, Play1.1
/PD2: J3.18, Write1.1
/PD5: J3.21
/PD12: J2.8
/PD13: J2.5
/PD14: J2.6
/PD15: J2.3
/PE7: J2.25
/PE8: J2.26
/PE9: J2.23
/PE10: J2.24
/PE11: J2.21
/PE12: J2.22
/PE13: J2.19
/PE14: J2.20
/PE15: J2.17
/PH0: J3.43
/PH1: J3.44
/VDD: J2.47, J2.48
/VDD2: J3.30

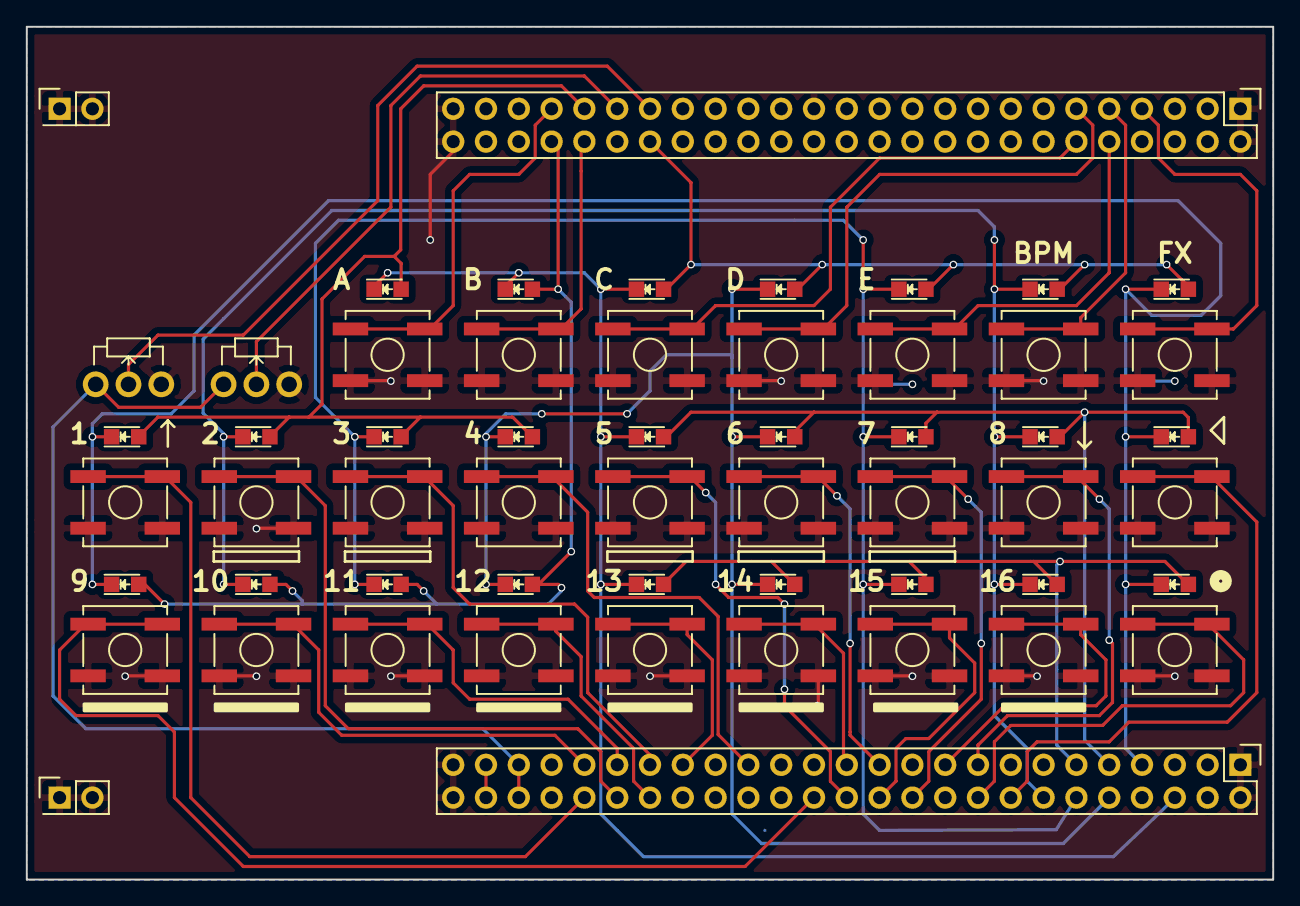
[picture p62: board poss_discovery.kicad_pcb from above]

Board: 2 copper layers, 96.5 x 66.0 mm, 56 parts (0 on the bottom side), 41 nets.
