Fabien-Chouteau/Wee-Noise-Maker/hardware/Mk-I/STM32CubeMX.ioc

Mcu.UserName=STM32F437VITx
PA0/WKUP.Signal=SYS_WKUP
PA1.Signal=S_TIM2_CH2
PA10.Signal=GPIO_Input
PA11.Signal=USB_OTG_FS_DM
PA12.Signal=USB_OTG_FS_DP
PA13.Signal=SYS_JTMS-SWDIO
PA14.Signal=SYS_JTCK-SWCLK
PA15.Signal=I2S3_WS
PA2.Signal=GPIO_Input
PA3.Signal=GPIO_Input
PA4.Signal=GPIO_Output
PA5.Signal=S_TIM2_CH1_ETR
PA6.Signal=S_TIM3_CH1
PA7.Signal=S_TIM3_CH2
PA9.Signal=USB_OTG_FS_VBUS
PB0.Signal=GPIO_Output
PB1.Signal=GPIO_Input
PB10.Signal=GPIO_Input
PB11.Signal=GPIO_Output
PB12.Signal=GPIO_Input
PB13.Signal=GPIO_Input
PB14.Signal=GPIO_Input
PB15.Signal=GPIO_Output
PB3.Signal=I2S3_CK
PB4.Signal=I2S3_ext_SD
PB5.Signal=I2S3_SD
PB6.Signal=I2C1_SCL
PB7.Signal=I2C1_SDA
PC0.Signal=GPIO_Output
PC1.Signal=GPIO_Input
PC10.Signal=SDIO_D2
PC11.Signal=SDIO_D3
PC12.Signal=SDIO_CK
PC14/OSC32_IN.Signal=GPIO_Input
PC15/OSC32_OUT.Signal=GPIO_Input
PC2.Signal=GPIO_Output
PC3.Signal=GPIO_Input
PC4.Signal=GPIO_Input
PC5.Signal=GPIO_Input
PC6.Signal=GPIO_Input
PC7.Signal=I2S3_MCK
PC8.Signal=SDIO_D0
PC9.Signal=SDIO_D1
PD10.Signal=GPIO_Input
PD11.Signal=GPIO_Output
PD12.Signal=GPIO_Output
PD13.Signal=GPIO_Output
PD14.Signal=GPIO_Output
PD15.Signal=GPIO_Input
PD2.Signal=SDIO_CMD
PD8.Signal=GPIO_Input
PD9.Signal=GPIO_Input
PE10.Signal=GPIO_Input
PE11.Signal=GPIO_Input
PE12.Signal=GPIO_Input
PE13.Signal=GPIO_Output
PE14.Signal=GPIO_Input
PE15.Signal=GPIO_Input
PE7.Signal=GPIO_Input
PE8.Signal=GPIO_Input
PE9.Signal=GPIO_Output
PH0/OSC_IN.Signal=RCC_OSC_IN
PH1/OSC_OUT.Signal=RCC_OSC_OUT
