Fabien-Chouteau/Wee-Noise-Maker/(commit log)

2016-12-11 Add first version of the discovery
    [poss_discovery.kicad_pcb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]
2016-12-21 Add known problems to the RevA schematics
    [poss_discovery.sch]
2016-12-21 Start RevB of the discovery board
    - Fix RevA known problems
    - Custom scheme and footprint for the headers
    - Improved silkscreen
    [poss_discovery.kicad_pcb, poss_discovery.sch]
2016-12-21 Discovery: Start power section
    [micro-controller.sch, poss_discovery.kicad_pcb, poss_discovery.sch, power.sch]
2016-12-21 Discovery: add the MCU
    [micro-controller.sch, poss_discovery.kicad_pcb, poss_discovery.sch]
2016-12-21 Discovery: Fix channel button labels
    [micro-controller.sch, poss_discovery.sch, power.sch]
2016-12-21 Discovery: Fix volume symbol
    [poss_discovery.kicad_pcb]
2016-12-23 Discovery start power section
    [micro-controller.sch, poss_discovery.kicad_pcb, poss_discovery.sch, power.sch]
2016-12-23 Discovery: switch to a 9x3 LED matrix to simplify the PCB layout
    [led_matrix.sch, micro-controller.sch, poss_discovery.kicad_pcb, poss_discovery.sch, power.sch]
2016-12-23 Discovery: SMT2F4 grounding
    [micro-controller.sch, poss_discovery.kicad_pcb]
2016-12-23 Discovery: Fix battery connector orientation
    [poss_discovery.kicad_pcb]
2016-12-23 Discovery: Start audio schematic
    [audio.sch, led_matrix.sch, micro-controller.sch, poss_discovery.sch, power.sch]
2016-12-23 Software: Add first prototype of SW for RevA board
2016-12-24 Discovery: Add audio DAC
    [audio.sch, micro-controller.sch, poss_discovery.kicad_pcb]
2016-12-24 Discovery: Connect all button to the wakeup pin
    [audio.sch, micro-controller.sch, poss_discovery.kicad_pcb, poss_discovery.sch, power.sch]
2016-12-25 Discovery: add crystal
    [audio.sch, micro-controller.sch, poss_discovery.kicad_pcb, poss_discovery.sch]
2016-12-25 Discovery: improve LED/button matrix layout
    [poss_discovery.kicad_pcb]
2016-12-27 Discovery: STM32F4 power a filtering
    [audio.sch, micro-controller.sch, poss_discovery.kicad_pcb, poss_discovery.sch, power.sch]
2016-12-27 Discovery: Fix pull-ups and add LED current limiters
    [led_matrix.sch, micro-controller.sch, poss_discovery.kicad_pcb, power.sch]
2016-12-27 Discovery: Start routing LEDs and buttons
    [micro-controller.sch, poss_discovery.kicad_pcb, poss_discovery.sch]
2016-12-27 Discovery LEDs and button routing part 2
    [micro-controller.sch, poss_discovery.kicad_pcb]
2016-12-28 Discovery: Add micro SD card
    [audio.sch, micro-controller.sch, poss_discovery.kicad_pcb, power.sch]
2016-12-28 Discovery: End of LEDs and buttons routing
    [audio.sch, micro-controller.sch, poss_discovery.kicad_pcb]
2016-12-28 Discovery: Add audio jacks
    [audio.sch, poss_discovery.kicad_pcb]
2016-12-28 Discovery: Move SD card socket
    [audio.sch, micro-controller.sch, poss_discovery.kicad_pcb, poss_discovery.sch, power.sch]
2016-12-28 Discovery: finish power routing
    [poss_discovery.kicad_pcb]
2016-12-28 Discovery: Add OLED screen
    [audio.sch, led_matrix.sch, micro-controller.sch, poss_discovery.kicad_pcb, poss_discovery.sch, power.sch]
2016-12-29 Discovery: Add two encoders and remove the BPM button
    BPM and volume will be changed with a long press of the play button and
    the encoders
    [audio.sch, led_matrix.sch, micro-controller.sch, poss_discovery.sch, poss_discovery_2_encoders.kicad_pcb, power.sch]
2016-12-30 Discovery: Add encoders noise filtering
    [audio.sch, led_matrix.sch, micro-controller.sch, poss_discovery.kicad_pcb, poss_discovery.sch, power.sch]
2016-12-31 Discovery: Add debug port and adjust screen position
    [audio.sch, led_matrix.sch, micro-controller.sch, poss_discovery.kicad_pcb, poss_discovery.sch, power.sch]
2017-01-01 Discovery: relocation of screen capa and resistor
    [poss_discovery.kicad_pcb]
2017-01-01 Discovery: Move the screen to the right
    and put on connector on the front side.
    [poss_discovery.kicad_pcb]
2017-01-01 Discovery: Connect VBAT to the MCU
    [micro-controller.sch, poss_discovery.kicad_pcb]
2017-01-01 Discovery: Increase all components ref to 0.8 font size
    [poss_discovery.kicad_pcb]
2017-01-01 Discovery: Update TODO list
    [poss_discovery.sch]
2017-01-01 Discovery: A couple of iimprovements in layout
    [poss_discovery.kicad_pcb]
2017-01-01 Split Discovery edition and stand alone (Mk-I)
    [audio.sch, led_matrix.sch, micro-controller.sch, poss_mk_1.kicad_pcb, poss_mk_1.sch, power.sch]
2017-01-01 Discovery: Restart from RevA
    [audio.sch, led_matrix.sch, micro-controller.sch, poss_discovery.kicad_pcb, poss_discovery.sch, poss_discovery_2_encoders.kicad_pcb, power.sch]
2017-01-01 Discovery: Use shared components and footprints
    [poss_discovery.kicad_pcb]
2017-01-02 Move LED matrix scanning to an timer interrupt
    instead of a task.
2017-01-05 Add SJ3523 audio jack footprint
2017-01-05 Mk-I: A couple of fixes in silkscreen
    [poss_mk_1.kicad_pcb]
2017-01-05 MK-I : Decrease mask clearance to ~3mil
    [poss_mk_1.kicad_pcb]
2017-01-05 Try footprint of PEC11S SMT encoders
    The profile is low (14mm) but the foot print is too big (18x12mm).
2017-01-05 Add encoder 3D models
    [EC12D.FCStd, EC12D_knob.FCStd]
2017-01-05 Use encoder 3D models with the PCB design
    [poss_mk_1.kicad_pcb]
2017-01-07 Update TODO list
    [poss_mk_1.sch]
2017-01-07 Rename project: Wee Noise Maker!
    [wnm_discovery.kicad_pcb, wnm_discovery.sch, wnm_mk_1.kicad_pcb, wnm_mk_1.sch]
2017-01-07 Move battery connector to make room for the logo
    [wnm_mk_1.kicad_pcb]
2017-01-07 Trying some logo designs
    [wnm_mk_1.kicad_pcb]
2017-01-07 Fix GND connection
    [wnm_mk_1.kicad_pcb]
2017-01-07 Update page layouts
    [audio.sch, led_matrix.sch, micro-controller.sch, power.sch, wnm_mk_1.kicad_pcb, wnm_mk_1.sch]
2017-01-08 Cleanup schematics
    [audio.sch, led_matrix.sch, micro-controller.sch]
2017-01-08 Fix VBUS track width
    [wnm_mk_1.kicad_pcb]
2017-01-08 Add mounting hole
    [wnm_mk_1.kicad_pcb, wnm_mk_1.sch]
2017-01-10 HW: Fix path to 3D model
    [wnm_mk_1.kicad_pcb]
2017-01-10 HW: Hide mounting hole silkscreen ref
    [wnm_mk_1.kicad_pcb]
2017-01-10 HW: Change most of signal traces to 0.16mm
    [wnm_mk_1.kicad_pcb]
2017-01-10 HW: Add a DFU mode switch
    [audio.sch, led_matrix.sch, micro-controller.sch, power.sch, wnm_mk_1.kicad_pcb, wnm_mk_1.sch]
2017-01-14 HW: Minor improvement in PCB rounting
    [wnm_mk_1.kicad_pcb]
2017-01-15 HW: Update discovery with new UI design (encoders, screen, buttons layout)
    [audio.sch, led_matrix.sch, micro-controller.sch, power.sch, wnm_discovery.kicad_pcb, wnm_discovery.sch]
2017-01-15 HW: Update TODO list
    [wnm_mk_1.sch]
2017-01-15 HW: Add discovery Rev-A schematics PDF
2017-01-15 HW: Add screen reset line and some ground path tweaking
    [micro-controller.sch, wnm_mk_1.kicad_pcb]
2017-01-15 HW: Use a different MCU pins for the discovery board
    This simplifies the PCB layout.
    [led_matrix.sch, micro-controller.sch, wnm_discovery.kicad_pcb, wnm_discovery.sch]
2017-01-15 HW:Update revision of the discovery board
    [led_matrix.sch, micro-controller.sch, wnm_discovery.kicad_pcb, wnm_discovery.sch]
2017-01-15 HW: Remove useless reference on discovery board
    [wnm_discovery.kicad_pcb]
2017-01-15 HW: Discovery Rev B
    [wnm_discovery-B.Cu.gbl, wnm_discovery-B.Mask.gbs, wnm_discovery-B.SilkS.gbo, wnm_discovery-Edge.Cuts.gm1, wnm_discovery-F.Cu.gtl, wnm_discovery-F.Mask.gts, wnm_discovery-F.SilkS.gto, wnm_discovery.drl]
2017-01-15 HW: Wee Noise Maker Mk-I Rev B
    [wnm_mk_1-B.Cu.gbl, wnm_mk_1-B.Mask.gbs, wnm_mk_1-B.SilkS.gbo, wnm_mk_1-Edge.Cuts.gm1, wnm_mk_1-F.Cu.gtl, wnm_mk_1-F.Mask.gts, wnm_mk_1-F.SilkS.gto, wnm_mk_1.drl]
2017-01-16 HW: Crank knob for the EC12D encoders
    [EC12D_crank.FCStd]
2017-01-17 HW: fix know and crank 3D models
    [EC12D_crank.FCStd, EC12D_knob.FCStd, crank.stl, crank_knob.stl, knob.stl]
2017-01-22 Fix exposed crystal trace by R6 pad mask
    [wnm_mk_1.kicad_pcb]
2017-03-06 Add picture of new boards
2017-03-06 HW: Start Mk-I rev-A known problems
    [led_matrix.sch, micro-controller.sch, wnm_mk_1.sch]
2017-03-06 HW: known problems cont.
    [wnm_mk_1.sch]
2017-03-06 HW: Fix DAC coupling caps
    [audio.sch, wnm_mk_1.kicad_pcb, wnm_mk_1.sch]
2017-03-06 HW: Improve ground layout
    [wnm_mk_1.kicad_pcb]
2017-03-06 HW: Fix regulator footprint
    [power.sch, wnm_mk_1.kicad_pcb, wnm_mk_1.sch]
2017-03-06 HW: Fix encoders footprint
    [audio.sch, led_matrix.sch, micro-controller.sch, power.sch, wnm_mk_1.kicad_pcb, wnm_mk_1.sch]
2017-03-06 HW: Add revision text
    [wnm_mk_1.kicad_pcb]
2017-03-06 HW: Improving ground again
    [wnm_mk_1.kicad_pcb]
2017-03-06 HW: Improve regulator footprint
    [wnm_mk_1.kicad_pcb]
2017-03-06 HW: Use filled white boxes for all keyboard keys
    [wnm_mk_1.kicad_pcb]
2017-03-11 HW: Add I2C debug/extension connector
    [audio.sch, led_matrix.sch, micro-controller.sch, wnm_mk_1.kicad_pcb]
2017-03-11 HW: Improve oscillator layout
    [micro-controller.sch, wnm_mk_1.kicad_pcb]
2017-03-12 HW: Divide VBAT before connecting to the MCU
    [micro-controller.sch, power.sch, wnm_mk_1.kicad_pcb]
2017-03-12 HW: Increase board size
    [wnm_mk_1.kicad_pcb, wnm_mk_1.sch]
2017-03-18 HW: Mk-I rev-B
    [wnm_mk_1-B.Cu.gbl, wnm_mk_1-B.Mask.gbs, wnm_mk_1-B.SilkS.gbo, wnm_mk_1-Edge.Cuts.gm1, wnm_mk_1-F.Cu.gtl, wnm_mk_1-F.Mask.gts, wnm_mk_1-F.SilkS.gto, wnm_mk_1.drl]
2017-03-19 HW: Add rev-B BOM
    [wnm_mk_1_rev_B_BOM.csv]
2017-04-08 HW: Start rev-C with DAC VDDD fix
    [audio.sch, led_matrix.sch, micro-controller.sch, power.sch, wnm_mk_1.kicad_pcb, wnm_mk_1.sch]
2017-04-09 HW: A couple of improvements in layout and ground
    [wnm_mk_1.kicad_pcb]
2017-04-18 HW: Enlarge screen footprint
    To give room for more models.
    [wnm_mk_1.kicad_pcb]
2017-04-22 Add encoder support
2017-04-22 Add I2C init package
2017-05-08 HW: Mk-I rev-C
    [wnm_mk_1-B.Cu.gbl, wnm_mk_1-B.Mask.gbs, wnm_mk_1-B.SilkS.gbo, wnm_mk_1-Edge.Cuts.gm1, wnm_mk_1-F.Cu.gtl, wnm_mk_1-F.Mask.gts, wnm_mk_1-F.SilkS.gto, wnm_mk_1.drl]
2017-07-22 WNM.I2C: Use DMA for TX
2017-07-22 WNM.UI: Set volume and BPM with encoders
2017-07-23 HW: Update parts value
    [audio.sch, led_matrix.sch, micro-controller.sch, power.sch, wnm_mk_1.kicad_pcb, wnm_mk_1.sch]
2017-07-23 Move encoders handling to the UI task
2017-08-06 Start sample streams
2017-08-18 Start track panning
2017-08-18 WNM.SDCard: Mount the SDCard with File_IO
2017-08-18 WNM.Sample_Stream: Increase sample capacity
2017-08-18 Main: Init SDCard and sample stream
2017-08-19 Tentative switch to a different input paradigm
    Sample pattern editing is now the main mode.
2017-08-19 Fix LED showing step progress
2017-08-27 Start sample library package
2017-08-27 WNM.Sample_Stream: Start recording system
2017-09-02 WNM.GUI.Menu.Sample_Select: Change interface
2017-09-02 Add per track volume control
2017-09-02 Switch from stereo to mono samples
2017-09-02 Add per track mute control
2017-09-02 WNM.UI: Turn on LEDs by row (failed experiment)
    ...instead of one by one.
    The idea was to have less interrupts by handling all the LEDs in the
    same raw at the same time.
    In practice,powering multiple LEDs at the same time is not great as they
    will not have the same brightness, especially when the LEDs are not of
    the same color.
    I put this patch in to log the experiment.
2017-09-02 WNM.UI: Revert previous LED patch but keep the brightness levels
2017-09-02 Move LED handling to a separate package
2017-09-24 WNM.Sample_Stream: Add support for the create sample feature
2017-09-24 WNM.GUI.Menu: Start the Create sample menu
2017-09-24 Quick_Synth: Improve support for sample recording
2017-09-28 WNM.GUI.Menu.Create_Sample: Copy the new sample in the user dir
2017-09-28 WNM.UI: Stop the blinking of the record/edit LED
    The play LED is already blinking so this is just extra "noise".
2017-09-28 WNM.Sample_Library: Add a function to register a user sample after loading
2017-09-28 Quick_Synth: Add a procedure to assign a sample to a track
2017-09-28 WNM.GUI.Menu.Create_Sample: Implement the assign to track feature
2017-10-14 WNM.GUI: Disaplay track number and sample name
2017-10-21 HW: TODO list for the next revision
    [wnm_mk_1.sch]
2017-10-21 HW: Change crystal for a smd package
    [audio.sch, led_matrix.sch, micro-controller.sch, wnm_mk_1.kicad_pcb]
2017-10-21 HW: Change battery connector to SMD
    [power.sch, wnm_mk_1.kicad_pcb, wnm_mk_1.sch]
2017-10-21 HW: Major change of layout...
    [audio.sch, led_matrix.sch, micro-controller.sch, power.sch, wnm_mk_1.kicad_pcb, wnm_mk_1.sch]
2017-10-21 HW: Change micro SD card slot
    [audio.sch, led_matrix.sch, micro-controller.sch, power.sch, wnm_mk_1.kicad_pcb, wnm_mk_1.sch]
2017-10-22 HW: Use folded foot print for the OLED screen
    [wnm_mk_1.kicad_pcb]
2017-10-22 HW: Add 3D models
    [SJ_352X_SMT.fcstd]
2017-10-22 HW: Add missing schematic
    [button_matrix.sch]
2017-10-22 HW: Change 3.5 socket and put them on top
    [audio.sch, wnm_mk_1.kicad_pcb]
2017-10-28 HW: Finish rev-D layout
    [button_matrix.sch, led_matrix.sch, micro-controller.sch, power.sch, wnm_mk_1.kicad_pcb, wnm_mk_1.sch]
2017-10-29 HW: rev D production files
    [button_matrix.sch, led_matrix.sch, micro-controller.sch, power.sch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]
2017-12-03 Refactoring button handling in a separate package
2017-12-03 WNM.UI: Remove encoder value multiplication
    With the latest hardware with don't need to that anymore, because the
    encoder signals are clean.
2017-12-03 WNM.Battery: Start a battery monitoring package
2017-12-03 WNM.Encoders: Move hardware specific declartions to the body
2017-12-03 WNM.Power_Control: Start power control package
2021-05-24 Switch MIDI out to DMA
2021-09-10 Switch simulator to SFML
2021-10-25 Microsecond time and PIO rotary encoders
